cyborgroid/Retro_Analog_Pastel_Computer/cad/README.md

# CAD v3 — 실제 제작용 형상 (STEP · URDF · USDA · 3D 프린팅)

`spec.json` 하나를 원본으로 Rust가 B-rep 솔리드를 만들고, 같은 형상을 여러 형식으로 내보냅니다. 한 번 빌드하면 두 가지 판이 함께 나옵니다.

| 판 | 출력 폴더 | 내용 |
|---|---|---|
| **실제 제작판** | `cad/out/build/` | 지금 살 수 있는 부품과 3D 프린터로 만드는 구성. 19" LCD 패널, 12 V 어댑터, 출력 하우징(베드에 맞게 자동 분할 + 이음), 구매 목록(BOM), 출력 계획, 스위치 플레이트 DXF |
| 컨셉판 (CRT) | `cad/out/` | 워크벤치가 시뮬레이션하는 레트로 CRT 설계 |

웹 워크벤치의 Chassis 탭은 두 판을 모두 표시합니다(기본: 실제 제작판).

```
cad/spec.json ──▶ cad/rust (pastella-cad, truck B-rep) ──▶ cad/out/pastella84.step        STEP AP214, 부품 이름·색, mm
                                                      ├─▶ cad/out/urdf/pastella84.urdf  URDF + STL(링크별·재질별), 질량·관성
                                                      ├─▶ cad/out/pastella84.usda       OpenUSD + UsdPreviewSurface + UsdPhysics
                                                      ├─▶ cad/out/web/pastella84.glb    웹 워크벤치용 glTF (링크 계층 + 관절 정보)
                                                      ├─▶ cad/out/report.json           치수 · 질량 · 검사 결과
                                                      ├─▶ src/js/data/cad.js            워크벤치가 읽는 요약
                                                      └─▶ environments/chassis/dimensions.csv
                   cad/csharp (Pastella.Validate) ──▶ cad/out/validation.md          산출물 교차 검증

실제 제작판은 같은 형식을 cad/out/build/ 에 내고, 추가로:
  cad/out/build/print/*.stl      출력 조각 (베드 위 출력 방향으로 놓인 상태, mm)
  cad/out/build/print-plan.md    조각별 크기 · 무게 · 시간 · 서포트 면적, 분할 이음 목록
  cad/out/build/bom.csv          구매 부품 · 체결 부품 · 출력 부품
  cad/out/build/fab/kb_plate.dxf 키보드 스위치 플레이트 (FR4 1.5t 주문용)
```

## 빌드

```
./cad/build.sh rust          # Only Rust: 형상 생성 + 내보내기 + Rust 자체 검사
./cad/build.sh csharp-rust   # 위와 같은 Rust 빌드 + C# 독립 검증 (기본값)
./cad/build.sh rust --palette "Lavender Haze"   # 컬러웨이 변경 (environments/chassis/colorways.json)
```

필요한 도구: Rust(cargo) 1.80 이상, .NET SDK 10. 처음 빌드할 때 crates.io에서 의존성을 받습니다. 두 판 전체 빌드는 약 22초(대부분 출력 조각 메시 불리언), C# 검증까지 약 25초가 걸립니다. 검사가 하나라도 실패하면 종료 코드 1을 반환합니다.

워크벤치는 `./run.sh`로 연 뒤 터미널에 나오는 **Open Integrated Browser** 주소로 들어갑니다. GLB는 HTTP로만 불러올 수 있어서 `file://`로 열면 웹 v2 모델이 대신 표시됩니다.

## 실제 제작판 — 지금 사서 만들기

### 컨셉판에서 바뀐 것과 이유

| 항목 | 컨셉판 | 실제 제작판 | 이유 |
|---|---|---|---|
| 화면 | 19" 16:10 CRT | **AUO M190PW01 V8** (19" 1440 × 900, LED) + HDMI/VGA/AV 컨트롤러 보드 | 새 CRT는 생산되지 않음. 표시 영역 408 × 255 mm가 컨셉의 화면 크기와 같음 |
| 베젤 | 12 mm | 21 mm | 패널 외곽(428 × 278)과 셸 벽 사이에 클립 나사를 박을 폭이 필요 |
| 모니터 셸 | 뒤가 막힌 일체형 | 앞 45 mm 직선 + 테이퍼, 뒤 덮개 분리, 손잡이 따로 출력 | 패널과 클립이 들어갈 공간, 서포트 없는 출력, 조립 접근 |
| 전원 | 내부 220 V EI 트랜스 | **외부 12 V 5 A DC 어댑터(KC)** + LM2596 5 V 강압 모듈 + 패널 DC 잭 | 출력한 플라스틱 케이스 안에 상용 전원을 넣지 않음 |
| 본체 프레임 | SPCC 판금 | 트레이 바닥의 인서트 보스 6개에 메인보드 직결 | 판금 가공 없이 조립 |
| 상판 ↔ 트레이 | — | 모서리 나사 기둥 4개 (M3 × 35, 아래에서 체결) | |
| 키보드 플레이트 | 강판 | **FR4 1.5t** (PCB 업체 주문, DXF 제공), 나사 구멍 4개, 하판 출력 | PCB 업체에서 싸게 주문 가능 |
| 마우스 | 볼 + 초퍼 | **PMW3360 광학 센서** + D2F 마이크로스위치 + RP2040 Zero | 볼 마우스 부품은 신품이 없음 |
| 다이얼 · 노브 | 형상만 | 16 mm 가변저항 · EC11 엔코더 + 축 구멍(Ø6.2) 있는 출력 노브 | |
| 스위블 | 형상만 | 75 mm 레이지수잔 베어링 | |

### 3D 프린팅

- 기준 프린터: 256 mm급(Bambu Lab P1S · A1, Prusa Core One), 가장자리 여유 4 mm. `spec.json`의 `build.printer`를 바꾸면 분할이 다시 계산됩니다.
- 하우징 그룹마다 서포트가 덜 필요한 방향으로 돌린 뒤, 베드에 들어가도록 자동 분할합니다(상판 · 트레이 · 베젤 · 셸 4조각, 덮개 · 키보드 케이스 · 하판 2조각).
- **분할 이음**: 분할면 안쪽 벽에 결합부를 자동 배치합니다. 이음선 양쪽 13 mm에 M3 인서트 보스 한 쌍을 두고, 그 위에 38 × 9 × 3 mm 연결판을 놓습니다. 보스 밑이 단단한 벽인지, 다른 부품이나 다른 이음과 부딪히지 않는지 검사해서 통과한 자리만 씁니다.
- 결과: 조각 94개, PLA 약 4.5 kg(1 kg 스풀 5개), 출력 시간 하한 약 83시간. 조각별 수치는 `cad/out/build/print-plan.md`에 있습니다. 220 mm급 프린터에서는 큰 조각(상판 · 베젤 · 셸 등)이 들어가지 않습니다.
- 인서트 구멍(Ø4.1 × 6.7)은 프린터마다 수축이 달라서, 먼저 작은 시험 출력으로 맞추세요.

### 조립 순서

1. 출력 조각에 열압입 인서트를 넣습니다(납땜인두 200–220 °C, 수직으로 천천히).
2. 각 하우징 조각을 맞대고 연결판을 M3 × 8로 고정합니다. 맞댄 면에 접착제를 함께 쓰면 더 단단합니다.
3. **본체**: 트레이 보스에 메인보드(M3 × 6) → Gotek · 스피커 · 강압 모듈 · DC 잭 배선 → 상판 앞면에 가변저항 · 토글 · LED 장착 → 상판을 덮고 트레이 아래에서 M3 × 35 네 개로 고정합니다.
4. **모니터**: 베젤을 앞면이 아래로 가게 놓고 패널을 얹은 뒤 클립 8개(M3 × 25)로 고정합니다. 셸을 씌우고 바닥 M3 × 10 두 개로 베젤 블록에 고정한 다음, 뒤 개구부로 손을 넣어 컨트롤러 보드를 바닥 보스(M3 × 6)에 고정합니다. 덮개를 닫고(M3 × 8 네 개) 손잡이를 안쪽에서 고정합니다(M3 × 8 두 개).
5. **스탠드**: 받침 → 레이지수잔 베어링 → 목 → 크래들 순으로 쌓고, 모니터 바닥의 로커를 크래들에 올립니다. 틸트를 유지하려면 로커와 크래들 사이에 펠트를 붙이세요. 무게중심이 축보다 약 120 mm 위에 있습니다.
6. **키보드**: FR4 플레이트에 스위치와 스태빌라이저 → PCB 납땜(또는 핸드와이어) → 플레이트를 케이스 보스에 M2.5 태핑 나사로 고정 → 키캡 → 하판(M3 × 6 네 개)을 닫습니다.
7. **마우스**: 바닥판에 센서 모듈(M2 × 6)과 마이크로스위치 → RP2040 Zero 배선 → 몸체를 덮고 바닥에서 M3 × 6 네 개로 고정합니다.

### 안전 · 확인할 것

- 12 V 어댑터는 KC 인증품을 쓰세요. 모니터 컨트롤러 보드와 본체 강압 모듈에 전원을 나눠 줍니다. 합계 전류(패널 보드 약 2–3 A + 본체 1 A 미만)를 넘지 않게 하세요.
- 패널 · 컨트롤러 보드 치수는 판매처 자료를 기준으로 했습니다. 패널 뒷면 라벨의 정확한 모델명(V8 · LED 백라이트)과 LVDS 커넥터를 구매 전에 확인하세요. 보드 외형은 150 × 90 × 25 mm 덮개 공간으로만 잡았습니다.
- PLA는 60 °C 근처에서 물러집니다. 직사광선이나 뜨거운 차 안에는 두지 말고, 필요하면 PETG로 출력하세요(밀도만 `build.filament`에서 바꾸면 됩니다).

## 두 파이프라인의 역할 (중복 없음)

| | Only Rust | C# & Rust |
|---|---|---|
| 형상 정의 · 생성 | Rust (`model.rs`, `geom.rs`) | 같은 Rust 코드 |
| 질량 · 관성 | Rust (폐곡면 다면체 적분) | 같은 Rust 결과 |
| 형상 검사 (밀폐 · 간섭 · 관절 스윕) | Rust (`check.rs`) | 같은 Rust 결과 |
| 내보내기 | Rust (`export.rs`) | 같은 Rust 결과 |
| 산출물 교차 검증 | — | C# (`Pastella.Validate`): URDF ↔ USDA ↔ STEP ↔ GLB ↔ report ↔ spec |

형상은 Rust에만 정의되어 있습니다. C#은 형상을 다시 만들지 않고, 내보낸 파일을 다시 읽어 서로 맞는지만 확인합니다. 이전의 Python(OpenCASCADE) 생성기는 같은 형상을 두 번 정의하는 중복이라 제거했습니다.

## 검사 항목

**Rust 자체 검사 (`report.json` → `checks`)**

- 모든 부품이 닫힌 솔리드인지 (테셀레이션 메시가 열린 모서리 없이 닫혀야 함)
- 기본 자세에서 모든 부품 쌍의 겹침 부피 (삼각형 분리축 판정 + 점 샘플링, 1 mm³ 초과면 실패)
- 가동 관절 63개 스윕: 회전 관절은 하한·상한, 직선 관절은 끝까지, 연속 관절은 90°·180°·270°에서 움직이는 부분과 나머지 부품의 간섭
- STEP을 다시 파싱해 솔리드 수가 맞는지

**C# 독립 검증 (`validation.md`)**: URDF 트리(단일 루트 · 비순환), 링크별 질량 > 0 · 관성 양의 정부호 · 삼각 부등식, STL 밀폐성, 키 49개 = 직선 관절 49개 · 키 이동 4 mm · 틸트/스위블 한계가 spec과 일치, USDA와 URDF의 질량 · 관절 · 한계 일치(도 ↔ 라디안), STEP 스키마 · 단위 · 부품 이름 · 색 · 참조, GLB 노드. 산출물에 일부러 결함을 넣었을 때 실패하는 것도 확인했습니다(USDA 질량 변조, STEP 색 삭제, URDF 관절 타입 변경, STL 정점 이동).

**외부 도구 확인 (빌드 과정에는 포함되지 않음, 개발 중 수동 확인)**: OpenCASCADE가 STEP 솔리드 234개를 모두 읽었고 BRepCheck 불량 0건, 전체 부피는 Rust 계산과 0.03 % 이내였습니다. Pixar USD가 USDA를 열었고(메시 148 · 강체 69 · 관절 69), ROS 2 `check_urdf`가 URDF를 파싱했으며, Blender가 GLB를 렌더링했습니다.

## 참고 사진에서 배운 것

실물 사진 148장(목록과 라이선스: [environments/chassis/references.md](../environments/chassis/references.md))에서 얻은 형태 언어를 v3에 반영했습니다.

| 참고한 실물 | 관찰 | v3 반영 |
|---|---|---|
| 모든 실물 키보드 (C64C, MSX, Canon Cat) | 키 피치 19.05 mm, 기성 키캡 규격 | 피치 31 → **19.05 mm**, MX 호환 플레이트(1.5 mm 강판, 14 mm 컷아웃, 6.25u 스태빌라이저 컷아웃), SHIFT · ENTER 1.75u, SPACE 6.25u |
| C64C, MSX | 쐐기형 케이스, 뒤쪽 접이식 다리 | 6.1° 쐐기 케이스, 접이식 다리 2개(0–95°) |
| MSX HitBit, Canon Cat, Amstrad | 기능 키만 다른 색 | 넓은 키는 포인트 색(keyB) |
| Macintosh Color Classic | 화면이 한 단 들어간 액자형 베젤 | 화면 둘레 8 mm 폭 · 6 mm 깊이 계단 리세스 |
| Color Classic, iMac G3 | 평평한 바닥, 뒤로 갈수록 좁아지는 몸체 | 바닥은 평평하게, 윗면만 뒤로 기울어진 후면 셸(뒷면 60 % × 70 %) |
| iMac G3, Canon Cat, Sharp X68000 | 무거운 본체에 손잡이 | 후면 나사 고정식 손잡이(손가락 공간 88 × 26 mm) |
| CRT 실물 비례 | 19" CRT를 154 mm 깊이로 만들 수 없음 | 125° 슈퍼슬림 CRT 기준 깊이 **266 mm** (0.52 × 대각 mm + 베젤 15) |
| Apple IIc (Snow White) | 측면 가로 홈 | 본체 측면 가로 슬롯 통풍구 3열 × 5단 |
| Bandai Pippin | 원형 타공 스피커 그릴 | 스피커 위 Ø3.2 타공 42개 |
| Sega SC-3000, Apple 로고 | 컬러 스트라이프 | 본체 전면과 키보드에 파스텔 4색 스트라이프 |
| MSX (투톤) | 하부는 진하고 상부는 밝음 | 하부 트레이를 본체 색의 88 % 명도로 |
| Apple M0100 마우스 | 버튼이 분리된 판 | 박스형 몸체 + 경첩식 버튼 판(3° 누름) |

### 이미지 데이터 학습 (자동 분석)

`tools/refs/`가 레퍼런스 이미지를 대량으로 받아 분석합니다. 이 작업 시점에는 Wikimedia Commons 레트로 컴퓨터 사진 2,578장을 모았고, 그중 다운로드가 끝난 568장(중복 제거 후)으로 분석했습니다. 수집은 1만 장을 목표로 계속되며, 다시 실행하면 결과가 갱신됩니다. 요약은 [references-web.md](../environments/chassis/references-web.md)에 있습니다.

| 분석 결과 | 설계 반영 |
|---|---|
| 실물 기기의 주색은 베이지 · 크림(#cfc3ac 15.7 %, #c0b4a1 15.3 %, #ded2bb 12.8 %), 포인트는 하늘 · 청회색(#81abd0, #a8b9c8)과 피치(#e0a087) | 학습 컬러웨이 **Archive Beige**(실물 색)와 **Archive Pastel**(같은 색상 구조를 파스텔 대역으로 올림)을 추가. Archive Pastel을 CAD 빌드 기본값과 웹 첫 화면 기본값으로 지정(다른 컬러웨이도 그대로 선택 가능) |
| 키보드 뒤쪽 가로 홈 띠, 기능키 세로 열(C64C · C128), 모니터 받침(Apple IIc), 상단 통풍 홈(Mac) | 받침 · 통풍 홈 · 경사 키보드는 v3에 이미 반영됨. 기능키 열은 8 × 8 매트릭스와 시뮬레이션을 함께 바꿔야 해서 다음 개정 후보로 남김 |

```
python3 tools/refs/commons.py 10000        # 공개 라이선스 사진 수집 (요청 간격을 지키므로 수 시간 걸림)
python3 tools/refs/ingest.py                # 다운로드 + 분석 (--analyse-only: 받은 것만 분석)
python3 tools/refs/palette.py               # 학습 팔레트 → 컬러웨이 값 출력
```

## 간섭 검사로 고친 설계 결함

간섭 · 스윕 검사에서 찾은 결함을 실제 메커니즘으로 고쳤습니다. 0건으로 만들려고 검사를 완화하지는 않았습니다.

- **키 스위치**: MX 스템은 키캡과 함께 움직이는 슬라이더입니다. 하우징에 스템 구멍(Ø4.2, 깊이 5 mm)을 내고, 스템은 키 링크에 붙였습니다. 4 mm 끝까지 누르면 키캡 소켓이 하우징 윗면에 닿습니다(바텀아웃).
- **모니터 틸트**: 평평한 바닥을 바닥면 위의 축으로 돌리면 앞쪽이 받침을 파고듭니다. 축을 바닥보다 20 mm 위에 두고, 본체 쪽 볼록 로커(R40)가 받침 쪽 동심 오목 크래들(R40.5) 안에서 돌게 했습니다. 이 때문에 스탠드 높이가 40 → 50 mm가 됐습니다. 틸트축은 무게중심 바로 아래(앞뒤 오차 0.0 mm)에 자동으로 배치되며, 무게중심이 축보다 약 133 mm 위에 있으므로 12°에서 버티려면 마찰 토크가 약 3.6 N·m 필요합니다.
- **전원 토글**: 레버가 판을 뚫고 회전했습니다. 판에 8 × 16 mm 레버 구멍을 내고, 회전축을 판 뒷면에 두었습니다.
- **CRT 주변**: 디가우싱 코일은 유리 바깥(전면 유리 둘레)으로, 편향 요크는 넥에 걸리도록, 넥 보드는 넥 뒤로 옮겼습니다.

## 좌표계와 단위

- STEP: mm, X = 사용자 오른쪽, Y = 사용자에게서 멀어지는 쪽(정면이 −Y), Z = 위, 책상 윗면 Z = 0
- URDF · USDA: 같은 축, m · kg (USDA는 `upAxis = "Z"`, `metersPerUnit = 1`)
- GLB: glTF 규약(Y 위, +Z가 사용자 쪽, m). 워크벤치는 ×10 해서 1 칸 = 100 mm로 씁니다.

URDF의 루트 링크는 질량 없는 `desk`이고, 본체 · 키보드 · 마우스가 고정 관절로 붙습니다. USDA에서는 이 세 고정 관절이 월드에 고정되고 각각 `PhysicsArticulationRootAPI`를 가집니다. 충돌 형상은 링크별 경계 상자로 단순화했습니다.

## 한계와 제작 전 확인할 것

- **truck 커널의 한계**: truck은 필렛 기능이 없어서, 하우징은 수직 모서리만 둥글고(R8–R14) 윗면 모서리는 각져 있습니다. 사출 금형용 빼기 구배, 보스, 리브, 스냅도 아직 모델링하지 않았습니다. STEP을 CAD에서 열어 금형 설계 단계에서 추가해야 합니다.
- **CRT 튜브**: 19" 16:10 슈퍼슬림 CRT는 기성품으로 구할 수 없습니다. 튜브는 외곽 형상(봉투)과 실제에 가까운 유리 질량(9.4 kg)으로만 모델링했습니다. 실제로 만들려면 같은 외곽에 맞는 LCD 패널과 곡면 아크릴 커버로 대체하는 방안을 함께 검토하세요([parts-sourcing.md](../environments/circuit/parts-sourcing.md)).
- **생략한 부품과 질량**: 케이블(키보드 코일 · 마우스 · 비디오)은 휘는 부품이라 생략했습니다. 내부 기판 부품은 덩어리로 단순화했고, 질량은 재질 밀도 × 부피로 계산하되 트랜스 · CRT · 요크 · 플라이백 같은 주요 부품만 실측급 값으로 지정했습니다.
- **STEP의 부품 이름**: 각 솔리드 이름(`MANIFOLD_SOLID_BREP`)으로 넣었습니다. 색은 OpenCASCADE가 읽는 것을 확인했지만, 이름이 솔리드별로 표시되는지는 CAD 프로그램마다 다를 수 있습니다.

## 소스 구성

```
cad/spec.json                 사양 (치수 · 키 배열 · 재질 · 밀도) — 이 파일만 고치면 됩니다
cad/rust/src/geom.rs          불리언 없는 B-rep 조립: 공유 모서리 면 → 방향 정렬(BFS) → 닫힌 솔리드
cad/rust/src/model.rs         부품 · 링크 · 관절 정의 (참고 사진 반영 지점에 [ref: …] 주석)
cad/rust/src/mesh.rs          메시 질량 · 관성, 고유값, 쿼터니언
cad/rust/src/check.rs         간섭 · 관절 스윕
cad/rust/src/export.rs        STEP · URDF/STL · USDA · GLB
cad/rust/src/main.rs          파이프라인 · report · 웹 데이터 · dimensions.csv
cad/csharp/Pastella.Validate  C# 교차 검증기
cad/build.sh                  두 파이프라인 실행
```
