cyborgroid/Retro_Analog_Pastel_Computer/environments/chassis/monitor-wide.md

# 와이드 슬림 CRT 모니터 설계 메모

> **v3 (CAD) 변경**: 19" CRT를 154 mm 깊이로 만들 수는 없어서, CAD v3는 125° 슈퍼슬림 CRT 기준 깊이 **266 mm**(0.52 × 대각 mm + 베젤 15)를 씁니다. 스탠드도 동심 로커 · 크래들 틸트 기구를 넣느라 50 mm가 됐습니다. 이 문서의 수치는 웹 v2 파라메트릭 모델 기준이고, 실제 제작 치수는 [cad/README.md](../../cad/README.md)와 [dimensions.csv](dimensions.csv)를 따릅니다.

## 왜 바꿨나

v1의 14" 4:3 모니터는 베젤이 두껍고(약 35 mm, 하단 턱 포함 60 mm 이상) 화면이 작았습니다. 그 결과 정면 면적 중 화면이 차지하는 비율이 약 55 %에 그쳐 답답해 보였습니다. v2에서는 화면을 키우고 테두리를 줄였습니다.

## 기본 사양 (v2)

| 항목 | 값 |
|---|---|
| 화면 | 19" 대각, 16:10 |
| 가시 영역 | 409 × 256 mm |
| 베젤 | 12 mm (좌 · 우 · 상), 하단 턱 20 mm 추가 |
| 외형 | 437 × 334 mm (스탠드 30 mm 포함) |
| 깊이 | 154 mm (슬림 넥, 콘셉트 값) |
| 화면 점유율 | 정면의 약 79 % |
| 조작부 | 하단 턱 오른쪽에 BRIGHT · V-HOLD · H-SIZE 노브(Ø11 mm), 왼쪽에 전원 LED |

## 파라메트릭 식 (mm)

```
a      = 화면 비율 (4/3, 1.6, 16/9)
w      = 대각(in) × 25.4 × a / √(a² + 1)
h      = w / a
W      = w + 2 × (베젤 + 2)
H      = h + 2 × (베젤 + 2) + 20      ← 하단 턱 20 mm
깊이   = 15(베젤) + 62 + 0.3 × h        ← 후면 셸 테이퍼
점유율 = (w × h) / (W × H)
```

## 프리셋 비교

| 프리셋 | 화면 | 외형 W × H | 점유율 |
|---|---|---|---|
| 클래식 14" 4:3 · 베젤 30 mm | 284 × 213 | 348 × 297 | 59 % |
| **와이드 19" 16:10 · 베젤 12 mm** | 409 × 256 | 437 × 304 | 79 % |
| 시네마 22" 16:9 · 베젤 8 mm | 487 × 274 | 507 × 314 | 84 % |

(외형 H는 스탠드를 뺀 값입니다.)

## 3D 구성

베젤(구멍 뚫린 압출), 곡면 화면(최대 5 mm 볼록), 화면 테두리, CRT 튜브(선반 회전체, 화면 비율에 맞게 타원 스케일), 편향 요크와 넥 보드, 플라이백과 애노드 선, 디가우싱 코일, 테이퍼 후면 셸(뒷면 60 % 축소, 통풍 슬롯 16개, 정격 라벨), 틸트 스탠드, 비디오 케이블로 구성됩니다.
