cyborgroid/Retro_Analog_Pastel_Computer/environments/circuit/mouse-encoder.md

# 볼 마우스 엔코더

## 기구

- 고무 코팅 강구 Ø22 mm가 X 롤러(볼 오른쪽, 축 Z 방향)와 Y 롤러(볼 뒤쪽, 축 X 방향)를 굴립니다.
- 각 롤러 끝에 12슬롯 초퍼 휠이 있고, 슬롯형 포토인터럽터 2개(A, B, Everlight ITR9608)가 슬롯 피치의 1/4만큼 어긋나 있습니다. 그래서 A와 B는 90° 위상차를 가집니다.
- 회로: +5V → 220 Ω → IR LED, 포토트랜지스터 컬렉터 10 kΩ 풀업 → 74HC14 슈미트 인버터 → PIO(ATmega328P).

## 신호

| 신호 | 레벨 | 의미 |
|---|---|---|
| XA, XB | TTL | X축 직교 쌍 |
| YA, YB | TTL | Y축 직교 쌍 |

- 오른쪽(+X) 이동: A가 B보다 90° 앞섭니다.
- 왼쪽(−X) 이동: B가 앞섭니다.
- PIO는 A와 B의 모든 엣지를 세어(4체배) 슬롯 12개당 48카운트를 얻습니다.

## 시뮬레이션 상수

- 화면 속도 1 px/s당 0.35 Hz(`C.QK`). 패드에서 300 px/s로 드래그하면 약 105 Hz입니다.
- 카운터 증분은 이동 px × 0.35 × 4입니다.
- Instrument의 "마우스 직교" 프리셋은 자동 이동(리사주 경로)을 켜서 방향 반전을 보여 줍니다.
