cyborgroid/Retro_Analog_Pastel_Computer/environments/circuit/psg.md

# PSG 사운드

## 구성

- 실제 부품: Raspberry Pi Pico(RP2040)가 AY-3-8910 호환 레지스터를 74LVC245(5V→3.3V)를 거쳐 받고, PWM(GP15)으로 출력합니다. 원본 AY-3-8910은 단종되었습니다.
- 톤 채널 A · B · C: 50 % 구형파, 채널별 4비트 볼륨
- 노이즈: 17비트 LFSR
- 출력: PWM → RC 저역통과(1 kΩ + 10 nF, fc ≈ 16 kHz) → 전면 VOL 다이얼(10 kΩ A) → LM386N-1(+5V) → 57 mm 8 Ω 스피커

## 벤치 동작

- Circuit 탭 PSG 카드에서 **스피커 켜기**를 누르면 WebAudio로 실제 소리가 납니다(브라우저 정책상 사용자 클릭이 필요).
- 채널을 켜면 지속음이 납니다. 음정은 C4–C6 펜타토닉 위주로 고를 수 있습니다.
- 키를 누를 때마다 `keyboard-matrix.csv`의 `psg_click_hz` 음정으로 90 ms 클릭음이 납니다.
- **부팅 징글**은 C5 – E5 – G5 – C6 – B5 – G5 – A5 – C6을 160 ms 간격으로 재생합니다.
- PSG나 스피커에 고장을 주입하거나, 클럭이 멈추거나, 전원이 꺼지면 무음이 됩니다.
- Instrument 오실로스코프의 `PSG 오디오 출력` 신호는 같은 채널 설정으로 계산한 파형입니다.
