cyborgroid/Retro_Analog_Pastel_Computer/environments/chassis/dimensions.csv

module | width_mm | height_mm | depth_mm | mass_kg | shell_material | wall_mm | controls | key_parts
base_unit | 440 | 113 | 359.1 | 4.597 | ABS + SPCC chassis | 2.5 | rotary VOL, rotary TONE, toggle power | PX-80 mainboard, linear PSU, USB storage bay
monitor_19w | 437.2 | 353.8 | 306 | 13.212 | ABS | 2.5 | BRIGHT, V-HOLD, H-SIZE knobs | 19in 16:10 super-slim CRT, yoke, flyback, degauss coil, carry handle
keyboard | 300 | 42.8 | 150 | 0.663 | ABS | 2 | - | 49 keys, MX-compatible, 19.05 mm pitch, 8x8 matrix, 1N4148 x49
mouse | 62 | 31 | 100 | 0.085 | ABS | 1.8 | - | rubber ball 22mm, chopper rollers x2, photo-interrupters x4
