cyborgroid/Retro_Analog_Pastel_Computer/environments/chassis/references-web.md

# 웹 레퍼런스 이미지 분석 (자동 생성)

`tools/refs/collect.js`로 브라우저에서 모은 이미지를 `tools/refs/ingest.py`가 원본 사이트에서 받아 분석한 결과입니다. 이미지는 저장소에 넣지 않습니다(`references/`, git 제외).

- 수집 5460개 → 다운로드 2078개 → 중복 제거 후 2002개, 파스텔 비중 15 % 이상 438개
- 검색어: commons: retro computers (2002)

## 학습한 파스텔 팔레트 (전체 이미지의 파스텔 픽셀 군집)

| 색 | 비중 |
|---|---|
| `#c0b4a1` | 15.8 % |
| `#cec2ab` | 14.6 % |
| `#dacebb` | 12.4 % |
| `#bcae8b` | 10.1 % |
| `#a6bbcd` | 7.9 % |
| `#eadcc4` | 7.6 % |
| `#d9b68a` | 7.0 % |
| `#c49a76` | 6.2 % |
| `#c4dcee` | 6.1 % |
| `#f6ecd5` | 4.4 % |
| `#edd19a` | 4.1 % |
| `#859aca` | 3.9 % |

## 출처 사이트 상위 25

| 사이트 | 이미지 |
|---|---|
| thumb.wikimedia.org | 1978 |
| upload.wikimedia.org | 24 |
