cyborgroid/Retro_Analog_Pastel_Computer/environments/chassis/references.md

# 실물 참고 사진 (Wikimedia Commons)

v3 설계에 반영한 형태 언어를 배운 실물 사진 목록입니다. 사진은 저장소에 넣지 않고 출처와 라이선스만 기록합니다.
처음 요청한 Google 이미지 검색 결과 페이지는 자동 수집이 차단되어(봇 확인), 같은 주제의 공개 라이선스 사진으로 대신했습니다.
반영 내용은 [cad/README.md](../../cad/README.md)의 "참고 사진에서 배운 것" 표에 있습니다.

총 148장 · 검색어별로 묶음

## iMac G3

- [Apple iMac G3 Indigo slot-loading drive-2006-02-14.jpg](https://commons.wikimedia.org/wiki/File:Apple_iMac_G3_Indigo_slot-loading_drive-2006-02-14.jpg) — CC BY 2.0
- [IMac-IMG 7042.jpg](https://commons.wikimedia.org/wiki/File:IMac-IMG_7042.jpg) — CC BY-SA 2.0 fr
- [IMac G3 greenhouse.jpg](https://commons.wikimedia.org/wiki/File:IMac_G3_greenhouse.jpg) — CC BY-SA 2.0
- [Imac G3 Blue Dalmatian 3q back.jpg](https://commons.wikimedia.org/wiki/File:Imac_G3_Blue_Dalmatian_3q_back.jpg) — CC BY-SA 4.0
- [Imac G3 Blueberry side.jpg](https://commons.wikimedia.org/wiki/File:Imac_G3_Blueberry_side.jpg) — CC BY-SA 4.0
- [Mac OS 9 on iMac G3.jpg](https://commons.wikimedia.org/wiki/File:Mac_OS_9_on_iMac_G3.jpg) — CC BY 2.0
- [Museo de Informática Histórica (MIH) – UNIZAR – Apple iMac G3.jpg](https://commons.wikimedia.org/wiki/File:Museo_de_Inform%C3%A1tica_Hist%C3%B3rica_(MIH)_%E2%80%93_UNIZAR_%E2%80%93_Apple_iMac_G3.jpg) — CC BY-SA 4.0
- [SimCity 2000 being played on an iMac G3.jpg](https://commons.wikimedia.org/wiki/File:SimCity_2000_being_played_on_an_iMac_G3.jpg) — CC BY-SA 2.0

## Macintosh Color Classic

- [Macintosh, Google NY office computer museum cropped.png](https://commons.wikimedia.org/wiki/File:Macintosh,_Google_NY_office_computer_museum_cropped.png) — CC BY 2.0
- [Macintosh Classic.jpg](https://commons.wikimedia.org/wiki/File:Macintosh_Classic.jpg) — CC BY-SA 4.0
- [Macintosh Classic 2.jpg](https://commons.wikimedia.org/wiki/File:Macintosh_Classic_2.jpg) — CC BY-SA 2.5
- [Macintosh Color Classic.jpg](https://commons.wikimedia.org/wiki/File:Macintosh_Color_Classic.jpg) — CC BY-SA 3.0
- [Macintosh Color Classic II.JPG](https://commons.wikimedia.org/wiki/File:Macintosh_Color_Classic_II.JPG) — CC0
- [Macintosh Colour Classic.jpg](https://commons.wikimedia.org/wiki/File:Macintosh_Colour_Classic.jpg) — CC BY-SA 4.0
- [Macintosh Colour Classic 1994.jpg](https://commons.wikimedia.org/wiki/File:Macintosh_Colour_Classic_1994.jpg) — CC BY-SA 3.0
- [Macintosh Colour Classic 1994 (retouched).jpg](https://commons.wikimedia.org/wiki/File:Macintosh_Colour_Classic_1994_(retouched).jpg) — CC BY-SA 3.0
- [Macintosh classic.jpg](https://commons.wikimedia.org/wiki/File:Macintosh_classic.jpg) — CC BY-SA 3.0

## Macintosh Classic computer

- [Apple Macintosh Classic, some files (52318598867).jpg](https://commons.wikimedia.org/wiki/File:Apple_Macintosh_Classic,_some_files_(52318598867).jpg) — CC BY 2.0
- [Apple Macintosh Classic (24347566053).jpg](https://commons.wikimedia.org/wiki/File:Apple_Macintosh_Classic_(24347566053).jpg) — CC BY-SA 2.0
- [Inside an Apple Macintosh Classic II.jpg](https://commons.wikimedia.org/wiki/File:Inside_an_Apple_Macintosh_Classic_II.jpg) — CC BY-SA 4.0
- [Macintosh Classic II, 2.jpg](https://commons.wikimedia.org/wiki/File:Macintosh_Classic_II,_2.jpg) — CC BY-SA 4.0
- [Macintosh Classic II, 3.jpg](https://commons.wikimedia.org/wiki/File:Macintosh_Classic_II,_3.jpg) — CC BY-SA 4.0
- [Macintosh Classic II 006.jpg](https://commons.wikimedia.org/wiki/File:Macintosh_Classic_II_006.jpg) — CC BY-SA 4.0
- [Steve Jobs and Macintosh computer, January 1984, by Bernard Gotfryd - edited.jpg](https://commons.wikimedia.org/wiki/File:Steve_Jobs_and_Macintosh_computer,_January_1984,_by_Bernard_Gotfryd_-_edited.jpg) — Public domain

## Sharp X68000

- [Sharp X68000 Personal Computer Teardown (17267156903).jpg](https://commons.wikimedia.org/wiki/File:Sharp_X68000_Personal_Computer_Teardown_(17267156903).jpg) — CC BY 2.0
- [Sharp X68000 XVI.jpg](https://commons.wikimedia.org/wiki/File:Sharp_X68000_XVI.jpg) — CC BY-SA 2.0
- [Sharp X68000 XVI back.jpg](https://commons.wikimedia.org/wiki/File:Sharp_X68000_XVI_back.jpg) — CC BY-SA 2.0
- [Sharp X68030 and X68000 Expert.jpg](https://commons.wikimedia.org/wiki/File:Sharp_X68030_and_X68000_Expert.jpg) — CC BY-SA 4.0
- [X68000.jpg](https://commons.wikimedia.org/wiki/File:X68000.jpg) — Public domain
- [X68000ACE-HD.JPG](https://commons.wikimedia.org/wiki/File:X68000ACE-HD.JPG) — CC BY-SA 3.0
- [X68000 EXPERT2.JPG](https://commons.wikimedia.org/wiki/File:X68000_EXPERT2.JPG) — Public domain

## Panasonic FS-A1 MSX

- [MSX FS-A1WX, Seattle, 2023-09-30.jpg](https://commons.wikimedia.org/wiki/File:MSX_FS-A1WX,_Seattle,_2023-09-30.jpg) — CC BY-SA 4.0
- [MSX FS-A1WX.JPG](https://commons.wikimedia.org/wiki/File:MSX_FS-A1WX.JPG) — CC BY-SA 3.0
- [Panasonic FS-A1 20180519a.jpg](https://commons.wikimedia.org/wiki/File:Panasonic_FS-A1_20180519a.jpg) — CC BY-SA 4.0

## Sony HitBit

- [MSX-FAN UserRom.jpg](https://commons.wikimedia.org/wiki/File:MSX-FAN_UserRom.jpg) — CC BY-SA 3.0
- [MSX BASIC interpreter running simple program.jpg](https://commons.wikimedia.org/wiki/File:MSX_BASIC_interpreter_running_simple_program.jpg) — CC BY 2.0
- [MSX Stub.png](https://commons.wikimedia.org/wiki/File:MSX_Stub.png) — Public domain
- [MSX Turbo R (1990).jpg](https://commons.wikimedia.org/wiki/File:MSX_Turbo_R_(1990).jpg) — CC BY-SA 2.0
- [Sony-HitBit--Museum-Enter-6094861.jpg](https://commons.wikimedia.org/wiki/File:Sony-HitBit--Museum-Enter-6094861.jpg) — CC BY-SA 3.0
- [Sony HitBit HB-10P (Transparent Background).png](https://commons.wikimedia.org/wiki/File:Sony_HitBit_HB-10P_(Transparent_Background).png) — Public domain
- [Sony HitBit HB-10P (White Background).jpg](https://commons.wikimedia.org/wiki/File:Sony_HitBit_HB-10P_(White_Background).jpg) — Public domain
- [Sony HitBit HB-501F (16782409110).jpg](https://commons.wikimedia.org/wiki/File:Sony_HitBit_HB-501F_(16782409110).jpg) — CC BY 2.0
- [Sony Hit Bit.jpg](https://commons.wikimedia.org/wiki/File:Sony_Hit_Bit.jpg) — CC BY 2.0
- [VRoBIT HC3000 MSX computer.jpg](https://commons.wikimedia.org/wiki/File:VRoBIT_HC3000_MSX_computer.jpg) — CC BY-SA 2.0

## NEC PC-6001

- [NEC PC-6001.jpg](https://commons.wikimedia.org/wiki/File:NEC_PC-6001.jpg) — CC BY 4.0
- [NEC PC-6001 no brown seat.jpg](https://commons.wikimedia.org/wiki/File:NEC_PC-6001_no_brown_seat.jpg) — CC BY 4.0
- [PC-6001 withBrownsheet.png](https://commons.wikimedia.org/wiki/File:PC-6001_withBrownsheet.png) — CC BY-SA 4.0
- [PC-6001mkII.jpg](https://commons.wikimedia.org/wiki/File:PC-6001mkII.jpg) — CC BY-SA 3.0
- [PC-6001mkIISR.png](https://commons.wikimedia.org/wiki/File:PC-6001mkIISR.png) — CC BY-SA 4.0

## Toshiba Pasopia

- [PasopiaHX-21.JPG](https://commons.wikimedia.org/wiki/File:PasopiaHX-21.JPG) — CC BY-SA 3.0
- [Pasopia 7.jpg](https://commons.wikimedia.org/wiki/File:Pasopia_7.jpg) — CC0
- [Pasopia with monitor.jpg](https://commons.wikimedia.org/wiki/File:Pasopia_with_monitor.jpg) — CC0
- [Toshiba HX-10 & Konami's Tennis at Japan Impact 20190216a.jpg](https://commons.wikimedia.org/wiki/File:Toshiba_HX-10_%26_Konami%27s_Tennis_at_Japan_Impact_20190216a.jpg) — CC BY 2.0
- [Toshiba HX-10 01.jpg](https://commons.wikimedia.org/wiki/File:Toshiba_HX-10_01.jpg) — CC BY-SA 2.5
- [Toshiba HX-20 Tietokonemuseo.JPG](https://commons.wikimedia.org/wiki/File:Toshiba_HX-20_Tietokonemuseo.JPG) — Public domain
- [Toshiba Pasopia PA7010 Toshiba Science Museum.jpg](https://commons.wikimedia.org/wiki/File:Toshiba_Pasopia_PA7010_Toshiba_Science_Museum.jpg) — CC BY-SA 3.0

## Sharp X1 computer

- [Sharp X1 computer set.jpg](https://commons.wikimedia.org/wiki/File:Sharp_X1_computer_set.jpg) — CC BY 4.0

## Commodore 64C

- [C64c system.jpg](https://commons.wikimedia.org/wiki/File:C64c_system.jpg) — CC BY-SA 2.5
- [Commodore-64-Computer-FL.jpg](https://commons.wikimedia.org/wiki/File:Commodore-64-Computer-FL.jpg) — Public domain
- [Commodore64.jpg](https://commons.wikimedia.org/wiki/File:Commodore64.jpg) — CC BY-SA 2.5
- [Commodore 64C - PD.jpg](https://commons.wikimedia.org/wiki/File:Commodore_64C_-_PD.jpg) — CC BY-SA 4.0
- [Commodore 64C - PD - bok.jpg](https://commons.wikimedia.org/wiki/File:Commodore_64C_-_PD_-_bok.jpg) — CC BY-SA 4.0
- [Commodore 64C vista dall'alto.jpg](https://commons.wikimedia.org/wiki/File:Commodore_64C_vista_dall%27alto.jpg) — CC0
- [Commodore 64C with joysticks.jpg](https://commons.wikimedia.org/wiki/File:Commodore_64C_with_joysticks.jpg) — CC BY 4.0
- [Commodore 64 II (Commodore 64C).jpg](https://commons.wikimedia.org/wiki/File:Commodore_64_II_(Commodore_64C).jpg) — CC BY-SA 4.0
- [Commodore Computers of the 1980s.jpg](https://commons.wikimedia.org/wiki/File:Commodore_Computers_of_the_1980s.jpg) — Public domain
- [Commodore Computers of the 1980s mod.jpg](https://commons.wikimedia.org/wiki/File:Commodore_Computers_of_the_1980s_mod.jpg) — CC0

## Apple IIc

- [Apple Computer History 1979-1989.jpg](https://commons.wikimedia.org/wiki/File:Apple_Computer_History_1979-1989.jpg) — CC BY-SA 2.0
- [Apple IIC case inside.jpg](https://commons.wikimedia.org/wiki/File:Apple_IIC_case_inside.jpg) — CC BY-SA 4.0
- [Apple IIc (I198502).jpg](https://commons.wikimedia.org/wiki/File:Apple_IIc_(I198502).jpg) — Public domain
- [Apple IIc Plus (back).jpg](https://commons.wikimedia.org/wiki/File:Apple_IIc_Plus_(back).jpg) — CC BY-SA 3.0
- [Apple IIc Plus (front).jpg](https://commons.wikimedia.org/wiki/File:Apple_IIc_Plus_(front).jpg) — CC BY-SA 3.0
- [Apple IIc in funzione.jpg](https://commons.wikimedia.org/wiki/File:Apple_IIc_in_funzione.jpg) — Public domain
- [Apple IIc presentazione.jpg](https://commons.wikimedia.org/wiki/File:Apple_IIc_presentazione.jpg) — Public domain
- [Apple IIc top view.jpg](https://commons.wikimedia.org/wiki/File:Apple_IIc_top_view.jpg) — GPL
- [Apple IIc with monitor.jpg](https://commons.wikimedia.org/wiki/File:Apple_IIc_with_monitor.jpg) — CC BY 3.0
- [Apple iic in funzione.jpg](https://commons.wikimedia.org/wiki/File:Apple_iic_in_funzione.jpg) — Public domain

## Bandai Pippin

- [Apple Bandai Pippin - Inside Top Case Hidden Signatures.png](https://commons.wikimedia.org/wiki/File:Apple_Bandai_Pippin_-_Inside_Top_Case_Hidden_Signatures.png) — CC BY-SA 4.0
- [Bandai-Apple-Pippin-Console-BL.jpg](https://commons.wikimedia.org/wiki/File:Bandai-Apple-Pippin-Console-BL.jpg) — Public domain
- [Bandai-Apple-Pippin-Console-BR.jpg](https://commons.wikimedia.org/wiki/File:Bandai-Apple-Pippin-Console-BR.jpg) — Public domain
- [Bandai-Apple-Pippin-Console-FL.jpg](https://commons.wikimedia.org/wiki/File:Bandai-Apple-Pippin-Console-FL.jpg) — Public domain
- [Bandai-Apple-Pippin-Console-FR.jpg](https://commons.wikimedia.org/wiki/File:Bandai-Apple-Pippin-Console-FR.jpg) — Public domain
- [Bandai-Apple-Pippin-Modem.jpg](https://commons.wikimedia.org/wiki/File:Bandai-Apple-Pippin-Modem.jpg) — Public domain
- [Bandai Pippin in Computer History Museum - California (Gold).jpg](https://commons.wikimedia.org/wiki/File:Bandai_Pippin_in_Computer_History_Museum_-_California_(Gold).jpg) — CC BY 2.0
- [Mch2022-apple-pippin.jpg](https://commons.wikimedia.org/wiki/File:Mch2022-apple-pippin.jpg) — CC BY-SA 4.0
- [Pippin-Atmark-Console-Set.jpg](https://commons.wikimedia.org/wiki/File:Pippin-Atmark-Console-Set.jpg) — Public domain
- [Pippinfront.jpg](https://commons.wikimedia.org/wiki/File:Pippinfront.jpg) — CC BY-SA 3.0

## FM Towns

- [FM-TOWNS and X68000.jpg](https://commons.wikimedia.org/wiki/File:FM-TOWNS_and_X68000.jpg) — CC BY-SA 2.0
- [FM-Towns-Marty-Console-Back.jpg](https://commons.wikimedia.org/wiki/File:FM-Towns-Marty-Console-Back.jpg) — Public domain
- [FM-Towns-Marty-Console-Set.jpg](https://commons.wikimedia.org/wiki/File:FM-Towns-Marty-Console-Set.jpg) — Public domain
- [FM-Towns-Marty-Console-Set.png](https://commons.wikimedia.org/wiki/File:FM-Towns-Marty-Console-Set.png) — Public domain
- [FM Towns II.jpg](https://commons.wikimedia.org/wiki/File:FM_Towns_II.jpg) — CC BY 3.0
- [FM Towns running ZakMcKracken.jpg](https://commons.wikimedia.org/wiki/File:FM_Towns_running_ZakMcKracken.jpg) — CC BY 3.0
- [Fujitsu FM Towns (1).jpg](https://commons.wikimedia.org/wiki/File:Fujitsu_FM_Towns_(1).jpg) — CC BY 2.0

## Macintosh 128K

- [Computer macintosh 128k, 1984 (all about Apple onlus).jpg](https://commons.wikimedia.org/wiki/File:Computer_macintosh_128k,_1984_(all_about_Apple_onlus).jpg) — CC BY 3.0
- [Macintosh 128K - Macintosh mouse (3655725631).jpg](https://commons.wikimedia.org/wiki/File:Macintosh_128K_-_Macintosh_mouse_(3655725631).jpg) — CC BY 2.0
- [Macintosh 128K - Macintosh mouse connector ii (3656524920).jpg](https://commons.wikimedia.org/wiki/File:Macintosh_128K_-_Macintosh_mouse_connector_ii_(3656524920).jpg) — CC BY 2.0
- [Macintosh 128K - Macintosh mouse underside (3656524628).jpg](https://commons.wikimedia.org/wiki/File:Macintosh_128K_-_Macintosh_mouse_underside_(3656524628).jpg) — CC BY 2.0
- [Macintosh 128K aperto.jpg](https://commons.wikimedia.org/wiki/File:Macintosh_128K_aperto.jpg) — CC BY-SA 2.5 it
- [Macintosh 128K connettori.jpg](https://commons.wikimedia.org/wiki/File:Macintosh_128K_connettori.jpg) — CC BY-SA 2.5 it
- [Macintosh 128K tastiera.jpg](https://commons.wikimedia.org/wiki/File:Macintosh_128K_tastiera.jpg) — CC BY-SA 2.5 it
- [Macintosh 128k transparency.png](https://commons.wikimedia.org/wiki/File:Macintosh_128k_transparency.png) — CC BY-SA 3.0

## Canon Cat

- [Canon Cat.jpg](https://commons.wikimedia.org/wiki/File:Canon_Cat.jpg) — CC BY-SA 3.0
- [Canon Cat front profile.jpg](https://commons.wikimedia.org/wiki/File:Canon_Cat_front_profile.jpg) — CC0
- [Canon Cat key switch.jpg](https://commons.wikimedia.org/wiki/File:Canon_Cat_key_switch.jpg) — Public domain
- [Canon Cat screen output.jpg](https://commons.wikimedia.org/wiki/File:Canon_Cat_screen_output.jpg) — Public domain
- [Jef Raskin holding Canon Cat model.png](https://commons.wikimedia.org/wiki/File:Jef_Raskin_holding_Canon_Cat_model.png) — CC BY 2.5
- [Jef Raskin holding a model of the Canon Cat computer.jpg](https://commons.wikimedia.org/wiki/File:Jef_Raskin_holding_a_model_of_the_Canon_Cat_computer.jpg) — CC BY-SA 2.5

## Sega SC-3000

- [Sega-SG-1000-Console-Set.jpg](https://commons.wikimedia.org/wiki/File:Sega-SG-1000-Console-Set.jpg) — Public domain
- [Sega-SG-1000-Console-Set.png](https://commons.wikimedia.org/wiki/File:Sega-SG-1000-Console-Set.png) — CC BY-SA 3.0
- [Sega SC-3000.jpg](https://commons.wikimedia.org/wiki/File:Sega_SC-3000.jpg) — CC BY-SA 2.0
- [Sega SC-3000 wb.jpg](https://commons.wikimedia.org/wiki/File:Sega_SC-3000_wb.jpg) — CC BY 3.0
- [Sega SC-3000 wb (shadow removed version).jpg](https://commons.wikimedia.org/wiki/File:Sega_SC-3000_wb_(shadow_removed_version).jpg) — CC BY 3.0

## Sharp MZ-80

- [Usage share of personal computers at home in Japan as of 1989.png](https://commons.wikimedia.org/wiki/File:Usage_share_of_personal_computers_at_home_in_Japan_as_of_1989.png) — CC0

## Amstrad CPC 464

- [Amstrad CPC464.jpg](https://commons.wikimedia.org/wiki/File:Amstrad_CPC464.jpg) — CC BY-SA 2.5
- [Amstrad CPC 464-IMG 4849.JPG](https://commons.wikimedia.org/wiki/File:Amstrad_CPC_464-IMG_4849.JPG) — CC BY-SA 2.0 fr
- [Amstrad CPC 464-IMG 4850.JPG](https://commons.wikimedia.org/wiki/File:Amstrad_CPC_464-IMG_4850.JPG) — CC BY-SA 2.0 fr
- [Amstrad CPC 464.jpg](https://commons.wikimedia.org/wiki/File:Amstrad_CPC_464.jpg) — CC BY-SA 2.0
- [Amstrad CPC 464 (1984) 1.jpg](https://commons.wikimedia.org/wiki/File:Amstrad_CPC_464_(1984)_1.jpg) — CC BY-SA 4.0
- [Amstrad CPC 464 (1984) 2.jpg](https://commons.wikimedia.org/wiki/File:Amstrad_CPC_464_(1984)_2.jpg) — CC BY-SA 4.0
- [Amstrad CPC 464 computer at Play Expo 2013.JPG](https://commons.wikimedia.org/wiki/File:Amstrad_CPC_464_computer_at_Play_Expo_2013.JPG) — CC BY-SA 3.0
- [An Amstrad CPC 464...in hardware.jpg](https://commons.wikimedia.org/wiki/File:An_Amstrad_CPC_464...in_hardware.jpg) — CC BY 2.0
- [CPC 464, Amstrad (I198504).jpg](https://commons.wikimedia.org/wiki/File:CPC_464,_Amstrad_(I198504).jpg) — Public domain

## Sony HB-F1

- [Swiss International Air Lines Boeing 777 (HB-JNH) taking off from NRT.jpg](https://commons.wikimedia.org/wiki/File:Swiss_International_Air_Lines_Boeing_777_(HB-JNH)_taking_off_from_NRT.jpg) — CC BY-SA 4.0

## Philips VG-8020

- [MSX Philips VG8020.jpg](https://commons.wikimedia.org/wiki/File:MSX_Philips_VG8020.jpg) — Public domain
- [Msx philips VG 8020, personal computer, 1983.jpg](https://commons.wikimedia.org/wiki/File:Msx_philips_VG_8020,_personal_computer,_1983.jpg) — CC BY 3.0
- [Philips-Yashika Home Computer VG 8020 (1984) 1.jpg](https://commons.wikimedia.org/wiki/File:Philips-Yashika_Home_Computer_VG_8020_(1984)_1.jpg) — CC BY-SA 4.0
- [Philips-Yashika Home Computer VG 8020 (1984) 2.jpg](https://commons.wikimedia.org/wiki/File:Philips-Yashika_Home_Computer_VG_8020_(1984)_2.jpg) — CC BY-SA 4.0
- [Philips VG 8020-20 MSX computer (RetroMadrid 2017).jpg](https://commons.wikimedia.org/wiki/File:Philips_VG_8020-20_MSX_computer_(RetroMadrid_2017).jpg) — CC BY-SA 2.0
- [Philips VG 8020 MSX computer (RetroMadrid 2017).jpg](https://commons.wikimedia.org/wiki/File:Philips_VG_8020_MSX_computer_(RetroMadrid_2017).jpg) — CC BY-SA 2.0

## Apple eMac

- [Apple eMac PowerPC G4 1.25 GHz 2005.jpg](https://commons.wikimedia.org/wiki/File:Apple_eMac_PowerPC_G4_1.25_GHz_2005.jpg) — CC BY-SA 2.0
- [Apple eMac PowerPC G4 1.25 GHz 2005 (4292746566).jpg](https://commons.wikimedia.org/wiki/File:Apple_eMac_PowerPC_G4_1.25_GHz_2005_(4292746566).jpg) — CC BY-SA 2.0
- [EMac at Apple SoHo 2002.jpg](https://commons.wikimedia.org/wiki/File:EMac_at_Apple_SoHo_2002.jpg) — CC BY 2.0

## iMac G3 colors

- [IMac G3 Flower Power and Blue Dalmatian.png](https://commons.wikimedia.org/wiki/File:IMac_G3_Flower_Power_and_Blue_Dalmatian.png) — CC BY-SA 3.0
- [IMac G3 Tangerine.png](https://commons.wikimedia.org/wiki/File:IMac_G3_Tangerine.png) — CC BY 2.0
- [IMac G3 color carousel.gif](https://commons.wikimedia.org/wiki/File:IMac_G3_color_carousel.gif) — CC BY-SA 4.0
- [Tangerine iBook and iMac.jpg](https://commons.wikimedia.org/wiki/File:Tangerine_iBook_and_iMac.jpg) — CC BY 2.0

## Mattel Aquarius

- [Mattel-Aquarius-Computer-BL.jpg](https://commons.wikimedia.org/wiki/File:Mattel-Aquarius-Computer-BL.jpg) — Public domain
- [Mattel-Aquarius-Computer-BR.jpg](https://commons.wikimedia.org/wiki/File:Mattel-Aquarius-Computer-BR.jpg) — Public domain
- [Mattel-Aquarius-Computer-FL.jpg](https://commons.wikimedia.org/wiki/File:Mattel-Aquarius-Computer-FL.jpg) — Public domain
- [Mattel-Aquarius-Computer-FL.png](https://commons.wikimedia.org/wiki/File:Mattel-Aquarius-Computer-FL.png) — CC0
- [Mattel-Aquarius-Computer-FR.jpg](https://commons.wikimedia.org/wiki/File:Mattel-Aquarius-Computer-FR.jpg) — Public domain
- [Mattel Aquarius Home Computer System (1983) 1.jpg](https://commons.wikimedia.org/wiki/File:Mattel_Aquarius_Home_Computer_System_(1983)_1.jpg) — CC BY-SA 4.0
- [Mattel Aquarius Home Computer System (1983) 2.jpg](https://commons.wikimedia.org/wiki/File:Mattel_Aquarius_Home_Computer_System_(1983)_2.jpg) — CC BY-SA 4.0

## pastel computer

- [Computer time (13878941924).jpg](https://commons.wikimedia.org/wiki/File:Computer_time_(13878941924).jpg) — No restrictions

## Sord M5

- [CGL Home Computer (2189565733).jpg](https://commons.wikimedia.org/wiki/File:CGL_Home_Computer_(2189565733).jpg) — CC BY 2.0
- [CGL M5 computer by Sord (overhead view).jpg](https://commons.wikimedia.org/wiki/File:CGL_M5_computer_by_Sord_(overhead_view).jpg) — CC BY-SA 2.0
- [Sord M5 Computer and accessories.jpg](https://commons.wikimedia.org/wiki/File:Sord_M5_Computer_and_accessories.jpg) — CC BY 4.0
