cyborgroid/Retro_Analog_Pastel_Computer/cad/out/build/fab/kb_plate.dxf

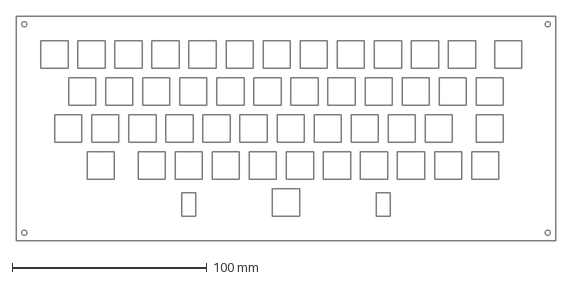
[picture p1: CAD file, 2026-10-26]
cad/out/build/fab/kb_plate.dxf
277.2 x 115.2 mm
