cyborgroid/Retro_Analog_Pastel_Computer/cad/out/build/pastella84.step

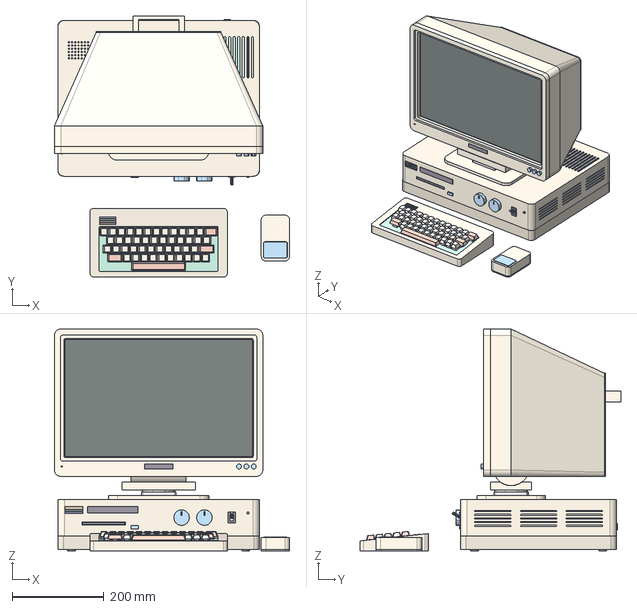
[picture p2: CAD file, 2026-10-26]
cad/out/build/pastella84.step
513.6 x 570.0 x 484.8 mm
