cyborgroid/Retro_Analog_Pastel_Computer/cad/out/build/urdf/meshes/mouse_base__mouse.stl

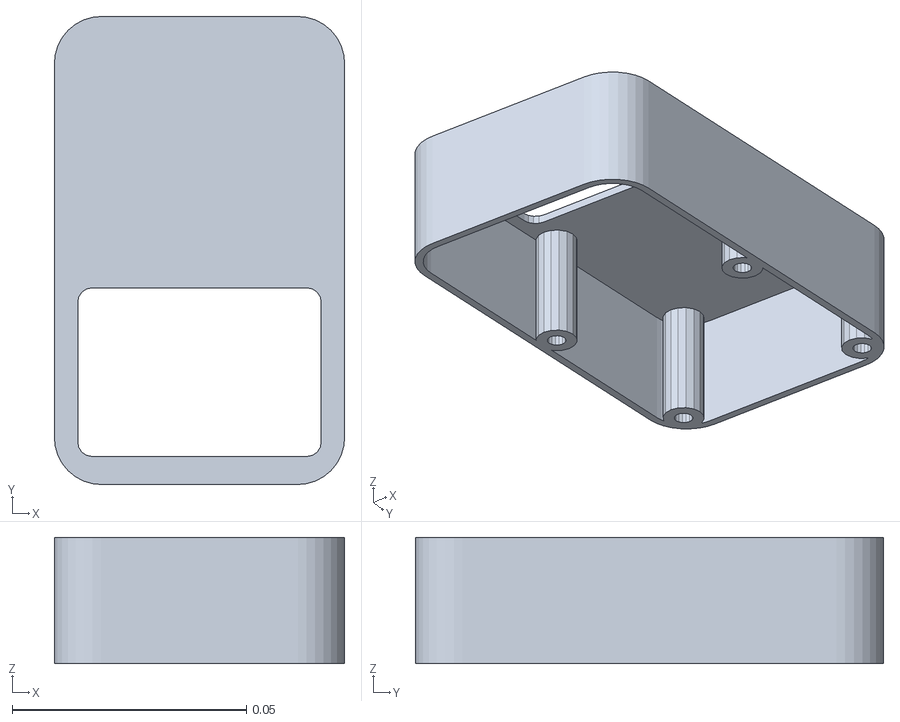
[picture p4: CAD file, 2026-10-26]
cad/out/build/urdf/meshes/mouse_base__mouse.stl
0.062 x 0.1 x 0.027
