cyborgroid/Retro_Analog_Pastel_Computer/cad/out/pastella84.step

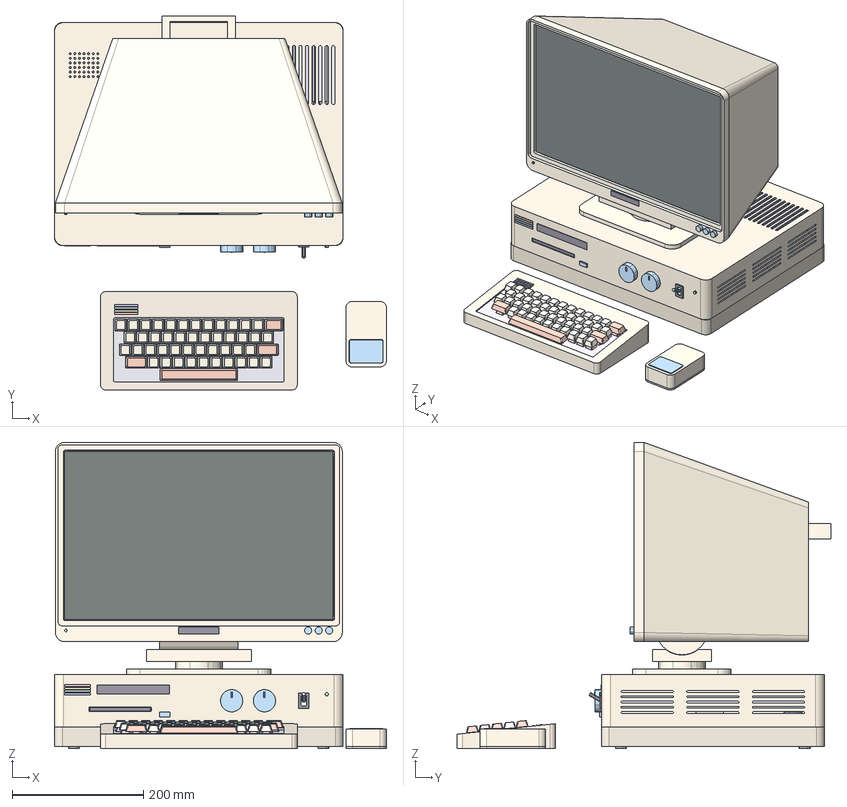
[picture p5: CAD file, 2026-10-26]
cad/out/pastella84.step
506.0 x 570.0 x 466.8 mm
