cyborgroid/Retro_Analog_Pastel_Computer/cad/out/urdf/meshes/keyboard_case__steel.stl

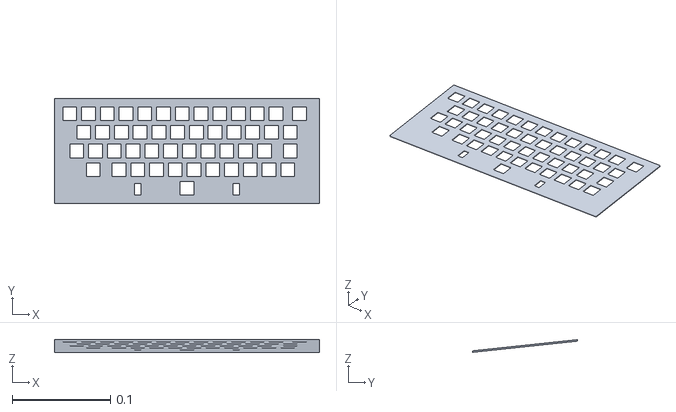
[picture p6: CAD file, 2026-10-26]
cad/out/urdf/meshes/keyboard_case__steel.stl
0.269 x 0.107 x 0.0129
