cyborgroid/Retro_Analog_Pastel_Computer/cad/out/build/urdf/meshes/monitor_swivel__monitor.stl

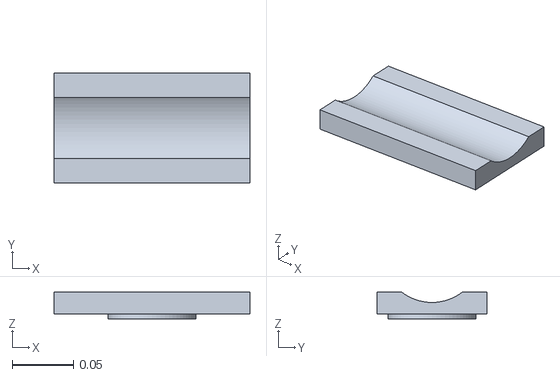
[picture p7: CAD file, 2026-10-26]
cad/out/build/urdf/meshes/monitor_swivel__monitor.stl
0.16 x 0.09 x 0.022
