cyborgroid/Retro_Analog_Pastel_Computer/cad/out/urdf/meshes/monitor_body__copper.stl

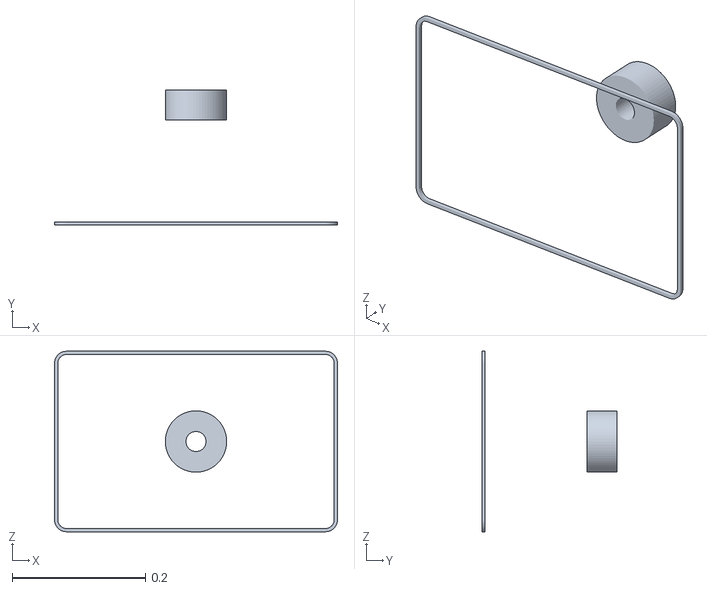
[picture p8: CAD file, 2026-10-26]
cad/out/urdf/meshes/monitor_body__copper.stl
0.424 x 0.203 x 0.271
