cyborgroid/Retro_Analog_Pastel_Computer/cad/out/build/print/trim__brand_badge_monitor.stl

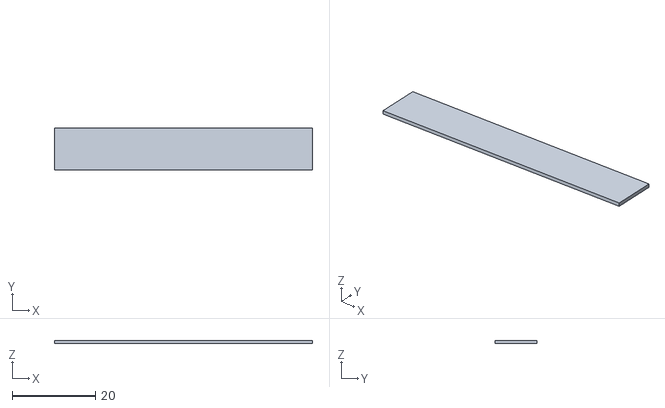
[picture p9: CAD file, 2026-10-26]
cad/out/build/print/trim__brand_badge_monitor.stl
62.0 x 10.0 x 0.8
