cyborgroid/Retro_Analog_Pastel_Computer/cad/out/build/urdf/meshes/monitor_body__monitor.stl

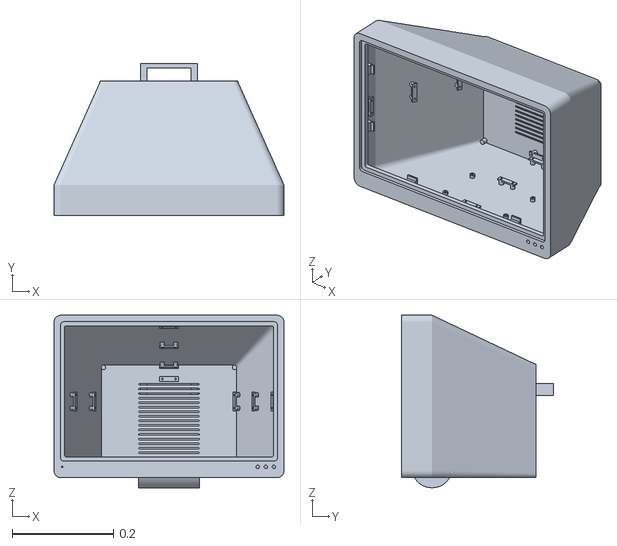
[picture p10: CAD file, 2026-10-26]
cad/out/build/urdf/meshes/monitor_body__monitor.stl
0.455 x 0.3 x 0.342
