cyborgroid/Retro_Analog_Pastel_Computer/cad/out/urdf/meshes/monitor_body__glass.stl

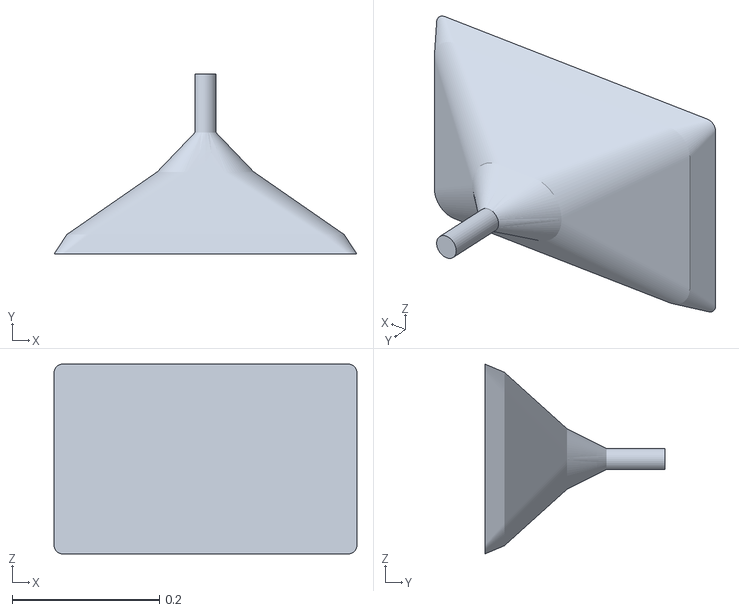
[picture p11: CAD file, 2026-10-26]
cad/out/urdf/meshes/monitor_body__glass.stl
0.411 x 0.245 x 0.258
