cyborgroid/Retro_Analog_Pastel_Computer/cad/out/build/print/trim__kb_stripe_2.stl

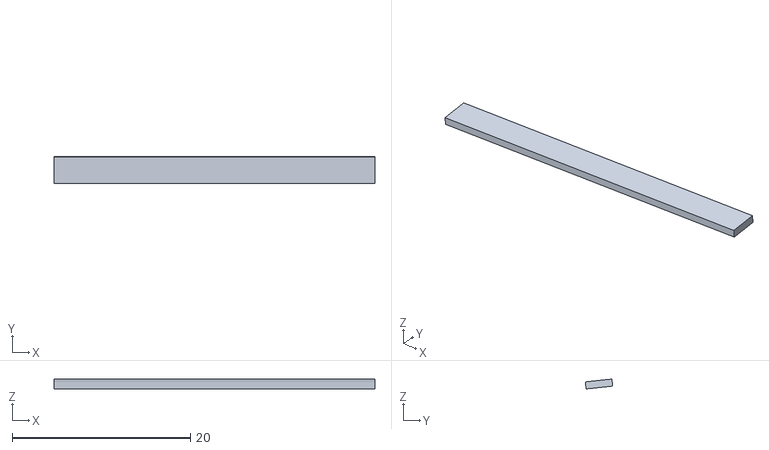
[picture p12: CAD file, 2026-10-26]
cad/out/build/print/trim__kb_stripe_2.stl
36.0 x 3.07 x 1.11
