cyborgroid/Retro_Analog_Pastel_Computer/cad/out/build/urdf/meshes/monitor_stand__monitor.stl

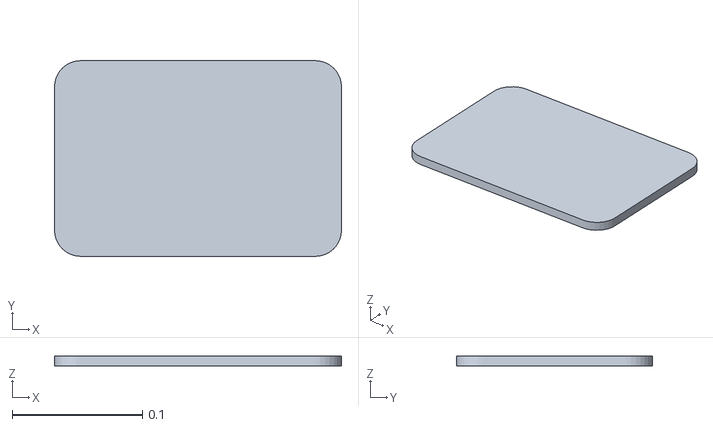
[picture p13: CAD file, 2026-10-26]
cad/out/build/urdf/meshes/monitor_stand__monitor.stl
0.22 x 0.15 x 0.008
