cyborgroid/Retro_Analog_Pastel_Computer/cad/out/urdf/meshes/base_internal__trim.stl

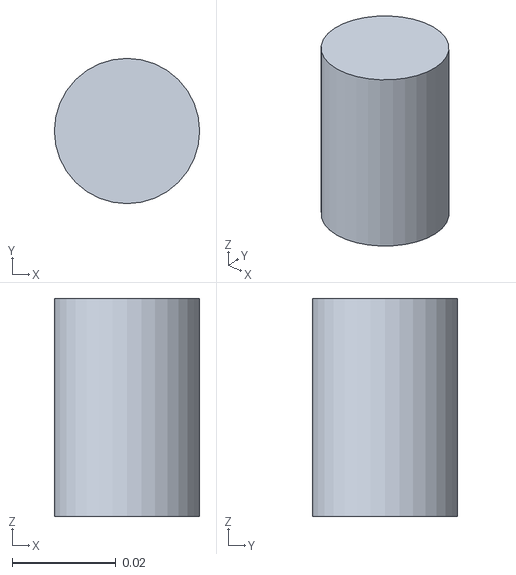
[picture p14: CAD file, 2026-10-26]
cad/out/urdf/meshes/base_internal__trim.stl
0.028 x 0.028 x 0.042
