cyborgroid/Retro_Analog_Pastel_Computer/cad/out/build/print/splices__seam_tray_1_0_plate.stl

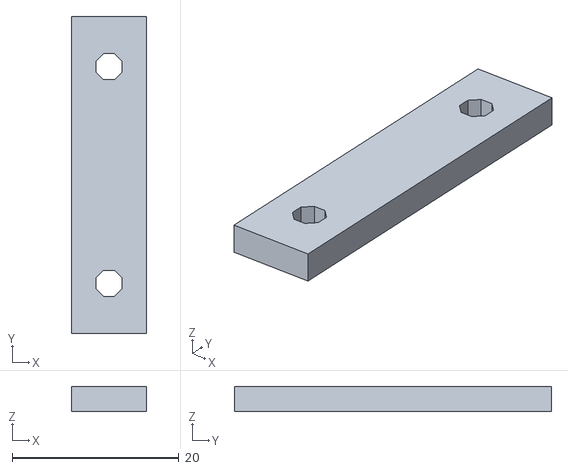
[picture p15: CAD file, 2026-10-26]
cad/out/build/print/splices__seam_tray_1_0_plate.stl
9.00 x 38.0 x 3.00
