cyborgroid/Retro_Analog_Pastel_Computer/cad/out/build/urdf/meshes/base_internal__chip.stl

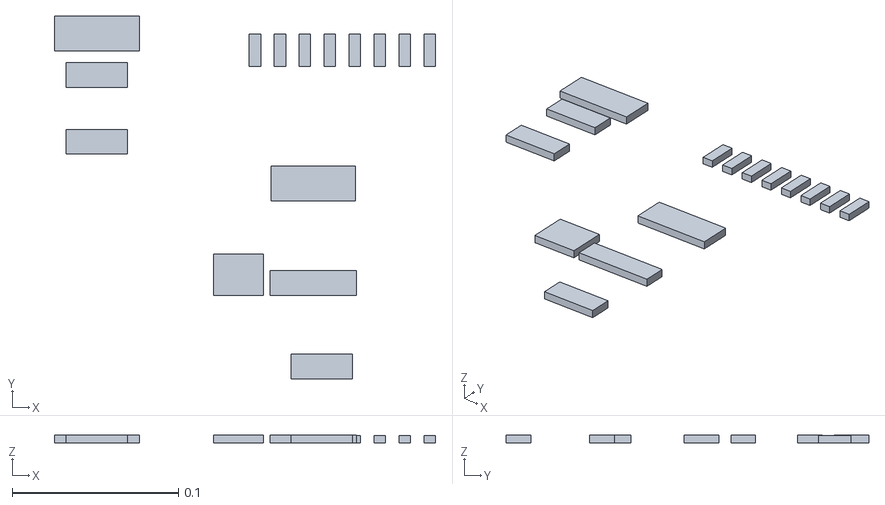
[picture p16: CAD file, 2026-10-26]
cad/out/build/urdf/meshes/base_internal__chip.stl
0.229 x 0.218 x 0.005
