cyborgroid/Retro_Analog_Pastel_Computer/cad/out/urdf/meshes/monitor_body__slot.stl

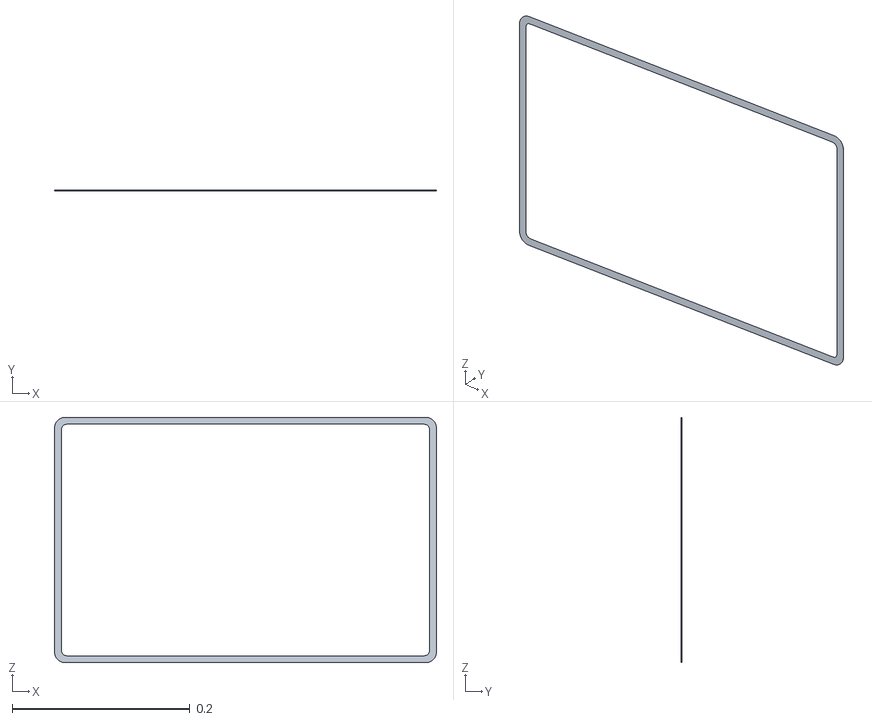
[picture p17: CAD file, 2026-10-26]
cad/out/urdf/meshes/monitor_body__slot.stl
0.429 x 0.001 x 0.276
