cyborgroid/Retro_Analog_Pastel_Computer/cad/out/build/print/bezel_a1.stl

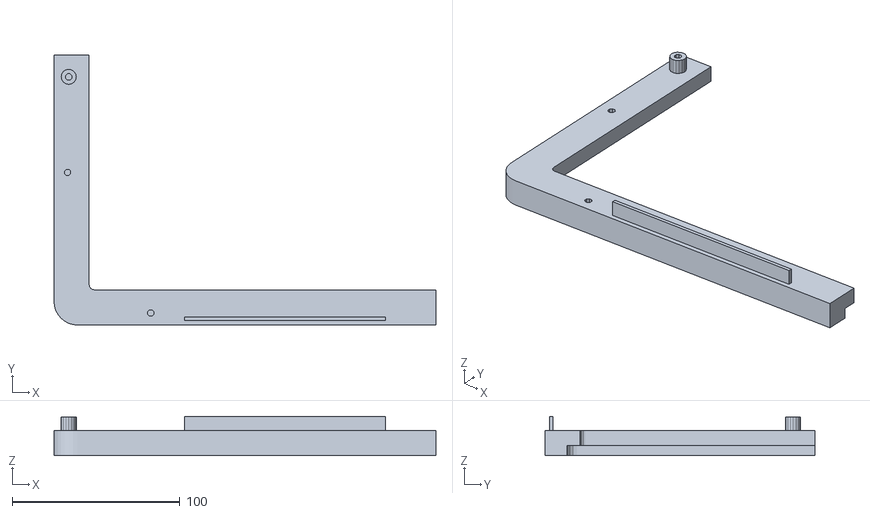
[picture p18: CAD file, 2026-10-26]
cad/out/build/print/bezel_a1.stl
227.6 x 160.9 x 23.5
