cyborgroid/Retro_Analog_Pastel_Computer/cad/out/build/urdf/meshes/keyboard_case__pcb.stl

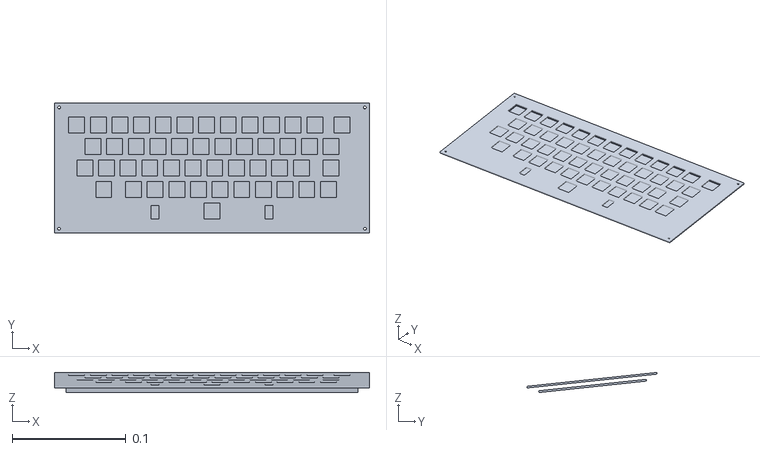
[picture p19: CAD file, 2026-10-26]
cad/out/build/urdf/meshes/keyboard_case__pcb.stl
0.277 x 0.115 x 0.0177
