cyborgroid/Retro_Analog_Pastel_Computer/cad/out/urdf/meshes/mouse_roller_x__alu.stl

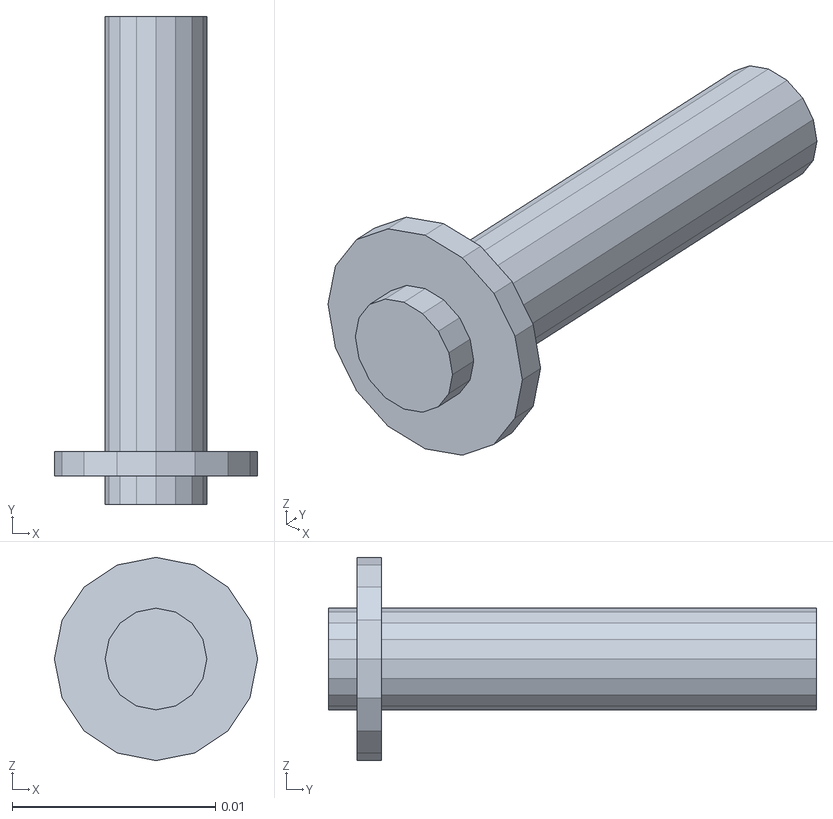
[picture p20: CAD file, 2026-10-26]
cad/out/urdf/meshes/mouse_roller_x__alu.stl
0.01 x 0.024 x 0.01
