cyborgroid/Retro_Analog_Pastel_Computer/cad/out/build/urdf/meshes/monitor_body__screen.stl

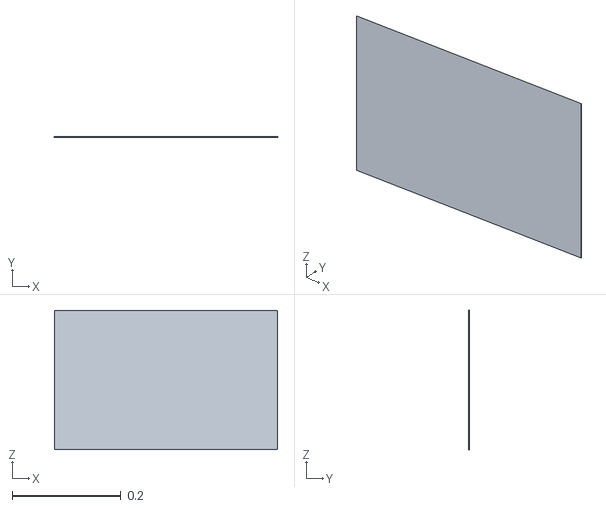
[picture p21: CAD file, 2026-10-26]
cad/out/build/urdf/meshes/monitor_body__screen.stl
0.409 x 0.0005 x 0.256
