cyborgroid/Retro_Analog_Pastel_Computer/cad/out/build/print/clips__panel_clip_top_l.stl

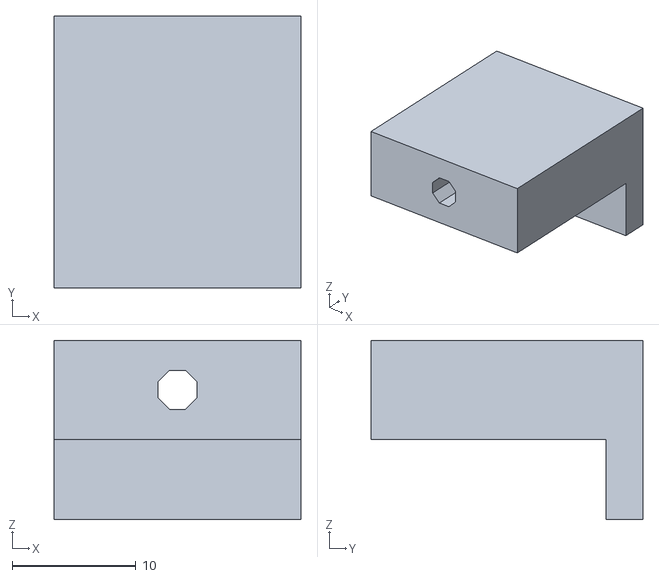
[picture p22: CAD file, 2026-10-26]
cad/out/build/print/clips__panel_clip_top_l.stl
20.0 x 22.0 x 14.5
