cyborgroid/Retro_Analog_Pastel_Computer/cad/out/build/urdf/meshes/monitor_body__led.stl

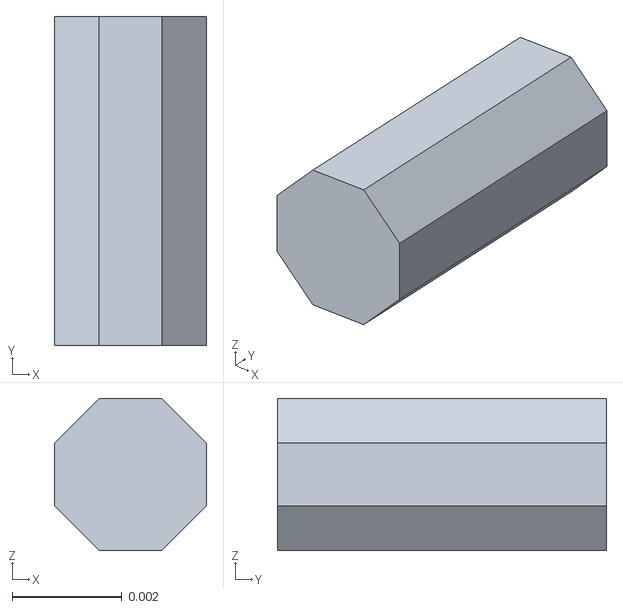
[picture p23: CAD file, 2026-10-26]
cad/out/build/urdf/meshes/monitor_body__led.stl
0.00277 x 0.006 x 0.00277
