cyborgroid/Retro_Analog_Pastel_Computer/cad/out/urdf/meshes/mouse_ball__rubber.stl

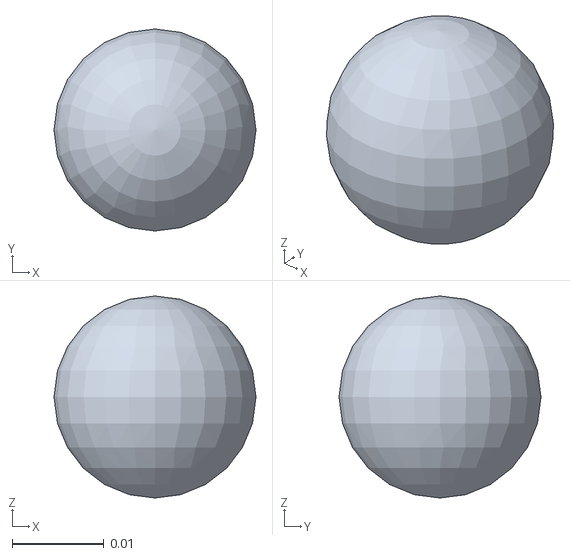
[picture p24: CAD file, 2026-10-26]
cad/out/urdf/meshes/mouse_ball__rubber.stl
0.022 x 0.022 x 0.022
