cyborgroid/Retro_Analog_Pastel_Computer/cad/out/build/print/shell_b1.stl

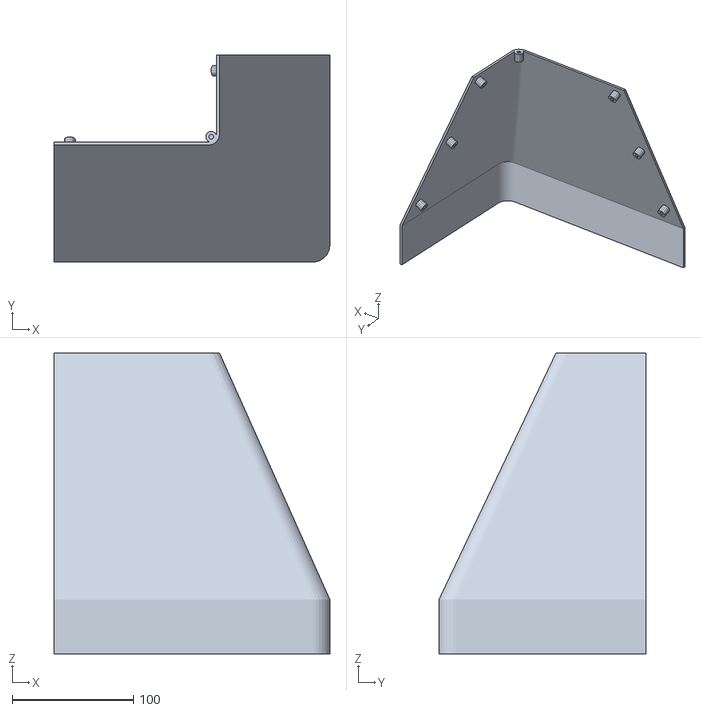
[picture p25: CAD file, 2026-10-26]
cad/out/build/print/shell_b1.stl
227.6 x 170.9 x 248.5
