cyborgroid/Retro_Analog_Pastel_Computer/cad/out/build/urdf/meshes/mouse_base__chip.stl

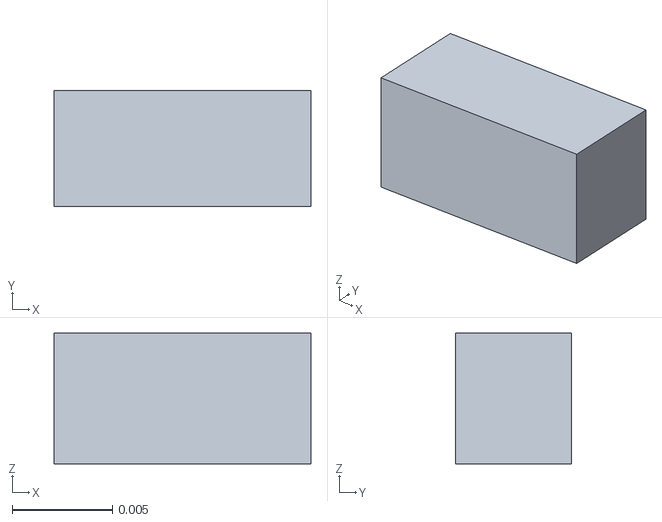
[picture p26: CAD file, 2026-10-26]
cad/out/build/urdf/meshes/mouse_base__chip.stl
0.0128 x 0.0058 x 0.0065
