cyborgroid/Retro_Analog_Pastel_Computer/cad/out/build/print/stand_neck__stand_neck.stl

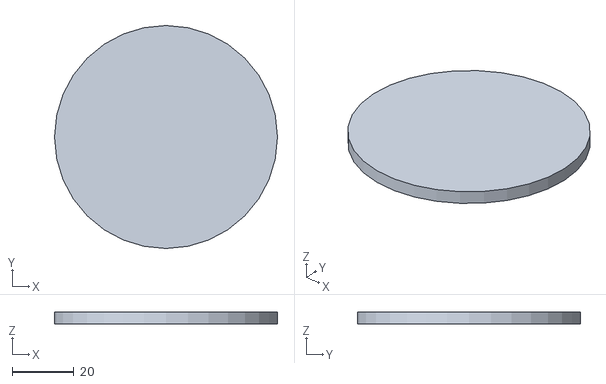
[picture p27: CAD file, 2026-10-26]
cad/out/build/print/stand_neck__stand_neck.stl
72.0 x 72.0 x 4.00
