cyborgroid/Retro_Analog_Pastel_Computer/cad/out/build/urdf/meshes/monitor_body__dark.stl

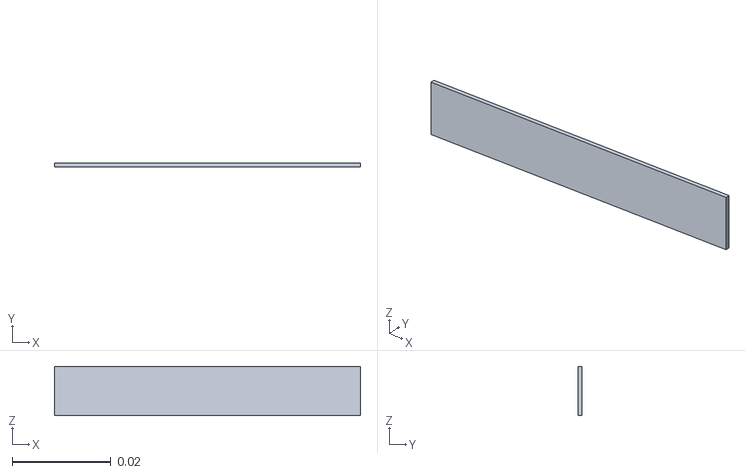
[picture p28: CAD file, 2026-10-26]
cad/out/build/urdf/meshes/monitor_body__dark.stl
0.062 x 0.0008 x 0.01
