cyborgroid/Retro_Analog_Pastel_Computer/cad/out/build/urdf/meshes/keyboard_case__keyboard.stl

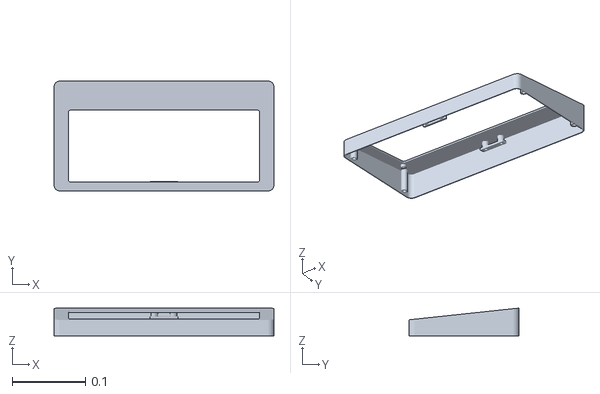
[picture p29: CAD file, 2026-10-26]
cad/out/build/urdf/meshes/keyboard_case__keyboard.stl
0.3 x 0.15 x 0.038
