cyborgroid/Retro_Analog_Pastel_Computer/cad/out/build/print/clips__panel_clip_left_down.stl

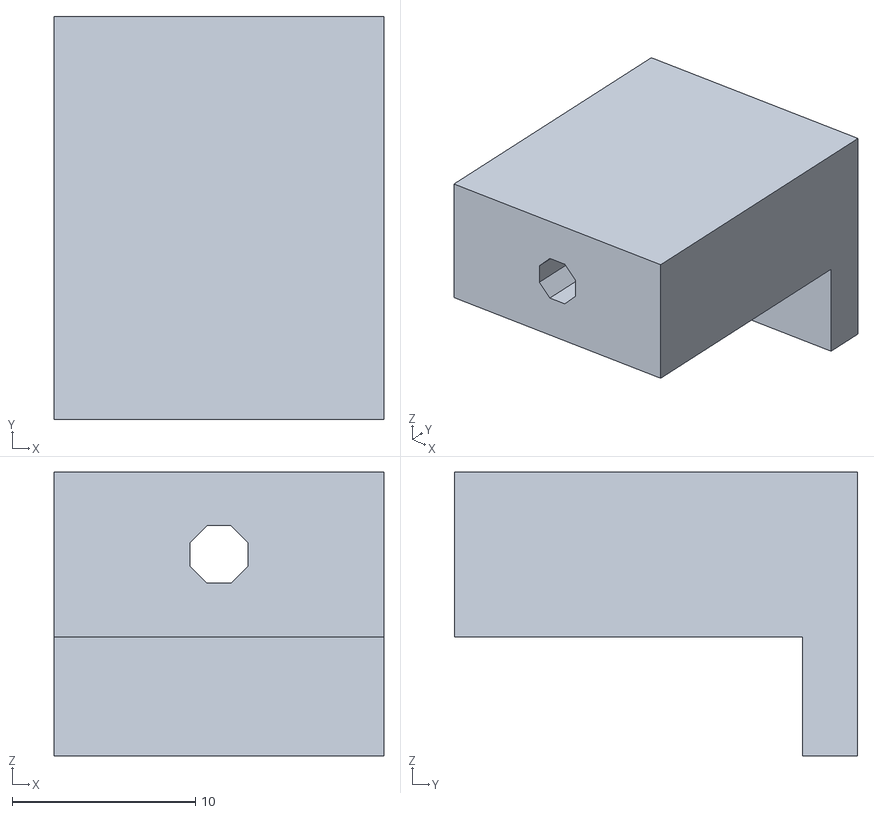
[picture p30: CAD file, 2026-10-26]
cad/out/build/print/clips__panel_clip_left_down.stl
18.0 x 22.0 x 15.5
