cyborgroid/Retro_Analog_Pastel_Computer/cad/out/build/urdf/meshes/knob_vhold__trim.stl

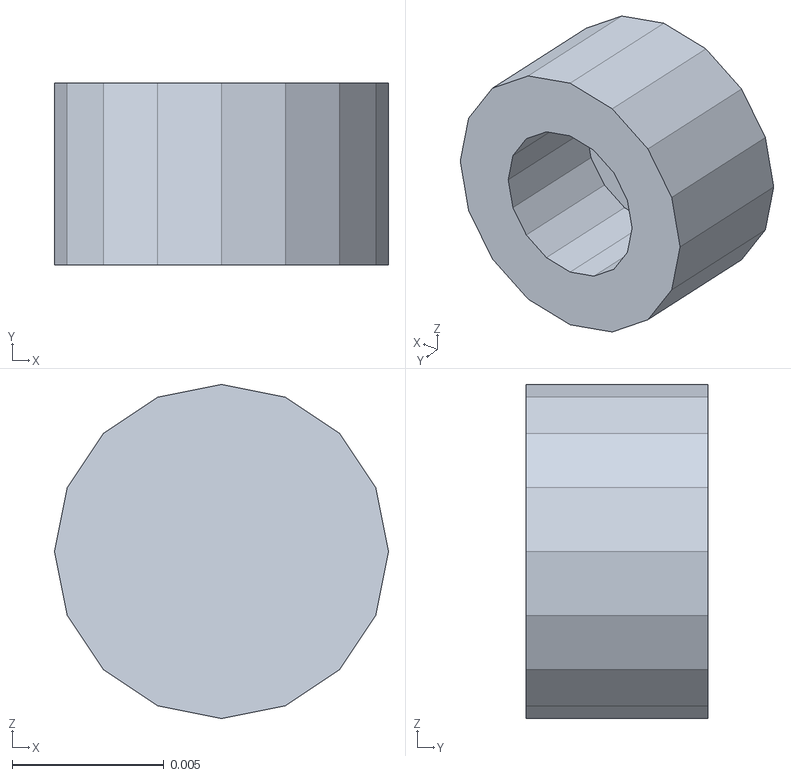
[picture p31: CAD file, 2026-10-26]
cad/out/build/urdf/meshes/knob_vhold__trim.stl
0.011 x 0.006 x 0.011
