cyborgroid/Retro_Analog_Pastel_Computer/cad/out/build/print/splices__seam_shell_0_4_plate.stl

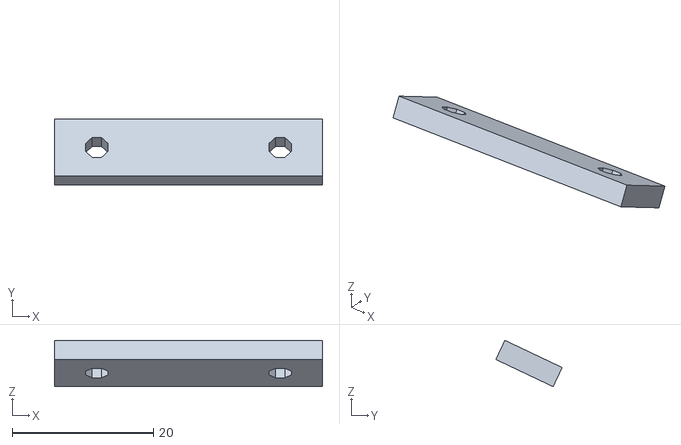
[picture p32: CAD file, 2026-10-26]
cad/out/build/print/splices__seam_shell_0_4_plate.stl
38.0 x 9.42 x 6.57
