cyborgroid/Retro_Analog_Pastel_Computer/cad/out/build/urdf/meshes/base_lid__alu.stl

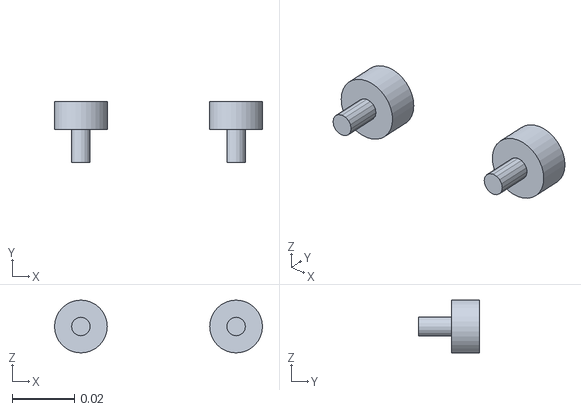
[picture p33: CAD file, 2026-10-26]
cad/out/build/urdf/meshes/base_lid__alu.stl
0.067 x 0.0195 x 0.017
