cyborgroid/Retro_Analog_Pastel_Computer/cad/out/build/print/trim__eject_button.stl

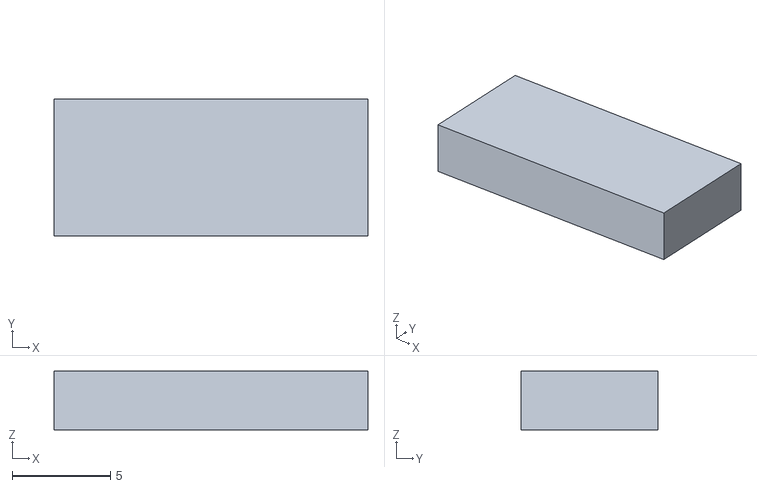
[picture p34: CAD file, 2026-10-26]
cad/out/build/print/trim__eject_button.stl
16.0 x 7.00 x 3.00
