cyborgroid/Retro_Analog_Pastel_Computer/cad/out/build/urdf/meshes/monitor_body__chip.stl

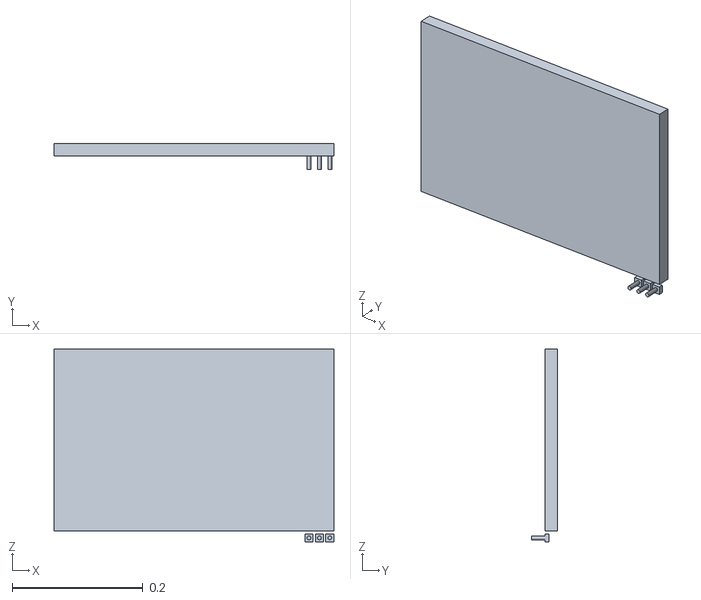
[picture p35: CAD file, 2026-10-26]
cad/out/build/urdf/meshes/monitor_body__chip.stl
0.428 x 0.039 x 0.294
