cyborgroid/Retro_Analog_Pastel_Computer/cad/out/build/urdf/meshes/monitor_stand__steel.stl

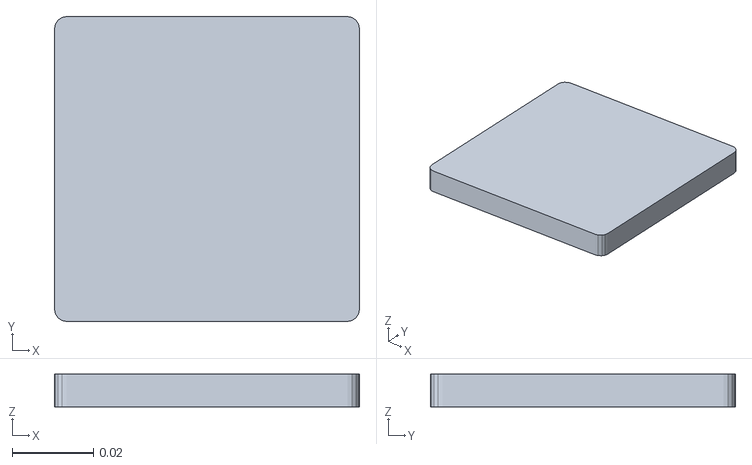
[picture p36: CAD file, 2026-10-26]
cad/out/build/urdf/meshes/monitor_stand__steel.stl
0.075 x 0.075 x 0.008
