cyborgroid/Retro_Analog_Pastel_Computer/cad/out/build/urdf/meshes/keyboard_case__tray.stl

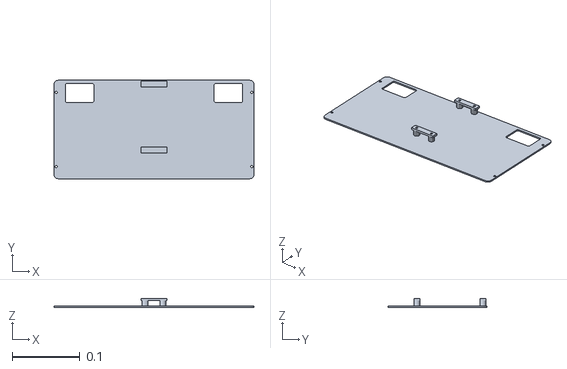
[picture p37: CAD file, 2026-10-26]
cad/out/build/urdf/meshes/keyboard_case__tray.stl
0.296 x 0.146 x 0.013
