cyborgroid/Retro_Analog_Pastel_Computer/cad/out/build/urdf/meshes/base_internal__pcb.stl

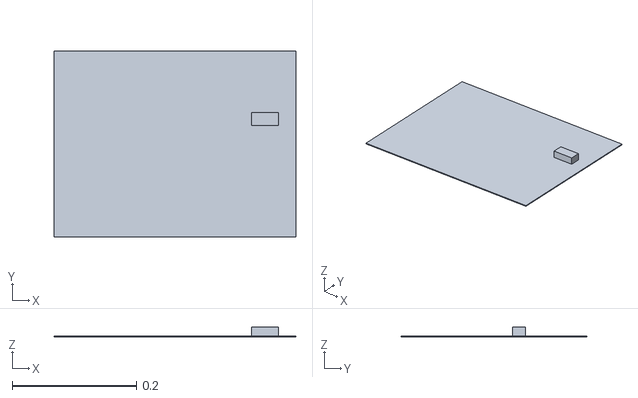
[picture p38: CAD file, 2026-10-26]
cad/out/build/urdf/meshes/base_internal__pcb.stl
0.39 x 0.3 x 0.0156
