cyborgroid/Retro_Analog_Pastel_Computer/cad/out/build/urdf/meshes/base_tray__tray.stl

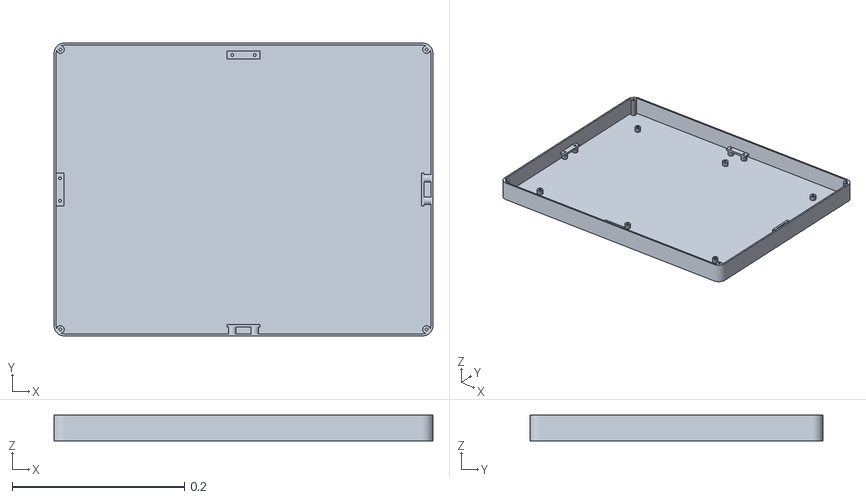
[picture p39: CAD file, 2026-10-26]
cad/out/build/urdf/meshes/base_tray__tray.stl
0.44 x 0.34 x 0.03
