cyborgroid/Retro_Analog_Pastel_Computer/cad/out/build/urdf/meshes/base_internal__alu.stl

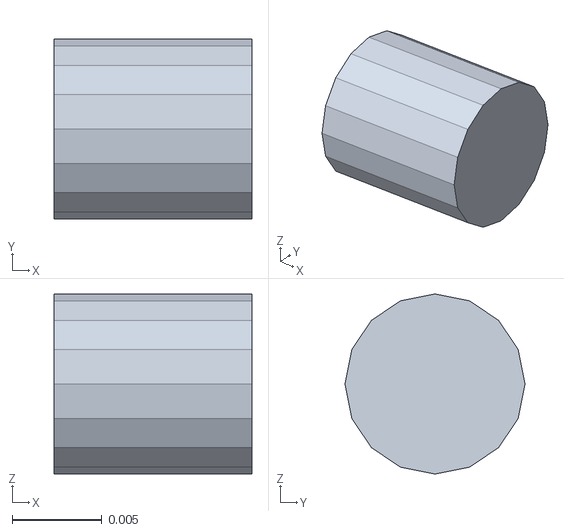
[picture p41: CAD file, 2026-10-26]
cad/out/build/urdf/meshes/base_internal__alu.stl
0.011 x 0.01 x 0.01
