cyborgroid/Retro_Analog_Pastel_Computer/cad/out/build/print/kbbottom_a1.stl

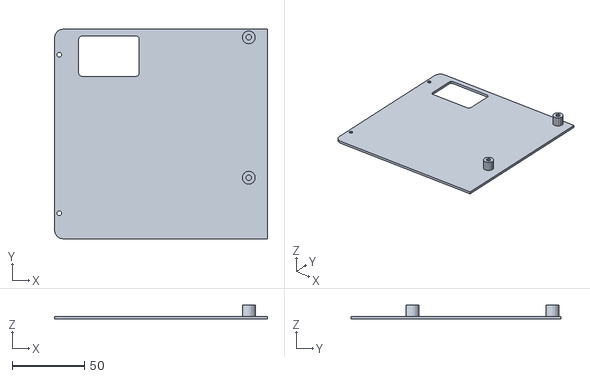
[picture p43: CAD file, 2026-10-26]
cad/out/build/print/kbbottom_a1.stl
147.8 x 145.6 x 10.0
