cyborgroid/Retro_Analog_Pastel_Computer/cad/out/build/urdf/meshes/mouse_base__pcb.stl

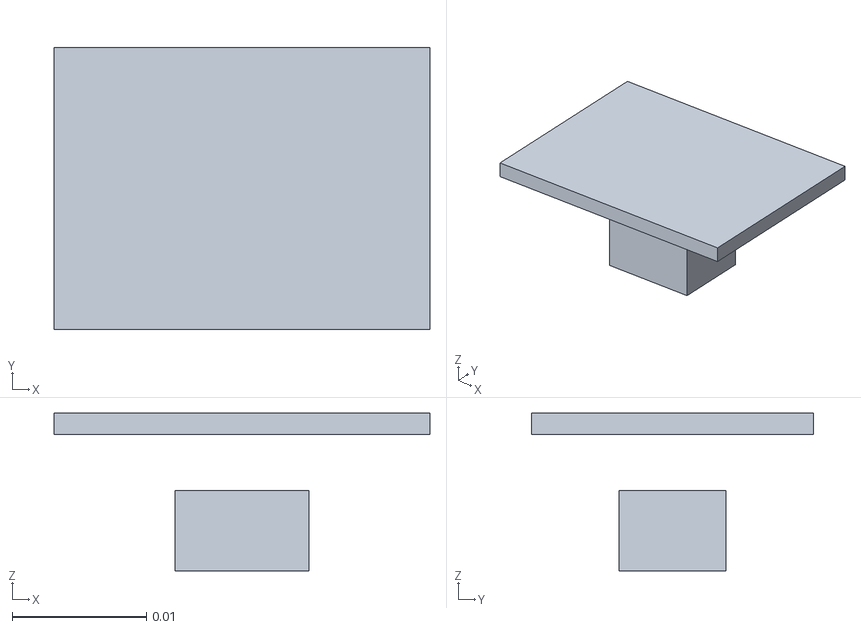
[picture p44: CAD file, 2026-10-26]
cad/out/build/urdf/meshes/mouse_base__pcb.stl
0.028 x 0.021 x 0.0117
