cyborgroid/Retro_Analog_Pastel_Computer/cad/out/build/urdf/meshes/base_internal__dark.stl

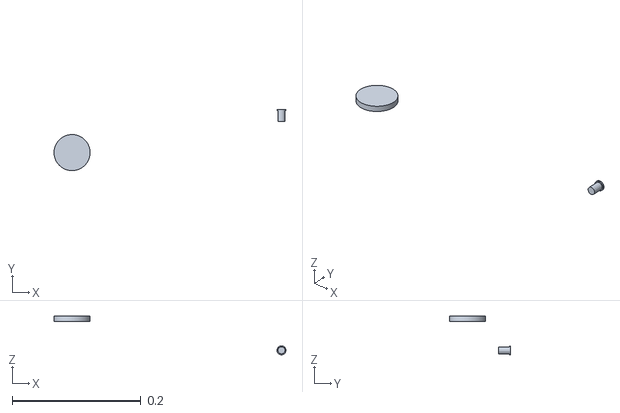
[picture p46: CAD file, 2026-10-26]
cad/out/build/urdf/meshes/base_internal__dark.stl
0.36 x 0.095 x 0.06
