cyborgroid/Retro_Analog_Pastel_Computer/cad/out/build/print/lid_a1.stl

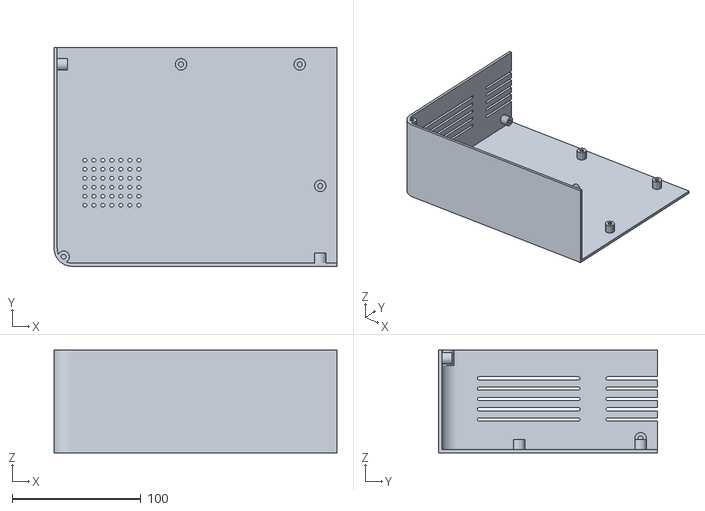
[picture p47: CAD file, 2026-10-26]
cad/out/build/print/lid_a1.stl
220.0 x 170.0 x 80.0
