cyborgroid/Retro_Analog_Pastel_Computer/cad/out/build/urdf/meshes/base_internal__steel.stl

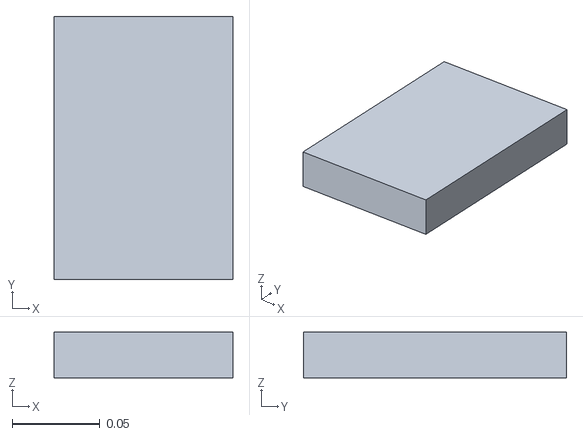
[picture p48: CAD file, 2026-10-26]
cad/out/build/urdf/meshes/base_internal__steel.stl
0.102 x 0.15 x 0.026
