cyborgroid/Retro_Analog_Pastel_Computer/cad/out/build/print/stand_swivel.stl

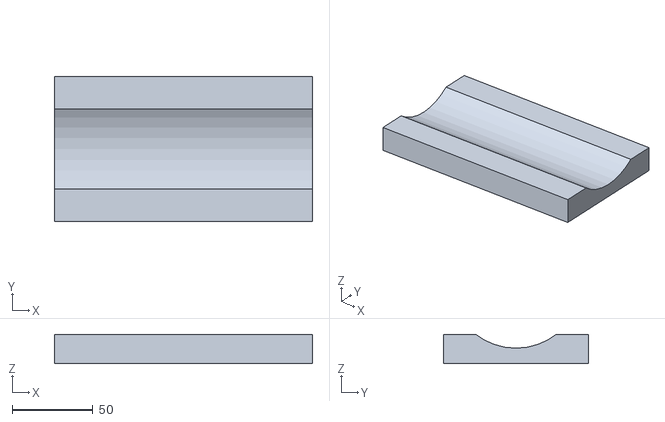
[picture p49: CAD file, 2026-10-26]
cad/out/build/print/stand_swivel.stl
160.0 x 90.0 x 18.0
