cyborgroid/Retro_Analog_Pastel_Computer/cad/out/build/urdf/meshes/dial_vol__trim.stl

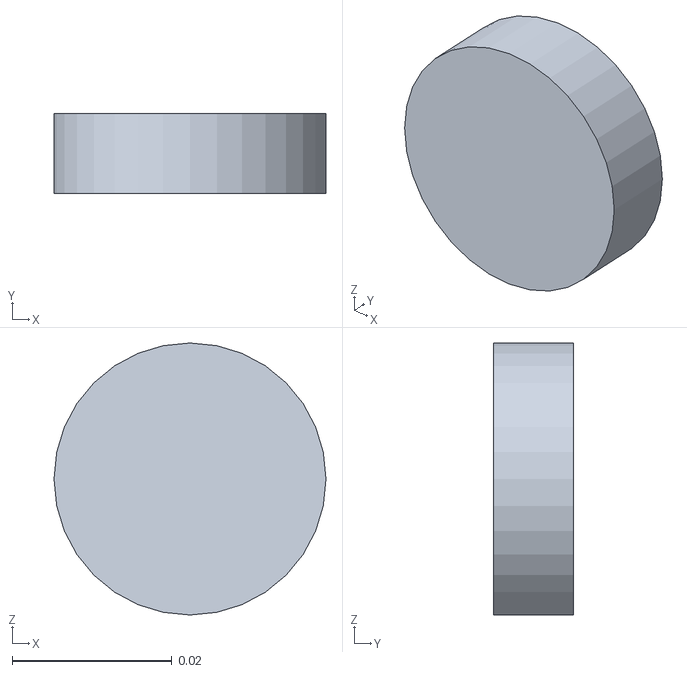
[picture p50: CAD file, 2026-10-26]
cad/out/build/urdf/meshes/dial_vol__trim.stl
0.034 x 0.01 x 0.034
