cyborgroid/Retro_Analog_Pastel_Computer/cad/out/build/urdf/meshes/monitor_body__pcb.stl

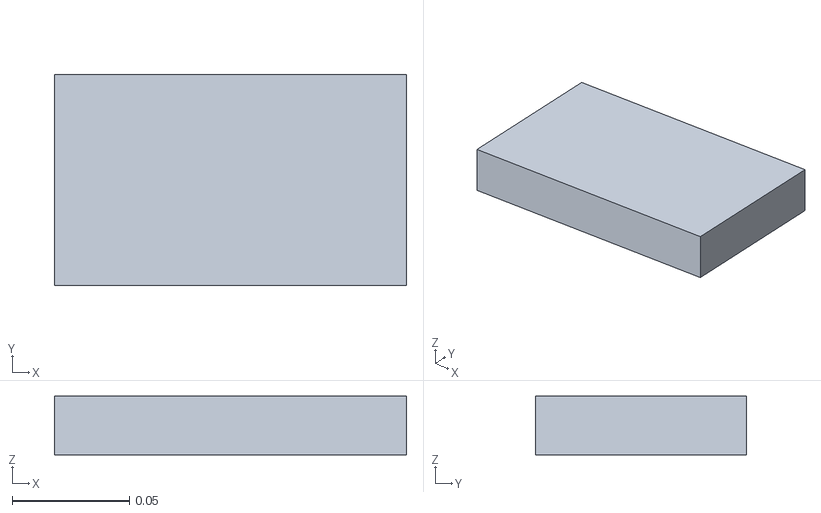
[picture p51: CAD file, 2026-10-26]
cad/out/build/urdf/meshes/monitor_body__pcb.stl
0.15 x 0.09 x 0.025
