cyborgroid/Retro_Analog_Pastel_Computer/cad/out/build/print/kbfeet__kb_foot_l.stl

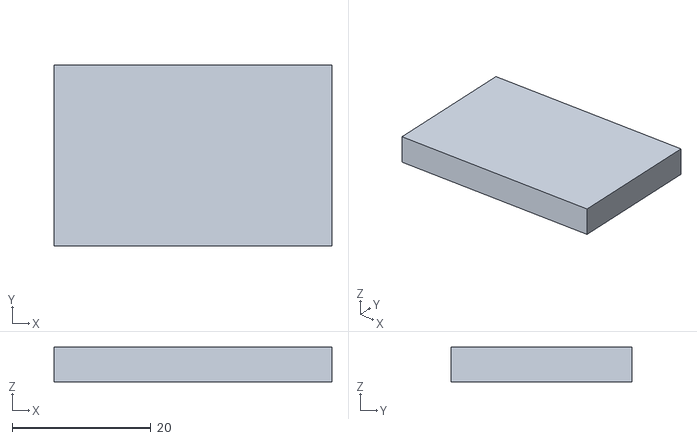
[picture p52: CAD file, 2026-10-26]
cad/out/build/print/kbfeet__kb_foot_l.stl
40.0 x 26.0 x 5.00
