cyborgroid/Retro_Analog_Pastel_Computer/cad/out/build/print/bezel_b2.stl

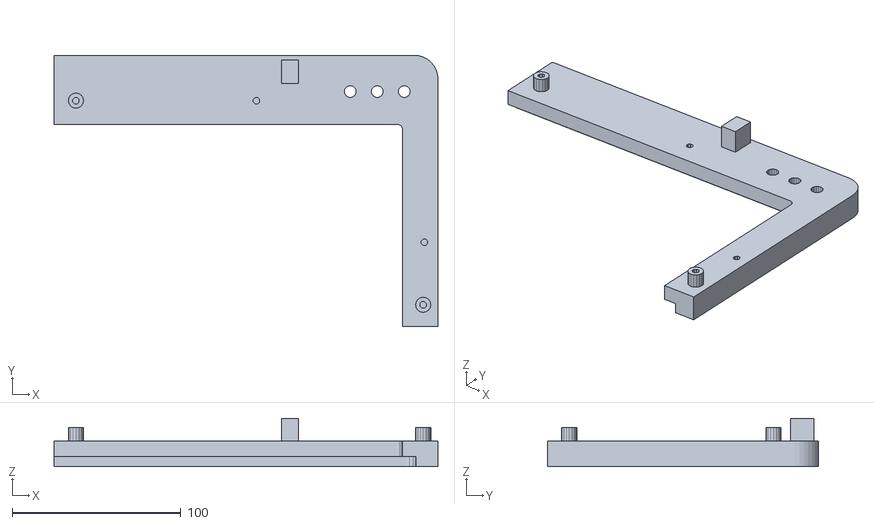
[picture p53: CAD file, 2026-10-26]
cad/out/build/print/bezel_b2.stl
227.6 x 160.9 x 28.5
