cyborgroid/Retro_Analog_Pastel_Computer/cad/out/build/urdf/meshes/key_k__switch.stl

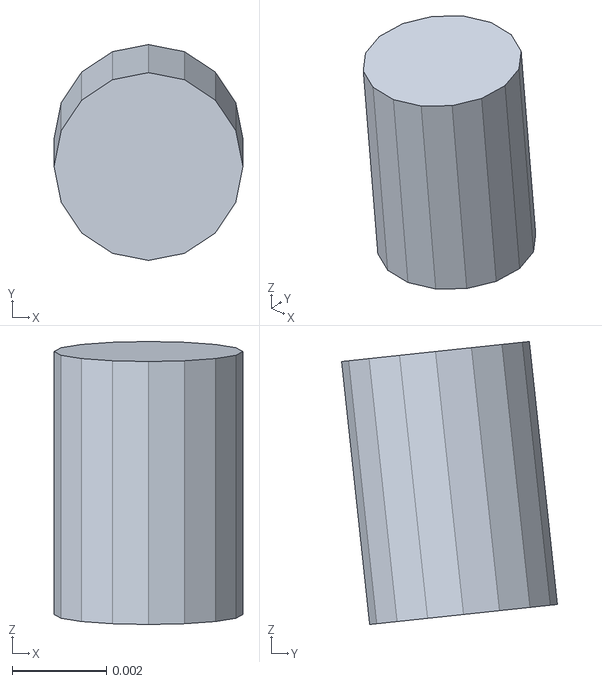
[picture p54: CAD file, 2026-10-26]
cad/out/build/urdf/meshes/key_k__switch.stl
0.004 x 0.00457 x 0.00599
