cyborgroid/Retro_Analog_Pastel_Computer/cad/out/build/print/splices__seam_kbcase_0_0_plate.stl

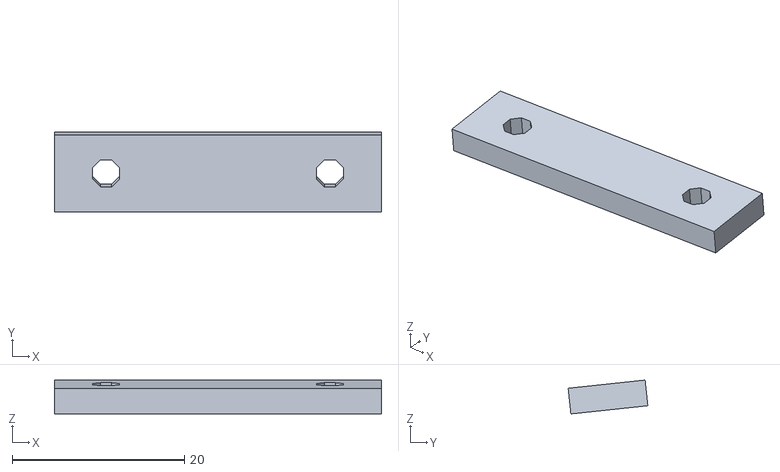
[picture p55: CAD file, 2026-10-26]
cad/out/build/print/splices__seam_kbcase_0_0_plate.stl
38.0 x 9.27 x 3.94
