cyborgroid/Retro_Analog_Pastel_Computer/cad/out/build/urdf/meshes/key_enter__keyB.stl

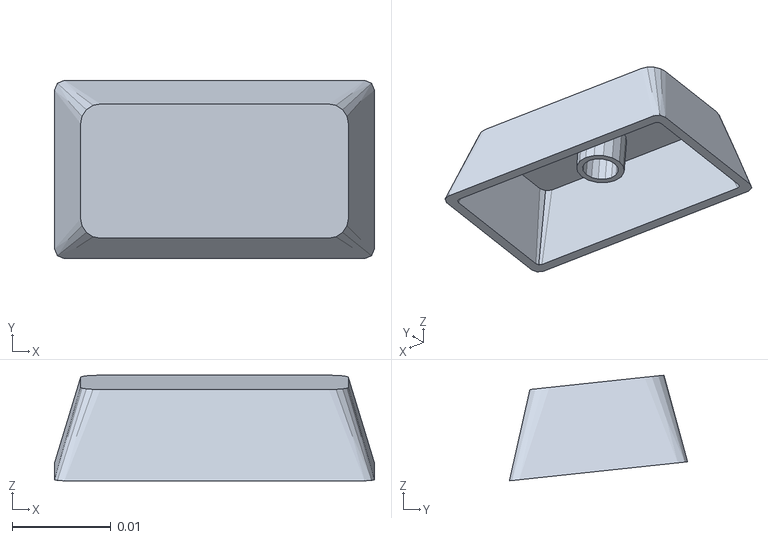
[picture p56: CAD file, 2026-10-26]
cad/out/build/urdf/meshes/key_enter__keyB.stl
0.0325 x 0.0181 x 0.0107
