cyborgroid/Retro_Analog_Pastel_Computer/cad/out/build/urdf/meshes/key_p__keyA.stl

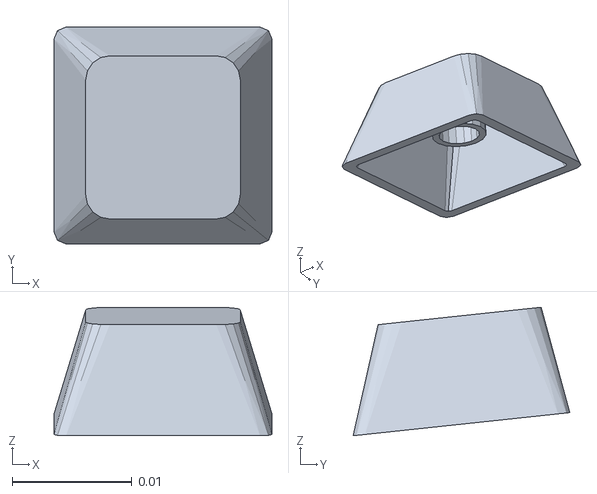
[picture p57: CAD file, 2026-10-26]
cad/out/build/urdf/meshes/key_p__keyA.stl
0.0182 x 0.0181 x 0.0107
