cyborgroid/Retro_Analog_Pastel_Computer/cad/out/build/print/handle__carry_handle.stl

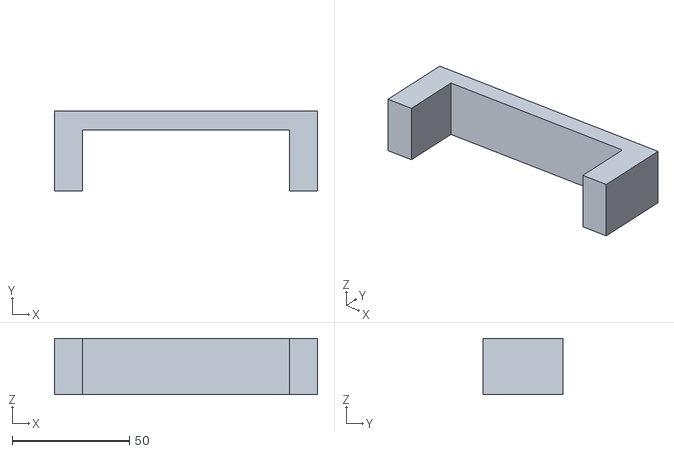
[picture p58: CAD file, 2026-10-26]
cad/out/build/print/handle__carry_handle.stl
112.0 x 34.0 x 24.0
