cyborgroid/Retro_Analog_Pastel_Computer/cad/out/build/print/splices__seam_shell_1_1_plate.stl

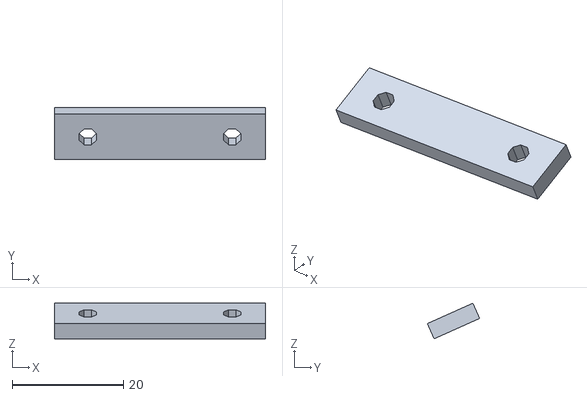
[picture p59: CAD file, 2026-10-26]
cad/out/build/print/splices__seam_shell_1_1_plate.stl
38.0 x 9.44 x 6.41
