cyborgroid/Retro_Analog_Pastel_Computer/cad/out/build/print/cover_b1.stl

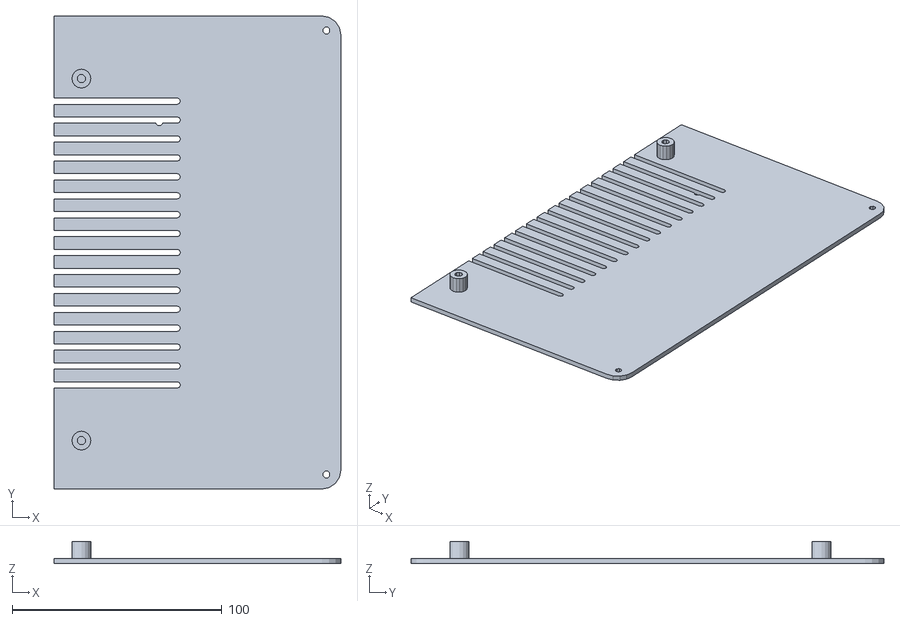
[picture p60: CAD file, 2026-10-26]
cad/out/build/print/cover_b1.stl
136.6 x 225.2 x 10.5
