cyborgroid/Retro_Analog_Pastel_Computer/cad/out/build/print/trim__stripe_1.stl

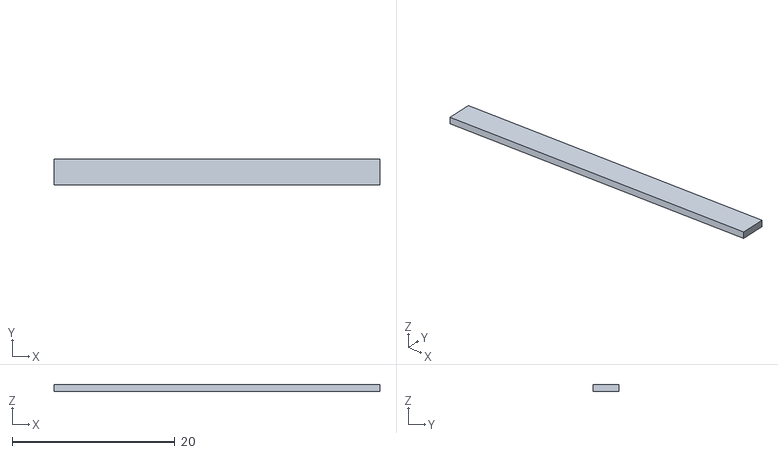
[picture p61: CAD file, 2026-10-26]
cad/out/build/print/trim__stripe_1.stl
40.0 x 3.20 x 0.8
