cyborgroid/Retro_Analog_Pastel_Computer/cad/out/build/urdf/meshes/key_space__keyB.stl

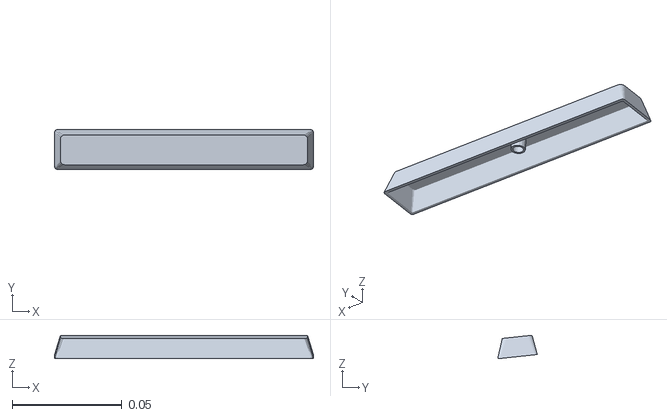
[picture p62: CAD file, 2026-10-26]
cad/out/build/urdf/meshes/key_space__keyB.stl
0.118 x 0.0181 x 0.0107
