cyborgroid/Retro_Analog_Pastel_Computer/cad/out/build/urdf/meshes/kb_foot_r__tray.stl

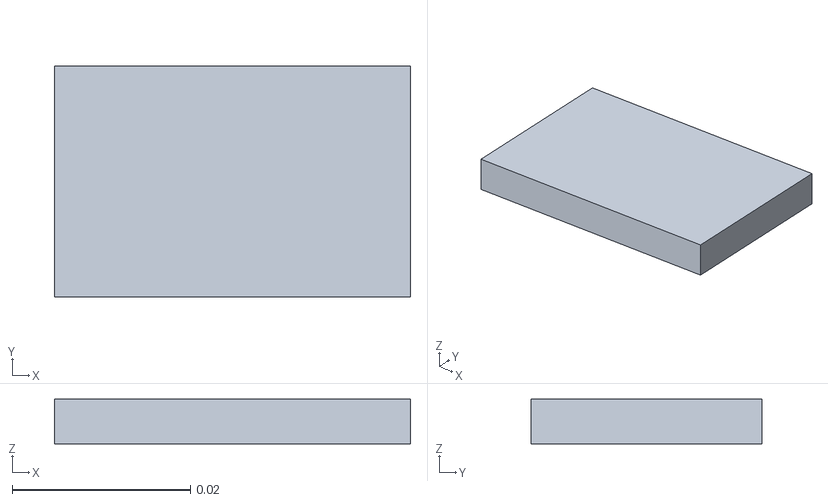
[picture p63: CAD file, 2026-10-26]
cad/out/build/urdf/meshes/kb_foot_r__tray.stl
0.04 x 0.026 x 0.005
