cyborgroid/Retro_Analog_Pastel_Computer/cad/out/build/urdf/meshes/base_lid__trim.stl

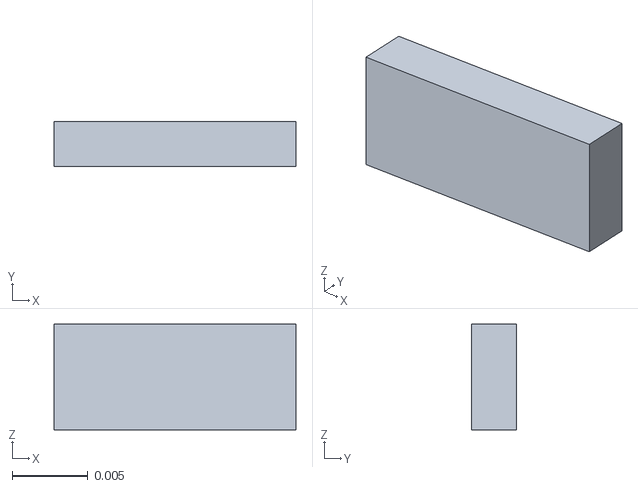
[picture p64: CAD file, 2026-10-26]
cad/out/build/urdf/meshes/base_lid__trim.stl
0.016 x 0.003 x 0.007
