cyborgroid/Retro_Analog_Pastel_Computer/cad/out/build/print/knobs__dial_vol_knob.stl

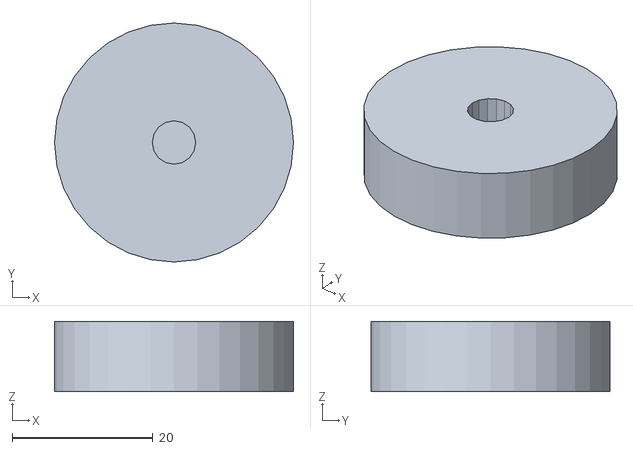
[picture p65: CAD file, 2026-10-26]
cad/out/build/print/knobs__dial_vol_knob.stl
34.0 x 34.0 x 10.0
