cyborgroid/Retro_Analog_Pastel_Computer/cad/out/build/urdf/meshes/keyboard_case__stripe3.stl

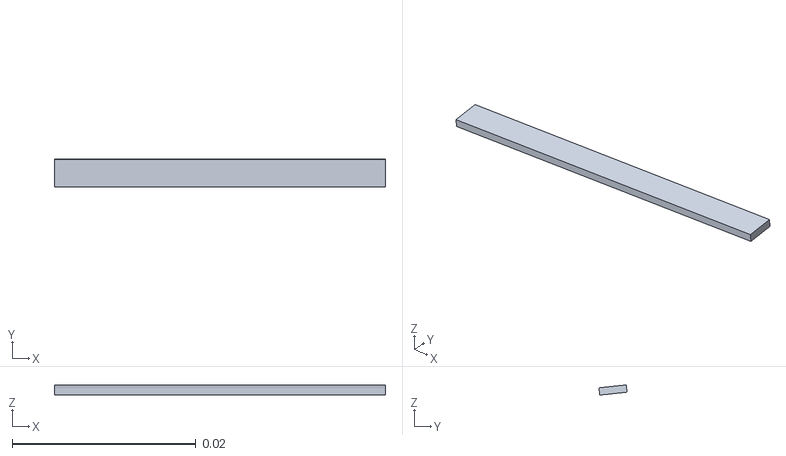
[picture p66: CAD file, 2026-10-26]
cad/out/build/urdf/meshes/keyboard_case__stripe3.stl
0.036 x 0.00307 x 0.00111
