cyborgroid/Retro_Analog_Pastel_Computer/cad/out/build/print/stand_base.stl

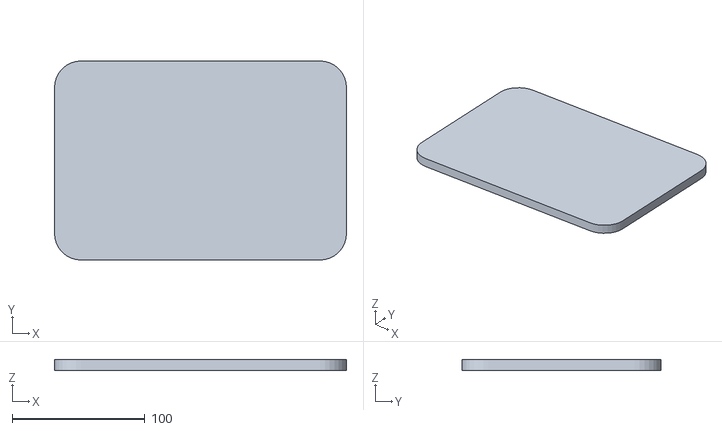
[picture p67: CAD file, 2026-10-26]
cad/out/build/print/stand_base.stl
220.0 x 150.0 x 8.00
