cyborgroid/Retro_Analog_Pastel_Computer/cad/out/build/urdf/meshes/base_lid__led.stl

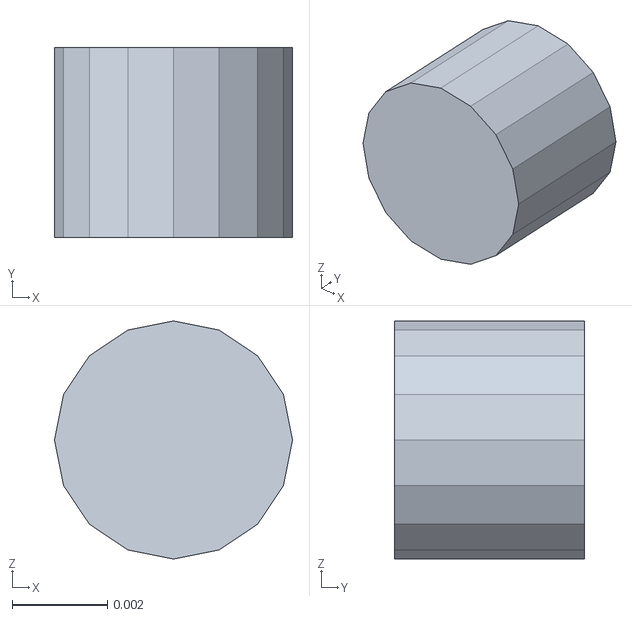
[picture p68: CAD file, 2026-10-26]
cad/out/build/urdf/meshes/base_lid__led.stl
0.005 x 0.004 x 0.005
