cyborgroid/Retro_Analog_Pastel_Computer/cad/out/build/print/trim__toggle_plate.stl

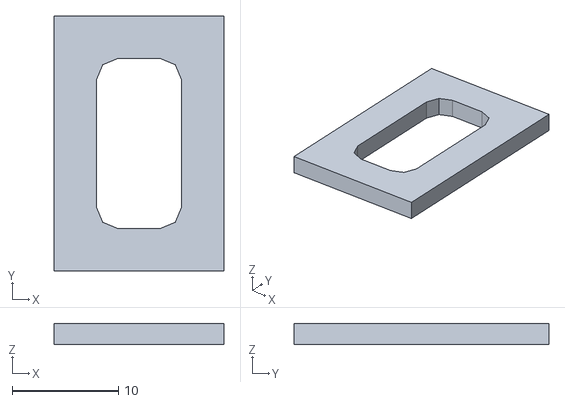
[picture p69: CAD file, 2026-10-26]
cad/out/build/print/trim__toggle_plate.stl
16.0 x 24.0 x 2.00
