cyborgroid/Retro_Analog_Pastel_Computer/cad/out/build/print/knobs__dial_tone_mark.stl

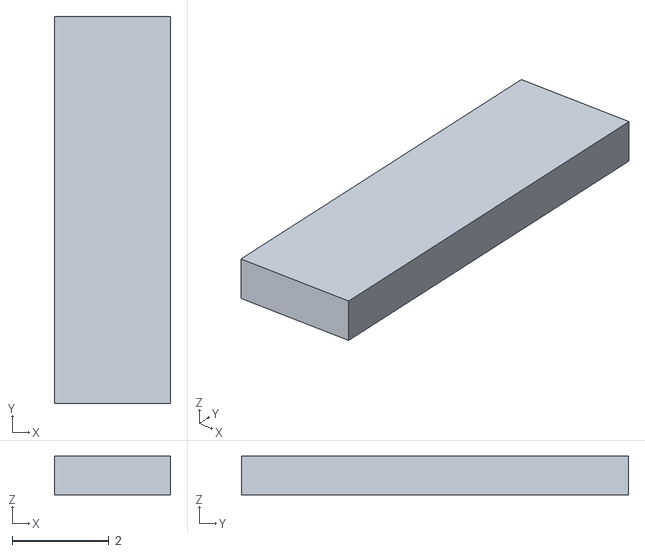
[picture p70: CAD file, 2026-10-26]
cad/out/build/print/knobs__dial_tone_mark.stl
2.40 x 8.00 x 0.8
