cyborgroid/Retro_Analog_Pastel_Computer/cad/out/build/print/knobs__knob_bright_cap.stl

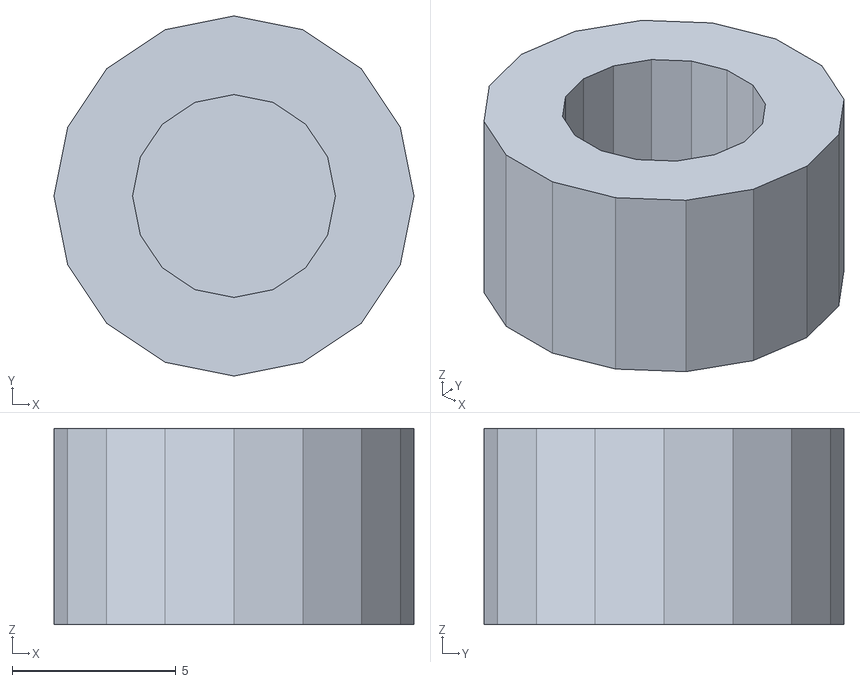
[picture p71: CAD file, 2026-10-26]
cad/out/build/print/knobs__knob_bright_cap.stl
11.0 x 11.0 x 6.00
