cyborgroid/Retro_Analog_Pastel_Computer/cad/out/build/print/kbcase_a1.stl

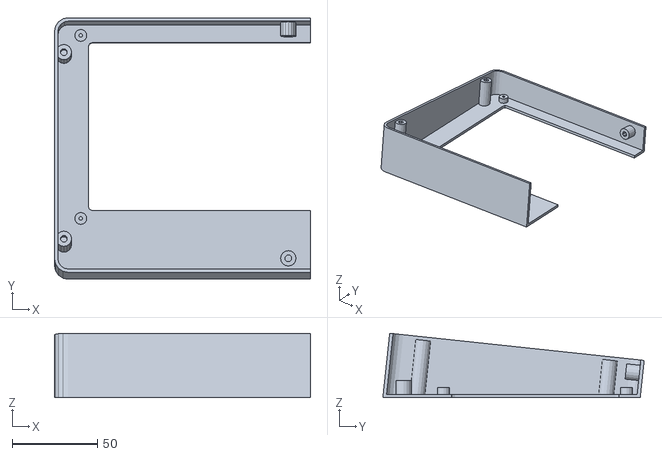
[picture p72: CAD file, 2026-10-26]
cad/out/build/print/kbcase_a1.stl
150.0 x 153.2 x 37.8
