cyborgroid/Retro_Analog_Pastel_Computer/cad/out/build/print/trim__usb_bay_bezel.stl

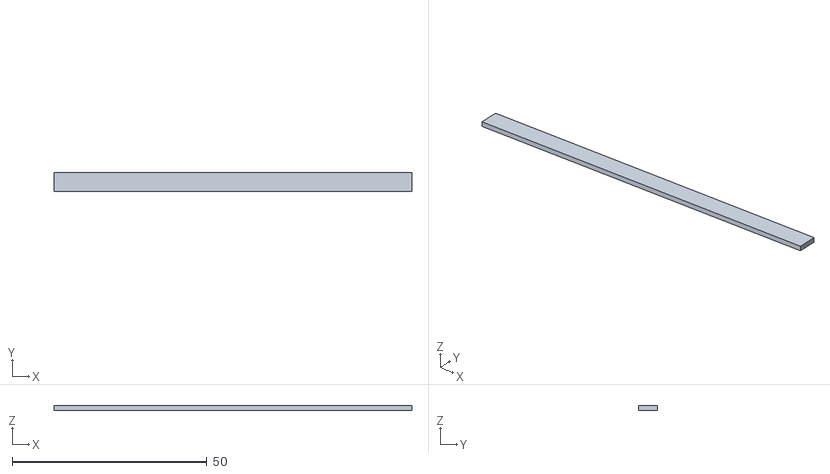
[picture p73: CAD file, 2026-10-26]
cad/out/build/print/trim__usb_bay_bezel.stl
92.0 x 5.00 x 1.20
