cyborgroid/Retro_Analog_Pastel_Computer/(list of files, cad)

Other CAD files:
cad/out/build/print/shell_a2.stl
cad/out/build/print/splices__seam_lid_0_2_plate.stl
cad/out/urdf/meshes/mouse_roller_y__alu.stl
cad/out/build/print/splices__seam_lid_0_0_plate.stl
cad/out/build/print/splices__seam_bezel_1_1_plate.stl
cad/out/build/print/clips__panel_clip_bottom_l.stl
cad/out/build/print/splices__seam_kbbottom_0_0_plate.stl
cad/out/build/print/splices__seam_lid_1_5_plate.stl
cad/out/build/print/trim__kb_stripe_1.stl
cad/out/build/print/clips__panel_clip_right_down.stl
cad/out/build/print/splices__seam_shell_0_2_plate.stl
cad/out/build/urdf/meshes/knob_hsize__trim.stl
cad/out/build/print/bezel_b1.stl
cad/out/build/urdf/meshes/knob_bright__trim.stl
cad/out/build/print/splices__seam_shell_0_1_plate.stl
cad/out/build/urdf/meshes/dial_tone__trim.stl
cad/out/build/urdf/meshes/key_6__keyA.stl
cad/out/build/urdf/meshes/key_o__switch.stl
cad/out/build/print/splices__seam_shell_0_3_plate.stl
cad/out/build/urdf/meshes/key_slash__keyA.stl
cad/out/build/print/splices__seam_lid_1_4_plate.stl
cad/out/build/urdf/meshes/key_t__switch.stl
cad/out/build/print/splices__seam_shell_0_5_plate.stl
cad/out/build/urdf/meshes/key_w__switch.stl
cad/out/build/urdf/meshes/key_rbracket__switch.stl
cad/out/build/print/splices__seam_kbbottom_0_1_plate.stl
cad/out/build/urdf/meshes/key_c__switch.stl
cad/out/build/urdf/meshes/key_v__switch.stl
cad/out/build/print/splices__seam_shell_0_0_plate.stl
cad/out/build/print/splices__seam_lid_1_3_plate.stl
cad/out/build/urdf/meshes/key_s__switch.stl
cad/out/build/print/splices__seam_tray_1_1_plate.stl
cad/out/build/urdf/meshes/key_f__switch.stl
cad/out/build/print/clips__panel_clip_right_up.stl
cad/out/build/print/splices__seam_shell_1_5_plate.stl
cad/out/build/urdf/meshes/key_semicolon__switch.stl
cad/out/build/print/splices__seam_shell_1_0_plate.stl
cad/out/build/urdf/meshes/key_b__switch.stl
cad/out/build/print/splices__seam_shell_1_4_plate.stl
cad/out/build/urdf/meshes/key_z__keyA.stl
cad/out/build/urdf/meshes/key_2__switch.stl
cad/out/build/print/splices__seam_bezel_0_0_plate.stl
cad/out/build/urdf/meshes/key_y__keyA.stl
cad/out/build/print/tray_a2.stl
cad/out/build/urdf/meshes/key_n__keyA.stl
cad/out/build/urdf/meshes/key_w__keyA.stl
cad/out/build/urdf/meshes/key_g__switch.stl
cad/out/build/print/splices__seam_shell_1_2_plate.stl
cad/out/build/urdf/meshes/key_1__keyA.stl
cad/out/build/print/tray_b1.stl
cad/out/build/urdf/meshes/key_space__switch.stl
cad/out/build/print/splices__seam_kbcase_0_1_plate.stl
cad/out/build/urdf/meshes/key_9__keyA.stl
cad/out/build/print/tray_b2.stl
cad/out/build/urdf/meshes/key_i__keyA.stl
cad/out/build/print/splices__seam_tray_0_0_plate.stl
cad/out/build/urdf/meshes/key_minus__keyA.stl
cad/out/build/print/lid_a2.stl
cad/out/build/urdf/meshes/key_x__switch.stl
cad/out/build/print/shell_a1.stl
cad/out/build/urdf/meshes/key_0__switch.stl
cad/out/build/urdf/meshes/key_period__keyA.stl
cad/out/build/print/splices__seam_lid_0_1_plate.stl
cad/out/build/urdf/meshes/key_minus__switch.stl
cad/out/build/print/splices__seam_tray_0_1_plate.stl
cad/out/build/urdf/meshes/key_equal__keyA.stl
cad/out/build/urdf/meshes/key_bksp__switch.stl
cad/out/build/print/bezel_a2.stl
cad/out/build/urdf/meshes/key_comma__switch.stl
cad/out/build/urdf/meshes/key_comma__keyA.stl
cad/out/build/urdf/meshes/key_equal__switch.stl
cad/out/build/print/clips__panel_clip_bottom_r.stl
cad/out/build/print/cover_a1.stl
cad/out/build/print/kbbottom_b1.stl
cad/out/build/print/kbcase_b1.stl
cad/out/build/print/knobs__dial_tone_knob.stl
cad/out/build/print/knobs__knob_hsize_cap.stl
cad/out/build/print/knobs__knob_vhold_cap.stl
cad/out/build/print/lid_b1.stl
cad/out/build/print/lid_b2.stl
cad/out/build/print/mbase.stl
cad/out/build/print/mbody.stl
cad/out/build/print/mbutton.stl
cad/out/build/print/splices__seam_bezel_1_0_plate.stl
cad/out/build/print/splices__seam_cover_0_0_plate.stl
cad/out/build/print/splices__seam_cover_0_1_plate.stl
cad/out/build/print/splices__seam_lid_0_3_plate.stl
cad/out/build/print/splices__seam_lid_1_0_plate.stl
cad/out/build/print/splices__seam_lid_1_1_plate.stl
cad/out/build/print/splices__seam_lid_1_2_plate.stl
cad/out/build/print/splices__seam_shell_1_3_plate.stl
cad/out/build/print/trim__brand_badge.stl
cad/out/build/print/trim__kb_stripe_0.stl
cad/out/build/urdf/meshes/base_lid__dark.stl
cad/out/build/urdf/meshes/base_lid__stripe1.stl
cad/out/build/urdf/meshes/base_lid__stripe2.stl
cad/out/build/urdf/meshes/base_lid__stripe3.stl
cad/out/build/urdf/meshes/base_lid__stripe4.stl
cad/out/build/urdf/meshes/base_tray__rubber.stl
cad/out/build/urdf/meshes/dial_tone__dark.stl
cad/out/build/urdf/meshes/dial_vol__dark.stl
cad/out/build/urdf/meshes/key_0__keyA.stl
cad/out/build/urdf/meshes/key_1__switch.stl
cad/out/build/urdf/meshes/key_2__keyA.stl
cad/out/build/urdf/meshes/key_3__keyA.stl
cad/out/build/urdf/meshes/key_3__switch.stl
cad/out/build/urdf/meshes/key_4__keyA.stl
cad/out/build/urdf/meshes/key_4__switch.stl
cad/out/build/urdf/meshes/key_5__keyA.stl
cad/out/build/urdf/meshes/key_5__switch.stl
cad/out/build/urdf/meshes/key_6__switch.stl
cad/out/build/urdf/meshes/key_7__keyA.stl
cad/out/build/urdf/meshes/key_7__switch.stl
cad/out/build/urdf/meshes/key_8__keyA.stl
cad/out/build/urdf/meshes/key_8__switch.stl
cad/out/build/urdf/meshes/key_9__switch.stl
cad/out/build/urdf/meshes/key_a__keyA.stl
cad/out/build/urdf/meshes/key_a__switch.stl
cad/out/build/urdf/meshes/key_b__keyA.stl
cad/out/build/urdf/meshes/key_bksp__keyB.stl
cad/out/build/urdf/meshes/key_c__keyA.stl
cad/out/build/urdf/meshes/key_d__keyA.stl
cad/out/build/urdf/meshes/key_d__switch.stl
cad/out/build/urdf/meshes/key_e__keyA.stl
cad/out/build/urdf/meshes/key_e__switch.stl
cad/out/build/urdf/meshes/key_enter__switch.stl
cad/out/build/urdf/meshes/key_f__keyA.stl
cad/out/build/urdf/meshes/key_g__keyA.stl
cad/out/build/urdf/meshes/key_h__keyA.stl
cad/out/build/urdf/meshes/key_h__switch.stl
cad/out/build/urdf/meshes/key_i__switch.stl
cad/out/build/urdf/meshes/key_j__keyA.stl
cad/out/build/urdf/meshes/key_j__switch.stl
cad/out/build/urdf/meshes/key_k__keyA.stl
cad/out/build/urdf/meshes/key_l__keyA.stl
cad/out/build/urdf/meshes/key_l__switch.stl
cad/out/build/urdf/meshes/key_lbracket__keyA.stl
cad/out/build/urdf/meshes/key_lbracket__switch.stl
cad/out/build/urdf/meshes/key_m__keyA.stl
cad/out/build/urdf/meshes/key_m__switch.stl
cad/out/build/urdf/meshes/key_n__switch.stl
cad/out/build/urdf/meshes/key_o__keyA.stl
cad/out/build/urdf/meshes/key_p__switch.stl
cad/out/build/urdf/meshes/key_period__switch.stl
cad/out/build/urdf/meshes/key_q__keyA.stl
cad/out/build/urdf/meshes/key_q__switch.stl
cad/out/build/urdf/meshes/key_quote__keyA.stl
cad/out/build/urdf/meshes/key_quote__switch.stl
cad/out/build/urdf/meshes/key_r__keyA.stl
cad/out/build/urdf/meshes/key_r__switch.stl
cad/out/build/urdf/meshes/key_rbracket__keyA.stl
cad/out/build/urdf/meshes/key_s__keyA.stl
cad/out/build/urdf/meshes/key_semicolon__keyA.stl
cad/out/build/urdf/meshes/key_shift__keyB.stl
cad/out/build/urdf/meshes/key_shift__switch.stl
cad/out/build/urdf/meshes/key_slash__switch.stl
cad/out/build/urdf/meshes/key_t__keyA.stl
cad/out/build/urdf/meshes/key_u__keyA.stl
cad/out/build/urdf/meshes/key_u__switch.stl
cad/out/build/urdf/meshes/key_v__keyA.stl
cad/out/build/urdf/meshes/key_x__keyA.stl
cad/out/build/urdf/meshes/key_y__switch.stl
cad/out/build/urdf/meshes/key_z__switch.stl
cad/out/build/urdf/meshes/keyboard_case__stripe1.stl
cad/out/build/urdf/meshes/keyboard_case__stripe2.stl
cad/out/build/urdf/meshes/keyboard_case__stripe4.stl
cad/out/build/urdf/meshes/keyboard_case__switch.stl
cad/out/build/urdf/meshes/mouse_button__trim.stl
cad/out/build/urdf/meshes/power_toggle__alu.stl
