cyborgroid/Retro_Analog_Pastel_Computer/environments/assembly/steps.md

# 조립 공정 (자동 생성)

`src/js/data/assembly.js`에서 생성됩니다. 수정은 그 파일에서 하고 `node tools/export-data.js`를 실행하세요.

## 01. 하부 트레이와 고무발

- 모듈: 본체
- 예상 시간: 3분 (누적 3분)
- 공구: 작업 매트, 이소프로필 알코올 와이프
- 체결 부품: 고무발 Ø14 × 4 (양면 테이프)
- 토크: —

**작업 요령**

- 트레이 안쪽 성형 리브에 크랙이 없는지 확인합니다.
- 고무발은 모서리에서 20 mm 안쪽 원형 각인에 붙입니다.

**검수**

- [ ] 트레이 크랙·버(burr) 없음
- [ ] 고무발 4개 수평 확인

## 02. 강판 섀시와 스탠드오프

- 모듈: 본체
- 예상 시간: 5분 (누적 8분)
- 공구: #2 십자 드라이버, 5 mm 너트 드라이버
- 체결 부품: M3 × 6 접시머리 × 6, M3 스탠드오프 6 mm × 6
- 토크: 0.5 N·m

**작업 요령**

- 섀시 판은 접지 러그가 뒤쪽 오른편에 오도록 놓습니다.
- 스탠드오프는 대각선 순서로 조입니다.

**검수**

- [ ] 섀시–트레이 간 유격 없음
- [ ] 스탠드오프 6개 높이 균일

## 03. PX-80 메인보드 고정

- 모듈: 본체
- 예상 시간: 6분 (누적 14분)
- 공구: #1 십자 드라이버, 정전기 손목띠
- 체결 부품: M3 × 6 팬헤드 + 톱니와셔 × 6
- 토크: 0.45 N·m

**작업 요령**

- 손목띠를 섀시 접지 러그에 연결한 뒤 기판을 다룹니다.
- 후면 커넥터가 트레이 개구부에 맞는지 먼저 가조립합니다.

**검수**

- [ ] 기판 휨 없음
- [ ] 접지 나사(★표시) 톱니와셔 체결

## 04. IC 실장: CPU · EEPROM · SRAM · Pico · XTAL

- 모듈: 본체
- 예상 시간: 8분 (누적 22분)
- 공구: IC 삽입기, 핀 교정기, 루페 ×10
- 체결 부품: 40핀 · 28핀 DIP 소켓, Pico용 20핀 헤더 × 4
- 토크: —

**작업 요령**

- 1번 핀 노치를 실크 표시와 맞춥니다.
- Pico 두 개(비디오·사운드)는 74LVC245 레벨 시프터 옆 헤더에 꽂습니다. 3.3V 핀을 5V 버스에 직접 연결하면 안 됩니다.

**검수**

- [ ] 모든 IC 노치 방향 일치
- [ ] 휜 핀 없음 (루페 확인)

## 05. 전원부: 트랜스 · 방열판 · C1

- 모듈: 본체
- 예상 시간: 7분 (누적 29분)
- 공구: #2 십자 드라이버, 써멀 패드, 토크 드라이버
- 체결 부품: M4 × 8 × 4 (트랜스), M3 × 10 + 절연 부싱 × 3 (레귤레이터)
- 토크: 트랜스 1.2 N·m / 레귤레이터 0.6 N·m

**작업 요령**

- 7805/7812/7912 탭과 방열판 사이에 써멀 패드와 절연 부싱을 넣습니다.
- C1(4700 µF) 극성 띠가 섀시 쪽을 향하게 합니다.

**검수**

- [ ] 레귤레이터 탭–방열판 절연 ≥ 10 MΩ
- [ ] C1 극성 확인
- [ ] AC 1차측 수축 튜브 처리

## 06. USB 저장장치 베이 (CH376S)

- 모듈: 본체
- 예상 시간: 4분 (누적 33분)
- 공구: #1 십자 드라이버
- 체결 부품: M3 × 5 × 4 (측면)
- 토크: 0.4 N·m

**작업 요령**

- Gotek 형태 3.5" 베이 패널을 앞쪽에서 밀어 넣어 전면 슬롯과 1 mm 이내로 맞춥니다. CH376S 모듈은 패널 뒤에 고정합니다.

**검수**

- [ ] USB 메모리 삽입 걸림 없음
- [ ] 접근 LED 창 정렬

## 07. 배선 하네스: 리본 · 전원 · 스피커

- 모듈: 본체
- 예상 시간: 5분 (누적 38분)
- 공구: 케이블 타이, 니퍼
- 체결 부품: 케이블 타이 100 mm × 6, 리본 클램프 × 2
- 토크: —

**작업 요령**

- 리본 케이블 빨간 줄(1번 핀)을 CH376S 모듈의 1번 핀에 맞춥니다.
- 전원선은 방열판에서 15 mm 이상 띄웁니다.

**검수**

- [ ] 커넥터 역삽 없음
- [ ] 배선이 상판 리브와 간섭 없음

## 08. 상판과 전면 다이얼

- 모듈: 본체
- 예상 시간: 4분 (누적 42분)
- 공구: #2 십자 드라이버, 노브 렌치
- 체결 부품: M3 × 12 셀프태핑 × 4 (하부에서), 로터리 노브 세트스크루 M2 × 2
- 토크: 0.6 N·m

**작업 요령**

- 상판 앞쪽 훅을 먼저 걸고 뒤쪽을 내립니다.
- 볼륨·톤 다이얼 표시선이 7시 방향(최소)에서 시작하도록 고정합니다.

**검수**

- [ ] 상판–트레이 단차 ≤ 0.3 mm
- [ ] 다이얼 회전 걸림 없음

## 09. 틸트·스위블 스탠드

- 모듈: 모니터
- 예상 시간: 3분 (누적 45분)
- 공구: #2 십자 드라이버
- 체결 부품: M4 × 10 × 4
- 토크: 1.0 N·m

**작업 요령**

- 스탠드는 본체 상판의 4점 포켓에 끼워 미끄러짐을 막습니다.

**검수**

- [ ] 스위블 ±90° 부드러움
- [ ] 틸트 −5° ~ +12° 유지력

## 10. 슬림 베젤과 전면 유리

- 모듈: 모니터
- 예상 시간: 5분 (누적 50분)
- 공구: 극세사 장갑, 베젤 지그
- 체결 부품: 베젤 스냅 × 10, M3 × 8 × 4 (하단 턱)
- 토크: 0.5 N·m

**작업 요령**

- 12 mm 슬림 베젤이라 스냅이 약합니다. 지그로 네 모서리를 동시에 누릅니다.
- 하단 턱(20 mm)에 노브 3개와 LED 창이 들어갑니다.

**검수**

- [ ] 베젤–유리 간격 균일
- [ ] 노브 축 정렬

## 11. 19" 16:10 CRT 튜브 삽입

- 모듈: 모니터
- 예상 시간: 10분 (누적 60분)
- 공구: 튜브 리프터 (2인), 보안경, 방전 프로브
- 체결 부품: 튜브 이어 M5 × 16 × 4
- 토크: 2.5 N·m

**작업 요령**

- 반드시 2인 작업, 보안경을 착용합니다.
- 이어 볼트를 대각선 순서로 두 번에 나눠 조입니다.

**검수**

- [ ] 튜브 전면–베젤 밀착
- [ ] 아쿠아닥 접지 스프링 접촉

## 12. 편향 요크와 넥 보드

- 모듈: 모니터
- 예상 시간: 8분 (누적 68분)
- 공구: 요크 클램프 드라이버, 자석 교정 링
- 체결 부품: 요크 클램프 M3 × 1, 넥 보드 소켓
- 토크: 0.3 N·m (클램프)

**작업 요령**

- 요크를 넥 끝까지 밀어 넣은 뒤 화면 기울기를 보며 회전 정렬합니다.
- 넥 보드 소켓은 키 홈을 맞춰 수직으로 꽂습니다.

**검수**

- [ ] 요크 회전 고정
- [ ] 넥 소켓 완전 삽입

## 13. 플라이백과 디가우싱 코일

- 모듈: 모니터
- 예상 시간: 6분 (누적 74분)
- 공구: 고압 장갑, 방전 프로브, 케이블 타이
- 체결 부품: 플라이백 브래킷 M3 × 2, 디가우싱 코일 클립 × 4
- 토크: 0.5 N·m

**작업 요령**

- 애노드 캡은 고무 테두리가 유리면에 완전히 밀착되도록 꽂습니다.
- 디가우싱 코일은 튜브 테두리를 따라 클립 4개로 고정합니다.

**검수**

- [ ] 애노드 캡 밀착
- [ ] 고압선–섀시 거리 ≥ 20 mm

## 14. 슬림 후면 셸

- 모듈: 모니터
- 예상 시간: 4분 (누적 78분)
- 공구: #2 십자 드라이버
- 체결 부품: M3 × 14 셀프태핑 × 6
- 토크: 0.6 N·m

**작업 요령**

- 셸 안쪽 차폐 테이프가 플라이백을 덮는지 확인합니다.

**검수**

- [ ] 셸 통풍구 막힘 없음
- [ ] 라벨(정격) 부착

## 15. 키보드 케이스와 매트릭스 PCB

- 모듈: 키보드
- 예상 시간: 6분 (누적 84분)
- 공구: #1 십자 드라이버, 납땜 인두 (다이오드 수정용)
- 체결 부품: M2.5 × 6 × 8
- 토크: 0.3 N·m

**작업 요령**

- 1N4148 다이오드 49개의 캐소드 띠가 모두 열(Column) 쪽인지 확인합니다.

**검수**

- [ ] 다이오드 방향 49/49
- [ ] DIN 케이블 스트레인 릴리프 체결

## 16. 키캡 장착

- 모듈: 키보드
- 예상 시간: 6분 (누적 90분)
- 공구: 키캡 풀러
- 체결 부품: 키캡 × 49, 스페이스바 스태빌라이저 × 1
- 토크: —

**작업 요령**

- 줄 단위(숫자 → 하단)로 꽂아 경사(6°) 프로파일을 맞춥니다.
- 스페이스바 스태빌라이저 와이어를 먼저 거치합니다.

**검수**

- [ ] 키캡 높이 단차 없음
- [ ] 스페이스바 양끝 고르게 눌림

## 17. 마우스 볼과 초퍼 엔코더

- 모듈: 마우스
- 예상 시간: 4분 (누적 94분)
- 공구: 핀셋, 에어 블로어
- 체결 부품: 엔코더 축 클립 × 2
- 토크: —

**작업 요령**

- 초퍼 휠 슬롯이 포토인터럽터 갭 중앙을 지나도록 축 높이를 맞춥니다.

**검수**

- [ ] X/Y 휠 걸림 없이 회전
- [ ] 볼 케이지 먼지 제거

## 18. 마우스 상부 셸

- 모듈: 마우스
- 예상 시간: 2분 (누적 96분)
- 공구: #0 십자 드라이버
- 체결 부품: M2 × 8 × 1 (하부)
- 토크: 0.15 N·m

**작업 요령**

- 버튼 액추에이터가 택트 스위치 위에 오도록 맞춥니다.

**검수**

- [ ] 좌·우 버튼 클릭감 동일

## 19. 케이블 연결: 키보드 · 마우스 · 비디오

- 모듈: 연결
- 예상 시간: 3분 (누적 99분)
- 공구: —
- 체결 부품: DIN-5 · DE-9 · RCA 비디오
- 토크: —

**작업 요령**

- 비디오 RCA는 노란색 단자, 마우스 DE-9는 본체 오른쪽에 꽂습니다.

**검수**

- [ ] 커넥터 완전 삽입
- [ ] 케이블 꺾임 반경 ≥ 30 mm

## 20. 전원 투입과 POST 검수

- 모듈: 검수
- 예상 시간: 10분 (누적 109분)
- 공구: 멀티미터, 오실로스코프, 테스트 디스크
- 체결 부품: —
- 토크: —

**작업 요령**

- 전원 스위치를 올리면 BIOS POST가 CPU · ROM · RAM · VDP · KBC · FDD를 순서대로 점검합니다.
- Instrument 탭에서 +5V 리플과 H-SYNC를 측정해 기록합니다.

**검수**

- [ ] POST 전 항목 OK
- [ ] +5V 4.90–5.10 V
- [ ] H-SYNC 15.734 kHz 고정
- [ ] 키 49개 입력 확인
