cyborgroid/Retro_Analog_Pastel_Computer/cad/out/build/print-plan.md

# 3D 프린팅 계획 (자동 생성)

`cad/rust`가 `cad/spec.json`에서 만듭니다. 조각 STL은 `print/`에 베드 위 출력 방향으로 놓여 있습니다.

- 프린터: 256 mm class (Bambu Lab P1S / A1, Prusa Core One) — 베드 256 × 256 × 256 mm (가장자리 여유 4 mm)
- 필라멘트: PLA (1.24 g/cm³), 추정 4458 g · 83.2 시간 · 약 98100원 (kg당 22000원 가정)
- 열압입 인서트: M3 heat-set insert, OD 4.6 x L 5.7 — 구멍 Ø4.1 × 깊이 6.7 mm (출력물마다 시험 출력으로 조정)
- 시간은 출력 부피 ÷ 12 mm³/s 로 계산한 하한입니다. 실제 시간은 슬라이서 결과를 따르세요.

## 조각 94개

| 파일 | 그룹 | 크기 W × D × H (mm) | 무게 (g) | 시간 (h) | 서포트 면적 (cm²) | 220 mm class (Creality Ender-3 V3) |
|---|---|---|---:|---:|---:|---|
| `bezel_a1.stl` | 모니터 베젤 (앞면이 베드) | 227.6 × 160.9 × 23.5 | 124.6 | 2.33 | 28.3 | 분할 필요 |
| `bezel_a2.stl` | 모니터 베젤 (앞면이 베드) | 227.6 × 160.9 × 28.5 | 202.7 | 3.78 | 27 | 분할 필요 |
| `bezel_b1.stl` | 모니터 베젤 (앞면이 베드) | 227.6 × 160.9 × 23.5 | 124.6 | 2.33 | 28.3 | 분할 필요 |
| `bezel_b2.stl` | 모니터 베젤 (앞면이 베드) | 227.6 × 160.9 × 28.5 | 200.8 | 3.75 | 27 | 분할 필요 |
| `clips__panel_clip_bottom_l.stl` | LCD 패널 클립 (립이 베드) | 20 × 22 × 14.5 | 4.6 | 0.09 | 0.9 | 가능 |
| `clips__panel_clip_bottom_r.stl` | LCD 패널 클립 (립이 베드) | 20 × 22 × 14.5 | 4.6 | 0.09 | 0.9 | 가능 |
| `clips__panel_clip_left_down.stl` | LCD 패널 클립 (립이 베드) | 18 × 22 × 15.5 | 4.6 | 0.09 | 4.3 | 가능 |
| `clips__panel_clip_left_up.stl` | LCD 패널 클립 (립이 베드) | 18 × 22 × 15.5 | 4.6 | 0.09 | 4.3 | 가능 |
| `clips__panel_clip_right_down.stl` | LCD 패널 클립 (립이 베드) | 18 × 22 × 15.5 | 4.6 | 0.09 | 0.9 | 가능 |
| `clips__panel_clip_right_up.stl` | LCD 패널 클립 (립이 베드) | 18 × 22 × 15.5 | 4.6 | 0.09 | 0.9 | 가능 |
| `clips__panel_clip_top_l.stl` | LCD 패널 클립 (립이 베드) | 20 × 22 × 14.5 | 4.6 | 0.09 | 4.7 | 가능 |
| `clips__panel_clip_top_r.stl` | LCD 패널 클립 (립이 베드) | 20 × 22 × 14.5 | 4.6 | 0.09 | 4.7 | 가능 |
| `cover_a1.stl` | 모니터 뒤 덮개 (바깥면이 베드) | 136.6 × 225.2 × 10.5 | 87.3 | 1.63 | 0 | 분할 필요 |
| `cover_b1.stl` | 모니터 뒤 덮개 (바깥면이 베드) | 136.6 × 225.2 × 10.5 | 87.3 | 1.63 | 0 | 분할 필요 |
| `handle__carry_handle.stl` | 모니터 손잡이 (나사 고정) | 112 × 34 × 24 | 45.2 | 0.84 | 0 | 가능 |
| `kbbottom_a1.stl` | 키보드 하판 | 147.8 × 145.6 × 10 | 51.4 | 0.96 | 0 | 가능 |
| `kbbottom_b1.stl` | 키보드 하판 | 147.8 × 145.6 × 10 | 51.4 | 0.96 | 0 | 가능 |
| `kbcase_a1.stl` | 키보드 케이스 (경사 윗면이 베드) | 150 × 153.2 × 37.8 | 59.8 | 1.12 | 0.7 | 가능 |
| `kbcase_b1.stl` | 키보드 케이스 (경사 윗면이 베드) | 150 × 153.2 × 37.8 | 59.8 | 1.12 | 0.7 | 가능 |
| `kbfeet__kb_foot_l.stl` | 키보드 접이식 다리 | 40 × 26 × 5 | 6.4 | 0.12 | 0 | 가능 |
| `kbfeet__kb_foot_r.stl` | 키보드 접이식 다리 | 40 × 26 × 5 | 6.4 | 0.12 | 0 | 가능 |
| `knobs__dial_tone_knob.stl` | 다이얼 · 노브 (앞면이 베드) | 34 × 34 × 10 | 10.9 | 0.2 | 0 | 가능 |
| `knobs__dial_tone_mark.stl` | 다이얼 · 노브 (앞면이 베드) | 2.4 × 8 × 0.8 | 0 | 0 | 0 | 가능 |
| `knobs__dial_vol_knob.stl` | 다이얼 · 노브 (앞면이 베드) | 34 × 34 × 10 | 10.9 | 0.2 | 0 | 가능 |
| `knobs__dial_vol_mark.stl` | 다이얼 · 노브 (앞면이 베드) | 2.4 × 8 × 0.8 | 0 | 0 | 0 | 가능 |
| `knobs__knob_bright_cap.stl` | 다이얼 · 노브 (앞면이 베드) | 11 × 11 × 6 | 0.5 | 0.01 | 0 | 가능 |
| `knobs__knob_hsize_cap.stl` | 다이얼 · 노브 (앞면이 베드) | 11 × 11 × 6 | 0.5 | 0.01 | 0 | 가능 |
| `knobs__knob_vhold_cap.stl` | 다이얼 · 노브 (앞면이 베드) | 11 × 11 × 6 | 0.5 | 0.01 | 0 | 가능 |
| `lid_a1.stl` | 본체 상판 (윗면이 베드) | 220 × 170 × 80 | 205.2 | 3.83 | 17.1 | 분할 필요 |
| `lid_a2.stl` | 본체 상판 (윗면이 베드) | 220 × 170 × 80 | 204.1 | 3.81 | 18.6 | 분할 필요 |
| `lid_b1.stl` | 본체 상판 (윗면이 베드) | 220 × 170 × 80 | 186.6 | 3.48 | 17.4 | 분할 필요 |
| `lid_b2.stl` | 본체 상판 (윗면이 베드) | 220 × 170 × 80 | 205 | 3.83 | 17 | 분할 필요 |
| `mbase.stl` | 마우스 바닥판 + 스위치 기둥 | 62 × 100 × 20 | 24.5 | 0.46 | 0 | 가능 |
| `mbody.stl` | 마우스 몸체 (윗면이 베드) | 62 × 100 × 27 | 33 | 0.62 | 0 | 가능 |
| `mbutton.stl` | 마우스 버튼 | 51 × 35 × 4 | 8.8 | 0.16 | 0 | 가능 |
| `shell_a1.stl` | 모니터 후면 셸 (앞 테두리가 베드) | 227.6 × 170.9 × 248.5 | 245.9 | 4.59 | 4.8 | 분할 필요 |
| `shell_a2.stl` | 모니터 후면 셸 (앞 테두리가 베드) | 227.6 × 170.9 × 248.5 | 334.4 | 6.24 | 12.5 | 분할 필요 |
| `shell_b1.stl` | 모니터 후면 셸 (앞 테두리가 베드) | 227.6 × 170.9 × 248.5 | 245.9 | 4.59 | 4.6 | 분할 필요 |
| `shell_b2.stl` | 모니터 후면 셸 (앞 테두리가 베드) | 227.6 × 170.9 × 248.5 | 334.4 | 6.24 | 12.3 | 분할 필요 |
| `splices__seam_bezel_0_0_plate.stl` | 분할 이음 연결판 | 38 × 9 × 3 | 1.2 | 0.02 | 0 | 가능 |
| `splices__seam_bezel_1_0_plate.stl` | 분할 이음 연결판 | 9 × 38 × 3 | 1.2 | 0.02 | 0 | 가능 |
| `splices__seam_bezel_1_1_plate.stl` | 분할 이음 연결판 | 9 × 38 × 3 | 1.2 | 0.02 | 0 | 가능 |
| `splices__seam_cover_0_0_plate.stl` | 분할 이음 연결판 | 38 × 9 × 3 | 1.2 | 0.02 | 0 | 가능 |
| `splices__seam_cover_0_1_plate.stl` | 분할 이음 연결판 | 38 × 9 × 3 | 1.2 | 0.02 | 0 | 가능 |
| `splices__seam_kbbottom_0_0_plate.stl` | 분할 이음 연결판 | 38 × 9 × 3 | 1.2 | 0.02 | 0 | 가능 |
| `splices__seam_kbbottom_0_1_plate.stl` | 분할 이음 연결판 | 38 × 9 × 3 | 1.2 | 0.02 | 0 | 가능 |
| `splices__seam_kbcase_0_0_plate.stl` | 분할 이음 연결판 | 38 × 9.3 × 3.9 | 1.2 | 0.02 | 1.5 | 가능 |
| `splices__seam_kbcase_0_1_plate.stl` | 분할 이음 연결판 | 38 × 9 × 3 | 1.2 | 0.02 | 0 | 가능 |
| `splices__seam_lid_0_0_plate.stl` | 분할 이음 연결판 | 38 × 9 × 3 | 1.2 | 0.02 | 0 | 가능 |
| `splices__seam_lid_0_1_plate.stl` | 분할 이음 연결판 | 38 × 9 × 3 | 1.2 | 0.02 | 0 | 가능 |
| `splices__seam_lid_0_2_plate.stl` | 분할 이음 연결판 | 38 × 9 × 3 | 1.2 | 0.02 | 0 | 가능 |
| `splices__seam_lid_0_3_plate.stl` | 분할 이음 연결판 | 38 × 9 × 3 | 1.2 | 0.02 | 0 | 가능 |
| `splices__seam_lid_1_0_plate.stl` | 분할 이음 연결판 | 9 × 38 × 3 | 1.2 | 0.02 | 0 | 가능 |
| `splices__seam_lid_1_1_plate.stl` | 분할 이음 연결판 | 9 × 38 × 3 | 1.2 | 0.02 | 0 | 가능 |
| `splices__seam_lid_1_2_plate.stl` | 분할 이음 연결판 | 9 × 38 × 3 | 1.2 | 0.02 | 0 | 가능 |
| `splices__seam_lid_1_3_plate.stl` | 분할 이음 연결판 | 9 × 38 × 3 | 1.2 | 0.02 | 0 | 가능 |
| `splices__seam_lid_1_4_plate.stl` | 분할 이음 연결판 | 9 × 38 × 3 | 1.2 | 0.02 | 0 | 가능 |
| `splices__seam_lid_1_5_plate.stl` | 분할 이음 연결판 | 9 × 38 × 3 | 1.2 | 0.02 | 0 | 가능 |
| `splices__seam_shell_0_0_plate.stl` | 분할 이음 연결판 | 38 × 9 × 3 | 1.2 | 0.02 | 0 | 가능 |
| `splices__seam_shell_0_1_plate.stl` | 분할 이음 연결판 | 38 × 9 × 3 | 1.2 | 0.02 | 0 | 가능 |
| `splices__seam_shell_0_2_plate.stl` | 분할 이음 연결판 | 38 × 9.4 × 6.6 | 1.2 | 0.02 | 1.8 | 가능 |
| `splices__seam_shell_0_3_plate.stl` | 분할 이음 연결판 | 38 × 9.4 × 6.6 | 1.2 | 0.02 | 1.8 | 가능 |
| `splices__seam_shell_0_4_plate.stl` | 분할 이음 연결판 | 38 × 9.4 × 6.6 | 1.2 | 0.02 | 1.8 | 가능 |
| `splices__seam_shell_0_5_plate.stl` | 분할 이음 연결판 | 38 × 9 × 3 | 1.2 | 0.02 | 0 | 가능 |
| `splices__seam_shell_1_0_plate.stl` | 분할 이음 연결판 | 38 × 9.4 × 6.4 | 1.2 | 0.02 | 1.8 | 가능 |
| `splices__seam_shell_1_1_plate.stl` | 분할 이음 연결판 | 38 × 9.4 × 6.4 | 1.2 | 0.02 | 1.8 | 가능 |
| `splices__seam_shell_1_2_plate.stl` | 분할 이음 연결판 | 38 × 9.4 × 6.4 | 1.2 | 0.02 | 1.8 | 가능 |
| `splices__seam_shell_1_3_plate.stl` | 분할 이음 연결판 | 38 × 9 × 3 | 1.2 | 0.02 | 0 | 가능 |
| `splices__seam_shell_1_4_plate.stl` | 분할 이음 연결판 | 38 × 9.4 × 6.4 | 1.2 | 0.02 | 1.8 | 가능 |
| `splices__seam_shell_1_5_plate.stl` | 분할 이음 연결판 | 38 × 9.4 × 6.4 | 1.2 | 0.02 | 1.8 | 가능 |
| `splices__seam_tray_0_0_plate.stl` | 분할 이음 연결판 | 38 × 9 × 3 | 1.2 | 0.02 | 0 | 가능 |
| `splices__seam_tray_0_1_plate.stl` | 분할 이음 연결판 | 38 × 9 × 3 | 1.2 | 0.02 | 0 | 가능 |
| `splices__seam_tray_1_0_plate.stl` | 분할 이음 연결판 | 9 × 38 × 3 | 1.2 | 0.02 | 0 | 가능 |
| `splices__seam_tray_1_1_plate.stl` | 분할 이음 연결판 | 9 × 38 × 3 | 1.2 | 0.02 | 0 | 가능 |
| `stand_base.stl` | 모니터 스탠드 받침 | 220 × 150 × 8 | 323.9 | 6.05 | 0 | 분할 필요 |
| `stand_neck__stand_neck.stl` | 스위블 목 (베어링 ↔ 크래들) | 72 × 72 × 4 | 20.1 | 0.37 | 0 | 가능 |
| `stand_swivel.stl` | 틸트 크래들 (평평한 바닥이 베드) | 160 × 90 × 18 | 265.3 | 4.95 | 0 | 가능 |
| `tray_a1.stl` | 본체 하부 트레이 (바닥면이 베드) | 220 × 170 × 30 | 151.7 | 2.83 | 0.9 | 분할 필요 |
| `tray_a2.stl` | 본체 하부 트레이 (바닥면이 베드) | 220 × 170 × 30 | 151.7 | 2.83 | 0 | 분할 필요 |
| `tray_b1.stl` | 본체 하부 트레이 (바닥면이 베드) | 220 × 170 × 30 | 151.7 | 2.83 | 1.8 | 분할 필요 |
| `tray_b2.stl` | 본체 하부 트레이 (바닥면이 베드) | 220 × 170 × 30 | 151.7 | 2.83 | 0.9 | 분할 필요 |
| `trim__brand_badge.stl` | 배지 · 스트라이프 · 소형 트림 | 110 × 14 × 0.8 | 1.5 | 0.03 | 0 | 가능 |
| `trim__brand_badge_monitor.stl` | 배지 · 스트라이프 · 소형 트림 | 62 × 10 × 0.8 | 0.6 | 0.01 | 0 | 가능 |
| `trim__eject_button.stl` | 배지 · 스트라이프 · 소형 트림 | 16 × 7 × 3 | 0.4 | 0.01 | 0 | 가능 |
| `trim__kb_stripe_0.stl` | 배지 · 스트라이프 · 소형 트림 | 36 × 3.1 × 1.1 | 0.1 | 0 | 0 | 가능 |
| `trim__kb_stripe_1.stl` | 배지 · 스트라이프 · 소형 트림 | 36 × 3.1 × 1.1 | 0.1 | 0 | 0 | 가능 |
| `trim__kb_stripe_2.stl` | 배지 · 스트라이프 · 소형 트림 | 36 × 3.1 × 1.1 | 0.1 | 0 | 0 | 가능 |
| `trim__kb_stripe_3.stl` | 배지 · 스트라이프 · 소형 트림 | 36 × 3.1 × 1.1 | 0.1 | 0 | 0 | 가능 |
| `trim__stripe_0.stl` | 배지 · 스트라이프 · 소형 트림 | 40 × 3.2 × 0.8 | 0.1 | 0 | 0 | 가능 |
| `trim__stripe_1.stl` | 배지 · 스트라이프 · 소형 트림 | 40 × 3.2 × 0.8 | 0.1 | 0 | 0 | 가능 |
| `trim__stripe_2.stl` | 배지 · 스트라이프 · 소형 트림 | 40 × 3.2 × 0.8 | 0.1 | 0 | 0 | 가능 |
| `trim__stripe_3.stl` | 배지 · 스트라이프 · 소형 트림 | 40 × 3.2 × 0.8 | 0.1 | 0 | 0 | 가능 |
| `trim__toggle_plate.stl` | 배지 · 스트라이프 · 소형 트림 | 16 × 24 × 2 | 0.6 | 0.01 | 0 | 가능 |
| `trim__usb_bay_bezel.stl` | 배지 · 스트라이프 · 소형 트림 | 92 × 5 × 1.2 | 0.7 | 0.01 | 0 | 가능 |

## 분할 이음

각 이음에는 이음선 양쪽에 M3 인서트 보스 한 쌍과 출력 연결판(38 × 9 × 3 mm, `splices__*.stl`)이 들어갑니다. 조각을 맞대고 연결판을 M3 × 8 볼트로 고정하세요. 맞댄 면에 순간접착제나 3D 펜을 함께 쓰면 더 단단합니다.

| 그룹 | 분할면 법선 | 위치 (mm) | 이음 수 |
|---|---|---:|---:|
| tray | (1.00, 0.00, 0.00) | 0.0 | 2 |
| tray | (0.00, 1.00, 0.00) | 70.0 | 2 |
| lid | (1.00, 0.00, 0.00) | 0.0 | 4 |
| lid | (0.00, -1.00, -0.00) | -70.0 | 6 |
| bezel | (1.00, 0.00, 0.00) | 0.0 | 1 |
| bezel | (0.00, 0.00, -1.00) | -323.9 | 2 |
| shell | (1.00, 0.00, 0.00) | 0.0 | 6 |
| shell | (0.00, 0.00, -1.00) | -313.9 | 6 |
| cover | (1.00, 0.00, 0.00) | 0.0 | 2 |
| kbcase | (1.00, 0.00, 0.00) | 0.0 | 2 |
| kbbottom | (1.00, 0.00, 0.00) | 0.0 | 2 |
