cyborgroid/Retro_Analog_Pastel_Computer/environments/assembly/fasteners.csv

step | title | module | fasteners | torque | minutes
1 | 하부 트레이와 고무발 | 본체 | 고무발 Ø14 × 4 (양면 테이프) | — | 3
2 | 강판 섀시와 스탠드오프 | 본체 | M3 × 6 접시머리 × 6 / M3 스탠드오프 6 mm × 6 | 0.5 N·m | 5
3 | PX-80 메인보드 고정 | 본체 | M3 × 6 팬헤드 + 톱니와셔 × 6 | 0.45 N·m | 6
4 | IC 실장: CPU · EEPROM · SRAM · Pico · XTAL | 본체 | 40핀 · 28핀 DIP 소켓 / Pico용 20핀 헤더 × 4 | — | 8
5 | 전원부: 트랜스 · 방열판 · C1 | 본체 | M4 × 8 × 4 (트랜스) / M3 × 10 + 절연 부싱 × 3 (레귤레이터) | 트랜스 1.2 N·m / 레귤레이터 0.6 N·m | 7
6 | USB 저장장치 베이 (CH376S) | 본체 | M3 × 5 × 4 (측면) | 0.4 N·m | 4
7 | 배선 하네스: 리본 · 전원 · 스피커 | 본체 | 케이블 타이 100 mm × 6 / 리본 클램프 × 2 | — | 5
8 | 상판과 전면 다이얼 | 본체 | M3 × 12 셀프태핑 × 4 (하부에서) / 로터리 노브 세트스크루 M2 × 2 | 0.6 N·m | 4
9 | 틸트·스위블 스탠드 | 모니터 | M4 × 10 × 4 | 1.0 N·m | 3
10 | 슬림 베젤과 전면 유리 | 모니터 | 베젤 스냅 × 10 / M3 × 8 × 4 (하단 턱) | 0.5 N·m | 5
11 | 19" 16:10 CRT 튜브 삽입 | 모니터 | 튜브 이어 M5 × 16 × 4 | 2.5 N·m | 10
12 | 편향 요크와 넥 보드 | 모니터 | 요크 클램프 M3 × 1 / 넥 보드 소켓 | 0.3 N·m (클램프) | 8
13 | 플라이백과 디가우싱 코일 | 모니터 | 플라이백 브래킷 M3 × 2 / 디가우싱 코일 클립 × 4 | 0.5 N·m | 6
14 | 슬림 후면 셸 | 모니터 | M3 × 14 셀프태핑 × 6 | 0.6 N·m | 4
15 | 키보드 케이스와 매트릭스 PCB | 키보드 | M2.5 × 6 × 8 | 0.3 N·m | 6
16 | 키캡 장착 | 키보드 | 키캡 × 49 / 스페이스바 스태빌라이저 × 1 | — | 6
17 | 마우스 볼과 초퍼 엔코더 | 마우스 | 엔코더 축 클립 × 2 | — | 4
18 | 마우스 상부 셸 | 마우스 | M2 × 8 × 1 (하부) | 0.15 N·m | 2
19 | 케이블 연결: 키보드 · 마우스 · 비디오 | 연결 | DIN-5 · DE-9 · RCA 비디오 | — | 3
20 | 전원 투입과 POST 검수 | 검수 | — | — | 10
