cyborgroid/Retro_Analog_Pastel_Computer/cad/out/urdf/pastella84.urdf

<?xml version="1.0"?>
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
<robot name="pastella84">
  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
  <link name="desk">
  </link>
  <link name="base_tray">
    <inertial><origin xyz="0 0 0.00751" rpy="0 0 0"/><mass value="0.506007"/>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</inertial>
    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
  </link>
  <link name="base_internal">
    <inertial><origin xyz="0.048588 0.002238 -0.008544" rpy="0 0 0"/><mass value="3.398721"/>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</inertial>
    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
  </link>
  <link name="base_lid">
    <inertial><origin xyz="-0.003341 -0.002502 0.061187" rpy="0 0 0"/><mass value="0.670881"/>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</inertial>
    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
  </link>
  <link name="dial_vol">
    <inertial><origin xyz="0 -0.004518 0.000015" rpy="0 0 0"/><mass value="0.009893"/>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</inertial>
    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
  </link>
  <link name="dial_tone">
    <inertial><origin xyz="0 -0.004518 0.000015" rpy="0 0 0"/><mass value="0.009893"/>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</inertial>
    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
  </link>
  <link name="power_toggle">
    <inertial><origin xyz="0 -0.008877 0.005125" rpy="0 0 0"/><mass value="0.001145"/>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</inertial>
    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
  </link>
  <link name="knob_bright">
    <inertial><origin xyz="0 -0.002178 0" rpy="0 0 0"/><mass value="0.00065"/>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</inertial>
    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
  </link>
  <link name="knob_vhold">
    <inertial><origin xyz="0 -0.002178 0" rpy="0 0 0"/><mass value="0.00065"/>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</inertial>
    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
  </link>
  <link name="knob_hsize">
    <inertial><origin xyz="0 -0.002178 0" rpy="0 0 0"/><mass value="0.00065"/>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</inertial>
    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
  </link>
  <link name="monitor_stand">
    <inertial><origin xyz="0 0 0.004" rpy="0 0 0"/><mass value="0.274248"/>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</inertial>
    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
  </link>
  <link name="monitor_swivel">
    <inertial><origin xyz="0 0 0.017233" rpy="0 0 0"/><mass value="0.275229"/>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</inertial>
    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
  </link>
  <link name="monitor_body">
    <inertial><origin xyz="0.004038 0.000039 0.132475" rpy="0 0 0"/><mass value="12.66063"/>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</inertial>
    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
  </link>
  <link name="keyboard_case">
    <inertial><origin xyz="-0.000208 -0.006832 0.02156" rpy="0 0 0"/><mass value="0.562216"/>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</inertial>
    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
  </link>
  <link name="kb_foot_l">
    <inertial><origin xyz="0 -0.013 0.0027" rpy="0 0 0"/><mass value="0.00546"/>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</inertial>
    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
  </link>
  <link name="kb_foot_r">
    <inertial><origin xyz="0 -0.013 0.0027" rpy="0 0 0"/><mass value="0.00546"/>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</inertial>
    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
  </link>
  <link name="key_1">
    <inertial><origin xyz="0 -0.000157 0.004263" rpy="0 0 0"/><mass value="0.001698"/>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</inertial>
    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
  </link>
  <link name="key_2">
    <inertial><origin xyz="0 -0.000157 0.004263" rpy="0 0 0"/><mass value="0.001698"/>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</inertial>
    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
  </link>
  <link name="key_3">
    <inertial><origin xyz="0 -0.000157 0.004263" rpy="0 0 0"/><mass value="0.001698"/>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</inertial>
    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
  </link>
  <link name="key_4">
    <inertial><origin xyz="0 -0.000157 0.004263" rpy="0 0 0"/><mass value="0.001698"/>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</inertial>
    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
  </link>
  <link name="key_5">
    <inertial><origin xyz="0 -0.000157 0.004263" rpy="0 0 0"/><mass value="0.001698"/>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</inertial>
    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
  </link>
  <link name="key_6">
    <inertial><origin xyz="0 -0.000157 0.004263" rpy="0 0 0"/><mass value="0.001698"/>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</inertial>
    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
  </link>
  <link name="key_7">
    <inertial><origin xyz="0 -0.000157 0.004263" rpy="0 0 0"/><mass value="0.001698"/>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</inertial>
    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
  </link>
  <link name="key_8">
    <inertial><origin xyz="0 -0.000157 0.004263" rpy="0 0 0"/><mass value="0.001698"/>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</inertial>
    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
  </link>
  <link name="key_9">
    <inertial><origin xyz="0 -0.000157 0.004263" rpy="0 0 0"/><mass value="0.001698"/>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</inertial>
    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
  </link>
  <link name="key_0">
    <inertial><origin xyz="0 -0.000157 0.004263" rpy="0 0 0"/><mass value="0.001698"/>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</inertial>
    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
  </link>
  <link name="key_minus">
    <inertial><origin xyz="0 -0.000157 0.004263" rpy="0 0 0"/><mass value="0.001698"/>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</inertial>
    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
  </link>
  <link name="key_equal">
    <inertial><origin xyz="0 -0.000157 0.004263" rpy="0 0 0"/><mass value="0.001698"/>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</inertial>
    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
  </link>
  <link name="key_bksp">
    <inertial><origin xyz="0 -0.000148 0.004658" rpy="0 0 0"/><mass value="0.002192"/>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</inertial>
    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
  </link>
  <link name="key_q">
    <inertial><origin xyz="0 -0.000157 0.004263" rpy="0 0 0"/><mass value="0.001698"/>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</inertial>
    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
  </link>
  <link name="key_w">
    <inertial><origin xyz="0 -0.000157 0.004263" rpy="0 0 0"/><mass value="0.001698"/>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</inertial>
    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
  </link>
  <link name="key_e">
    <inertial><origin xyz="0 -0.000157 0.004263" rpy="0 0 0"/><mass value="0.001698"/>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</inertial>
    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
  </link>
  <link name="key_r">
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
    <inertial><origin xyz="0 -0.000157 0.004263" rpy="0 0 0"/><mass value="0.001698"/>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</inertial>
    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
  </link>
  <link name="key_slash">
    <inertial><origin xyz="0 -0.000157 0.004263" rpy="0 0 0"/><mass value="0.001698"/>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</inertial>
    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
  </link>
  <link name="key_space">
    <inertial><origin xyz="0 -0.000125 0.005582" rpy="0 0 0"/><mass value="0.00689"/>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</inertial>
    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
  </link>
  <link name="mouse_base">
    <inertial><origin xyz="0 0.001668 0.012105" rpy="0 0 0"/><mass value="0.039948"/>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</inertial>
    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
  </link>
  <link name="mouse_button">
    <inertial><origin xyz="0 -0.0175 0.002" rpy="0 0 0"/><mass value="0.007472"/>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</inertial>
    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
  </link>
  <link name="mouse_ball">
    <inertial><origin xyz="0 0 0" rpy="0 0 0"/><mass value="0.035"/>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</inertial>
    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
  </link>
  <link name="mouse_roller_x">
    <inertial><origin xyz="0 -0.001304 0" rpy="0 0 0"/><mass value="0.001426"/>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</inertial>
    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
  </link>
  <link name="mouse_roller_y">
    <inertial><origin xyz="-0.001304 0 0" rpy="0 0 0"/><mass value="0.001426"/>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</inertial>
    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
  </link>
  <joint name="dial_vol_joint" type="continuous"><parent link="base_lid"/><child link="dial_vol"/><origin xyz="0.05 -0.17 0.04" rpy="0 0 0"/>
    <axis xyz="0 -1 0"/>
    <limit effort="0.2" velocity="6"/><dynamics damping="0.01" friction="0"/>
  </joint>
  <joint name="dial_tone_joint" type="continuous"><parent link="base_lid"/><child link="dial_tone"/><origin xyz="0.1 -0.17 0.04" rpy="0 0 0"/>
    <axis xyz="0 -1 0"/>
    <limit effort="0.2" velocity="6"/><dynamics damping="0.01" friction="0"/>
  </joint>
  <joint name="power_toggle_joint" type="revolute"><parent link="base_lid"/><child link="power_toggle"/><origin xyz="0.16 -0.17 0.04" rpy="0 0 0"/>
    <axis xyz="1 0 0"/>
    <limit lower="-0.35" upper="0.35" effort="0.5" velocity="4"/><dynamics damping="0.01" friction="0"/>
  </joint>
  <joint name="knob_bright_joint" type="continuous"><parent link="monitor_body"/><child link="knob_bright"/><origin xyz="0.198622 -0.072799 -0.003" rpy="0 0 0"/>
    <axis xyz="0 -1 0"/>
    <limit effort="0.05" velocity="6"/><dynamics damping="0.01" friction="0"/>
  </joint>
  <joint name="knob_vhold_joint" type="continuous"><parent link="monitor_body"/><child link="knob_vhold"/><origin xyz="0.182622 -0.072799 -0.003" rpy="0 0 0"/>
    <axis xyz="0 -1 0"/>
    <limit effort="0.05" velocity="6"/><dynamics damping="0.01" friction="0"/>
  </joint>
  <joint name="knob_hsize_joint" type="continuous"><parent link="monitor_body"/><child link="knob_hsize"/><origin xyz="0.166622 -0.072799 -0.003" rpy="0 0 0"/>
    <axis xyz="0 -1 0"/>
    <limit effort="0.05" velocity="6"/><dynamics damping="0.01" friction="0"/>
  </joint>
  <joint name="monitor_swivel_joint" type="revolute"><parent link="monitor_stand"/><child link="monitor_swivel"/><origin xyz="0 0 0.008" rpy="0 0 0"/>
    <axis xyz="0 0 1"/>
    <limit lower="-1.570796" upper="1.570796" effort="5" velocity="1"/><dynamics damping="0.01" friction="0"/>
  </joint>
  <joint name="monitor_tilt_joint" type="revolute"><parent link="monitor_swivel"/><child link="monitor_body"/><origin xyz="0 0 0.062" rpy="0 0 0"/>
    <axis xyz="1 0 0"/>
    <limit lower="-0.087266" upper="0.20944" effort="20" velocity="0.5"/><dynamics damping="0.01" friction="0"/>
  </joint>
  <joint name="kb_foot_l_joint" type="revolute"><parent link="keyboard_case"/><child link="kb_foot_l"/><origin xyz="-0.11 0.067 0" rpy="0 0 0"/>
    <axis xyz="1 0 0"/>
    <limit lower="0" upper="1.658063" effort="1" velocity="2"/><dynamics damping="0.01" friction="0"/>
  </joint>
  <joint name="kb_foot_r_joint" type="revolute"><parent link="keyboard_case"/><child link="kb_foot_r"/><origin xyz="0.11 0.067 0" rpy="0 0 0"/>
    <axis xyz="1 0 0"/>
    <limit lower="0" upper="1.658063" effort="1" velocity="2"/><dynamics damping="0.01" friction="0"/>
  </joint>
  <joint name="key_1_joint" type="prismatic"><parent link="keyboard_case"/><child link="key_1"/><origin xyz="-0.119063 0.024109 0.033075" rpy="0 0 0"/>
    <axis xyz="0 0.106065 -0.994359"/>
    <limit lower="0" upper="0.004" effort="0.6" velocity="0.5"/><dynamics damping="0.01" friction="0"/>
  </joint>
  <joint name="key_2_joint" type="prismatic"><parent link="keyboard_case"/><child link="key_2"/><origin xyz="-0.100013 0.024109 0.033075" rpy="0 0 0"/>
    <axis xyz="0 0.106065 -0.994359"/>
    <limit lower="0" upper="0.004" effort="0.6" velocity="0.5"/><dynamics damping="0.01" friction="0"/>
  </joint>
  <joint name="key_3_joint" type="prismatic"><parent link="keyboard_case"/><child link="key_3"/><origin xyz="-0.080963 0.024109 0.033075" rpy="0 0 0"/>
    <axis xyz="0 0.106065 -0.994359"/>
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
    <axis xyz="0 0.106065 -0.994359"/>
    <limit lower="0" upper="0.004" effort="0.6" velocity="0.5"/><dynamics damping="0.01" friction="0"/>
  </joint>
  <joint name="key_t_joint" type="prismatic"><parent link="keyboard_case"/><child link="key_t"/><origin xyz="-0.028575 0.005167 0.031054" rpy="0 0 0"/>
    <axis xyz="0 0.106065 -0.994359"/>
    <limit lower="0" upper="0.004" effort="0.6" velocity="0.5"/><dynamics damping="0.01" friction="0"/>
  </joint>
  <joint name="key_y_joint" type="prismatic"><parent link="keyboard_case"/><child link="key_y"/><origin xyz="-0.009525 0.005167 0.031054" rpy="0 0 0"/>
    <axis xyz="0 0.106065 -0.994359"/>
    <limit lower="0" upper="0.004" effort="0.6" velocity="0.5"/><dynamics damping="0.01" friction="0"/>
  </joint>
  <joint name="key_u_joint" type="prismatic"><parent link="keyboard_case"/><child link="key_u"/><origin xyz="0.009525 0.005167 0.031054" rpy="0 0 0"/>
    <axis xyz="0 0.106065 -0.994359"/>
    <limit lower="0" upper="0.004" effort="0.6" velocity="0.5"/><dynamics damping="0.01" friction="0"/>
  </joint>
  <joint name="key_i_joint" type="prismatic"><parent link="keyboard_case"/><child link="key_i"/><origin xyz="0.028575 0.005167 0.031054" rpy="0 0 0"/>
    <axis xyz="0 0.106065 -0.994359"/>
    <limit lower="0" upper="0.004" effort="0.6" velocity="0.5"/><dynamics damping="0.01" friction="0"/>
  </joint>
  <joint name="key_o_joint" type="prismatic"><parent link="keyboard_case"/><child link="key_o"/><origin xyz="0.047625 0.005167 0.031054" rpy="0 0 0"/>
    <axis xyz="0 0.106065 -0.994359"/>
    <limit lower="0" upper="0.004" effort="0.6" velocity="0.5"/><dynamics damping="0.01" friction="0"/>
  </joint>
  <joint name="key_p_joint" type="prismatic"><parent link="keyboard_case"/><child link="key_p"/><origin xyz="0.066675 0.005167 0.031054" rpy="0 0 0"/>
    <axis xyz="0 0.106065 -0.994359"/>
    <limit lower="0" upper="0.004" effort="0.6" velocity="0.5"/><dynamics damping="0.01" friction="0"/>
  </joint>
  <joint name="key_lbracket_joint" type="prismatic"><parent link="keyboard_case"/><child link="key_lbracket"/><origin xyz="0.085725 0.005167 0.031054" rpy="0 0 0"/>
    <axis xyz="0 0.106065 -0.994359"/>
    <limit lower="0" upper="0.004" effort="0.6" velocity="0.5"/><dynamics damping="0.01" friction="0"/>
  </joint>
  <joint name="key_rbracket_joint" type="prismatic"><parent link="keyboard_case"/><child link="key_rbracket"/><origin xyz="0.104775 0.005167 0.031054" rpy="0 0 0"/>
    <axis xyz="0 0.106065 -0.994359"/>
    <limit lower="0" upper="0.004" effort="0.6" velocity="0.5"/><dynamics damping="0.01" friction="0"/>
  </joint>
  <joint name="key_a_joint" type="prismatic"><parent link="keyboard_case"/><child link="key_a"/><origin xyz="-0.111919 -0.013776 0.029033" rpy="0 0 0"/>
    <axis xyz="0 0.106065 -0.994359"/>
    <limit lower="0" upper="0.004" effort="0.6" velocity="0.5"/><dynamics damping="0.01" friction="0"/>
  </joint>
  <joint name="key_s_joint" type="prismatic"><parent link="keyboard_case"/><child link="key_s"/><origin xyz="-0.092869 -0.013776 0.029033" rpy="0 0 0"/>
    <axis xyz="0 0.106065 -0.994359"/>
    <limit lower="0" upper="0.004" effort="0.6" velocity="0.5"/><dynamics damping="0.01" friction="0"/>
  </joint>
  <joint name="key_d_joint" type="prismatic"><parent link="keyboard_case"/><child link="key_d"/><origin xyz="-0.073819 -0.013776 0.029033" rpy="0 0 0"/>
    <axis xyz="0 0.106065 -0.994359"/>
    <limit lower="0" upper="0.004" effort="0.6" velocity="0.5"/><dynamics damping="0.01" friction="0"/>
  </joint>
  <joint name="key_f_joint" type="prismatic"><parent link="keyboard_case"/><child link="key_f"/><origin xyz="-0.054769 -0.013776 0.029033" rpy="0 0 0"/>
    <axis xyz="0 0.106065 -0.994359"/>
    <limit lower="0" upper="0.004" effort="0.6" velocity="0.5"/><dynamics damping="0.01" friction="0"/>
  </joint>
  <joint name="key_g_joint" type="prismatic"><parent link="keyboard_case"/><child link="key_g"/><origin xyz="-0.035719 -0.013776 0.029033" rpy="0 0 0"/>
    <axis xyz="0 0.106065 -0.994359"/>
    <limit lower="0" upper="0.004" effort="0.6" velocity="0.5"/><dynamics damping="0.01" friction="0"/>
  </joint>
  <joint name="key_h_joint" type="prismatic"><parent link="keyboard_case"/><child link="key_h"/><origin xyz="-0.016669 -0.013776 0.029033" rpy="0 0 0"/>
    <axis xyz="0 0.106065 -0.994359"/>
    <limit lower="0" upper="0.004" effort="0.6" velocity="0.5"/><dynamics damping="0.01" friction="0"/>
  </joint>
  <joint name="key_j_joint" type="prismatic"><parent link="keyboard_case"/><child link="key_j"/><origin xyz="0.002381 -0.013776 0.029033" rpy="0 0 0"/>
    <axis xyz="0 0.106065 -0.994359"/>
    <limit lower="0" upper="0.004" effort="0.6" velocity="0.5"/><dynamics damping="0.01" friction="0"/>
  </joint>
  <joint name="key_k_joint" type="prismatic"><parent link="keyboard_case"/><child link="key_k"/><origin xyz="0.021431 -0.013776 0.029033" rpy="0 0 0"/>
    <axis xyz="0 0.106065 -0.994359"/>
    <limit lower="0" upper="0.004" effort="0.6" velocity="0.5"/><dynamics damping="0.01" friction="0"/>
  </joint>
  <joint name="key_l_joint" type="prismatic"><parent link="keyboard_case"/><child link="key_l"/><origin xyz="0.040481 -0.013776 0.029033" rpy="0 0 0"/>
    <axis xyz="0 0.106065 -0.994359"/>
    <limit lower="0" upper="0.004" effort="0.6" velocity="0.5"/><dynamics damping="0.01" friction="0"/>
  </joint>
  <joint name="key_semicolon_joint" type="prismatic"><parent link="keyboard_case"/><child link="key_semicolon"/><origin xyz="0.059531 -0.013776 0.029033" rpy="0 0 0"/>
    <axis xyz="0 0.106065 -0.994359"/>
    <limit lower="0" upper="0.004" effort="0.6" velocity="0.5"/><dynamics damping="0.01" friction="0"/>
  </joint>
  <joint name="key_quote_joint" type="prismatic"><parent link="keyboard_case"/><child link="key_quote"/><origin xyz="0.078581 -0.013776 0.029033" rpy="0 0 0"/>
    <axis xyz="0 0.106065 -0.994359"/>
    <limit lower="0" upper="0.004" effort="0.6" velocity="0.5"/><dynamics damping="0.01" friction="0"/>
  </joint>
  <joint name="key_enter_joint" type="prismatic"><parent link="keyboard_case"/><child link="key_enter"/><origin xyz="0.104775 -0.013776 0.029033" rpy="0 0 0"/>
    <axis xyz="0 0.106065 -0.994359"/>
    <limit lower="0" upper="0.004" effort="0.6" velocity="0.5"/><dynamics damping="0.01" friction="0"/>
  </joint>
  <joint name="key_shift_joint" type="prismatic"><parent link="keyboard_case"/><child link="key_shift"/><origin xyz="-0.09525 -0.032718 0.027013" rpy="0 0 0"/>
    <axis xyz="0 0.106065 -0.994359"/>
    <limit lower="0" upper="0.004" effort="0.6" velocity="0.5"/><dynamics damping="0.01" friction="0"/>
  </joint>
  <joint name="key_z_joint" type="prismatic"><parent link="keyboard_case"/><child link="key_z"/><origin xyz="-0.069056 -0.032718 0.027013" rpy="0 0 0"/>
    <axis xyz="0 0.106065 -0.994359"/>
    <limit lower="0" upper="0.004" effort="0.6" velocity="0.5"/><dynamics damping="0.01" friction="0"/>
  </joint>
  <joint name="key_x_joint" type="prismatic"><parent link="keyboard_case"/><child link="key_x"/><origin xyz="-0.050006 -0.032718 0.027013" rpy="0 0 0"/>
    <axis xyz="0 0.106065 -0.994359"/>
    <limit lower="0" upper="0.004" effort="0.6" velocity="0.5"/><dynamics damping="0.01" friction="0"/>
  </joint>
  <joint name="key_c_joint" type="prismatic"><parent link="keyboard_case"/><child link="key_c"/><origin xyz="-0.030956 -0.032718 0.027013" rpy="0 0 0"/>
    <axis xyz="0 0.106065 -0.994359"/>
    <limit lower="0" upper="0.004" effort="0.6" velocity="0.5"/><dynamics damping="0.01" friction="0"/>
  </joint>
  <joint name="key_v_joint" type="prismatic"><parent link="keyboard_case"/><child link="key_v"/><origin xyz="-0.011906 -0.032718 0.027013" rpy="0 0 0"/>
    <axis xyz="0 0.106065 -0.994359"/>
    <limit lower="0" upper="0.004" effort="0.6" velocity="0.5"/><dynamics damping="0.01" friction="0"/>
  </joint>
  <joint name="key_b_joint" type="prismatic"><parent link="keyboard_case"/><child link="key_b"/><origin xyz="0.007144 -0.032718 0.027013" rpy="0 0 0"/>
    <axis xyz="0 0.106065 -0.994359"/>
    <limit lower="0" upper="0.004" effort="0.6" velocity="0.5"/><dynamics damping="0.01" friction="0"/>
  </joint>
  <joint name="key_n_joint" type="prismatic"><parent link="keyboard_case"/><child link="key_n"/><origin xyz="0.026194 -0.032718 0.027013" rpy="0 0 0"/>
    <axis xyz="0 0.106065 -0.994359"/>
    <limit lower="0" upper="0.004" effort="0.6" velocity="0.5"/><dynamics damping="0.01" friction="0"/>
  </joint>
  <joint name="key_m_joint" type="prismatic"><parent link="keyboard_case"/><child link="key_m"/><origin xyz="0.045244 -0.032718 0.027013" rpy="0 0 0"/>
    <axis xyz="0 0.106065 -0.994359"/>
    <limit lower="0" upper="0.004" effort="0.6" velocity="0.5"/><dynamics damping="0.01" friction="0"/>
  </joint>
  <joint name="key_comma_joint" type="prismatic"><parent link="keyboard_case"/><child link="key_comma"/><origin xyz="0.064294 -0.032718 0.027013" rpy="0 0 0"/>
    <axis xyz="0 0.106065 -0.994359"/>
    <limit lower="0" upper="0.004" effort="0.6" velocity="0.5"/><dynamics damping="0.01" friction="0"/>
  </joint>
  <joint name="key_period_joint" type="prismatic"><parent link="keyboard_case"/><child link="key_period"/><origin xyz="0.083344 -0.032718 0.027013" rpy="0 0 0"/>
    <axis xyz="0 0.106065 -0.994359"/>
    <limit lower="0" upper="0.004" effort="0.6" velocity="0.5"/><dynamics damping="0.01" friction="0"/>
  </joint>
  <joint name="key_slash_joint" type="prismatic"><parent link="keyboard_case"/><child link="key_slash"/><origin xyz="0.102394 -0.032718 0.027013" rpy="0 0 0"/>
    <axis xyz="0 0.106065 -0.994359"/>
    <limit lower="0" upper="0.004" effort="0.6" velocity="0.5"/><dynamics damping="0.01" friction="0"/>
  </joint>
  <joint name="key_space_joint" type="prismatic"><parent link="keyboard_case"/><child link="key_space"/><origin xyz="0 -0.051661 0.024992" rpy="0 0 0"/>
    <axis xyz="0 0.106065 -0.994359"/>
    <limit lower="0" upper="0.004" effort="0.6" velocity="0.5"/><dynamics damping="0.01" friction="0"/>
  </joint>
  <joint name="mouse_button_joint" type="revolute"><parent link="mouse_base"/><child link="mouse_button"/><origin xyz="0 -0.0085 0.027" rpy="0 0 0"/>
    <axis xyz="1 0 0"/>
    <limit lower="0" upper="0.05236" effort="0.3" velocity="2"/><dynamics damping="0.01" friction="0"/>
  </joint>
  <joint name="mouse_ball_joint" type="continuous"><parent link="mouse_base"/><child link="mouse_ball"/><origin xyz="0 0.015 0.0113" rpy="0 0 0"/>
    <axis xyz="1 0 0"/>
    <limit effort="0.1" velocity="20"/><dynamics damping="0.01" friction="0"/>
  </joint>
  <joint name="mouse_roller_x_joint" type="continuous"><parent link="mouse_base"/><child link="mouse_roller_x"/><origin xyz="0.014 0.011 0.0113" rpy="0 0 0"/>
    <axis xyz="0 1 0"/>
    <limit effort="0.01" velocity="60"/><dynamics damping="0.01" friction="0"/>
  </joint>
  <joint name="mouse_roller_y_joint" type="continuous"><parent link="mouse_base"/><child link="mouse_roller_y"/><origin xyz="-0.004 0.029 0.0113" rpy="0 0 0"/>
    <axis xyz="1 0 0"/>
    <limit effort="0.01" velocity="60"/><dynamics damping="0.01" friction="0"/>
  </joint>
  <joint name="desk_to_base" type="fixed"><parent link="desk"/><child link="base_tray"/><origin xyz="0 0.07 0" rpy="0 0 0"/>
  </joint>
  <joint name="base_tray_to_internal" type="fixed"><parent link="base_tray"/><child link="base_internal"/><origin xyz="0 0 0.033" rpy="0 0 0"/>
  </joint>
  <joint name="base_tray_to_lid" type="fixed"><parent link="base_tray"/><child link="base_lid"/><origin xyz="0 0 0.033" rpy="0 0 0"/>
  </joint>
  <joint name="lid_to_monitor_stand" type="fixed"><parent link="base_lid"/><child link="monitor_stand"/><origin xyz="0 -0.047201 0.08" rpy="0 0 0"/>
  </joint>
  <joint name="desk_to_keyboard" type="fixed"><parent link="desk"/><child link="keyboard_case"/><origin xyz="0 -0.245 0" rpy="0 0 0"/>
  </joint>
  <joint name="desk_to_mouse" type="fixed"><parent link="desk"/><child link="mouse_base"/><origin xyz="0.255 -0.235 0" rpy="0 0 0"/>
  </joint>
</robot>
