cyborgroid/Retro_Analog_Pastel_Computer/(commit log)

2026-10-25 HTML & SRC
    [bom-sourcing.csv, fasteners.csv]
2026-10-26 CAD v3: Rust B-rep build (STEP/URDF/USDA/GLB) + C# validator, web CAD view
    - cad/spec.json: single design source (dimensions, key layout, materials, densities)
    - cad/rust (pastella-cad): truck B-rep without booleans -> STEP AP214 with part
    names and colours, URDF + STL with mass/inertia, USDA with UsdPhysics joints,
    GLB for the workbench; checks for watertightness, interference and 63 joint sweeps
    - cad/csharp (Pastella.Validate): cross-checks URDF, USDA, STEP, GLB, report and spec
    - cad/build.sh: "rust" (Only Rust) and "csharp-rust" pipelines
    - Design v3 from reference photos (environments/chassis/references.md): 19.05 mm
    MX key pitch with stock keycap sizes, stepped bezel, flat-botto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
    [base_internal__alu.stl, base_internal__chip.stl, base_internal__dark.stl, base_internal__pcb.stl, base_internal__steel.stl, base_internal__trim.stl, base_lid__base.stl, base_lid__dark.stl]
2026-10-26 Real build variant: LCD, 3D-printed split housings, BOM; reference image collector
    - cad/rust builds two variants from spec.json: concept (cad/out, CRT) and
    build (cad/out/build): AUO M190PW01 LCD + controller board, external 12 V
    adapter + buck module, printed housings with M3 heat-set insert bosses,
    panel clips, screw columns, lazy-susan swivel, PMW3360 mouse, FR4 plate
    - fab.rs (boolmesh): unite/cut printed groups, orient for printing, split to
    a 256 mm bed, place seam joints (insert boss pairs + splice plates) with
    wall/clearance checks; 94 STL pieces, print plan, BOM, plate DXF
    - C# validator covers both variants plus pieces, BOM and DXF (74 checks)
    - Workbench: Chassis shows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
    [base_internal__alu.stl, base_internal__chip.stl, base_internal__dark.stl, base_internal__pcb.stl, base_internal__steel.stl, base_lid__alu.stl, base_lid__base.stl, base_lid__dark.stl]
2026-10-26 Learned colourways from reference photos; Archive Pastel as default
    - tools/refs/palette.py turns the analysed reference palette into two
    colourways: Archive Beige (colours of the photographed machines) and
    Archive Pastel (same hue structure lifted into the pastel band)
    - Archive Pastel is the CAD build default and the workbench first-visit
    colourway; rebuilt cad/out with it (all checks pass, C# 74/74)
    - ingest.py --analyse-only analyses whatever is downloaded so far;
    references-web.md summarises the 568 analysed photos
    [pastella84.step, pastella84.urdf, shell_a2.stl, shell_b2.stl]
